chanulee/audiostream-esp32/hardware/lovelace-as-008/REVIEW_NETLIST.md

# 넷리스트 독립 검토 (1단계) — 2026-10-16, AS-003 rev A에서 수행, AS-004·AS-005·AS-006 rev A에 해당, AS-007은 J2 배정만 다름(REVIEW.md 2번), AS-008은 U6 ITIMER에 미실장 C26 랜드(ITIMER 넷)만 더함

DRC·ERC·parity·Gerber netcheck는 모두 `plan_pcb.py`를 정답으로 삼습니다. 그래서 넷리스트 자체가 틀리면 전부 0으로 통과합니다. 이 검토는 **데이터시트만 보고 핀별 기대값을 먼저 적은 뒤** 넷리스트와 비교했습니다. 기대값 표는 [`pinout_check.py`](pinout_check.py)에 있고, `make_board.sh`가 배치 검사 직후 실행합니다. 하나라도 다르면 빌드가 멈춥니다.

## 0. 현재 주문 파일 (AS-008 rev A)

아래 해시는 2026-10-20 현재 파일에서 계산했습니다. 앞의 AS-003 독립 검토와 아래의 과거 기록은 설계 근거이며, 주문 파일 지정은 이 절을 따릅니다.

| 파일 | SHA-256 |
|---|---|
| [`lovelace-as-008-revA-release.zip`](lovelace-as-008-revA-release.zip) | `01da18469ebcb7702c129164d3dc142bf781da75446652fb82398336b2845529` |
| [`bom.csv`](bom.csv) | `63efb1a932b8444062064e5163f01547d461f085fff92a41f919e3ea00788fb6` |
| [`cpl.csv`](cpl.csv) | `d836b545e0dbe416fe5d3f2d6747f33e5226ebdd0a2a1dfac366df7fc4c0a239` |

주문에는 이 폴더의 세 파일을 함께 사용합니다. ZIP 안의 BOM·CPL도 외부 파일과 같아야 합니다. 보드를 바꾸거나 파일을 재생성하면 다시 검증하고 해시를 갱신하세요. 주문 화면에서 확인할 항목은 [BRINGUP.md 1절](BRINGUP.md)에 있습니다.

사용자가 전달한 재검토 결과(2026-10-20): DRC·미연결·parity·ERC 0건, 핀 142/142·패드 55/55·디커플링 19/19, Gerber 쇼트·단선·구리 없는 패드 0건, ZIP 17개 파일 및 실장 부품 53개 일치. 아래의 138/138 등은 2026-10-16 검토 당시 수치입니다. 실물 및 JLC 최종 배치 화면 검증은 남아 있습니다.

## 1. 핀 대조 결과: 138 / 138 일치

| 부품 | 근거 | 확인한 것 | 결과 |
|---|---|---|---|
| U1 ESP32-WROVER-E | Espressif 데이터시트 표 3·그림 5 | 39개 핀 번호와 이름, 사용하는 12개 핀의 넷 | 일치 |
| U1 스트래핑 | 같은 문서 표 4 (Boot Configurations) | IO2·IO12(MTDI)·IO15(MTDO)·IO5는 연결 없음 → 내부 풀 기본값(다운로드 가능, 3.3V 플래시). IO0은 10k 풀업 + 버튼 | 문제 없음 |
| U1 EN | 같은 문서 9절 (RC 지연 10kΩ / 1µF 권장) | R5 10k + C1 1µF | 일치 |
| U2 PCM5102A | SLAS859C Pin Functions, 표 12 | 20핀 전부. DEMP·FLT·FMT·SCK = GND(디엠퍼시스 끔, 일반 필터, I2S, BCK에서 PLL). LDOO 0.1µF(표 12), 470Ω/2.2nF 출력 RC | 일치 |
| U2 클럭 | SLAS859C (16비트에서 BCK 32/48/64fS 허용) | 펌웨어는 16비트 Philips 스테레오 = 32fS, BCK 21 / WS 18 / DO 19 / MUTE 22 / LED 23 / 버튼 0 | 일치 |
| U3 TPS62162 | SLVSAM2E Pin Functions | 8핀 + EP. FB → AGND(고정 전압판 권장), PG 연결 없음. 2.2µH + 22µF는 표 2의 표준 조합 | 일치 |
| U4 TPS7A2033 DBV | TPS7A20 Pin Functions (SOT-23 열) | 1 IN, 2 GND, 3 EN(IN에 묶음), 4 NC, 5 OUT. 출력 용량 약 30µF(허용 1–200µF) | 일치 |
| U6 TPS259470A | SLVSFC9C 표 5-1 | 10핀. AUXOFF·FLT 개방 허용(오픈 드레인), ITIMER 개방 = 가장 빠른 응답 | 일치 |
| U6 계산 | 같은 문서 7.3.5, 전기 특성 | OVLO 1.2×(1+383/100) = 5.80V, UVLO 1.2×(1+255/100) = 4.26V, ILIM = 3334/5.1k = 0.65A(데이터시트 ±15% → 0.56–0.75A), A = 자동 재시도(110ms) | 일치 |
| U5 USBLC6-2SC6 | ST 핀 배치(1/6 I/O1, 3/4 I/O2, 2 GND, 5 VBUS) | D+ 1·6, D− 3·4, VBUS = +5V | 일치 |
| U7 CH340N | WCH 핀 배치, JLC 심볼 | 1 UD+, 2 UD−, 5 VCC + 8 V3 = 3.3V, 6 TXD → ESP32 RXD0, 7 RXD ← ESP32 TXD0(교차 맞음) | 일치 |
| J1 HRO TYPE-C-31-M-12 | JLC 심볼 | D+ A6/B6, D− A7/B7, CC1/CC2에 각각 5.1k, SBU 연결 없음 | 일치 |
| D5·D4·C25 극성(JLC 번호 기준) | JLC 심볼 + 부품 데이터 | D5 K = +5V_DAC, D4 K = GND, C25 + = +5V_DAC | JLC 번호 기준 일치. D4 제조사 번호와의 차이는 [REVIEW.md 11번](REVIEW.md) 확인 필요 |
| BOM 실제 부품 | JLC 부품 API의 LCSC 번호별 설명 | 33개 LCSC 번호가 의도한 값·정격·패키지와 일치(예: R14 0.1% 박막, C25 T520B227M006ATE025) | 일치 |

**검사기 자체 확인:** `design.json` 복사본에서 CH340N TXD/RXD를 바꾸고 PCM5102A FMT를 3.3V로 바꿨더니, 세 곳 모두 MISMATCH로 잡고 종료 코드 1을 냈습니다.

## 2. 핀은 맞지만 확인이 필요한 것

1. **[Minor, 실측 확인 — R15 5.1k 유지, 절차는 [BRINGUP.md](BRINGUP.md) 7절] eFuse 전류 제한 여유는 약 40%입니다.** ESP32-WROVER-E 데이터시트 표 16에서 모듈 피크는 350mA입니다(802.11b 1Mbps, 19.5dBm, 송신 100% 듀티). 버크 효율을 85%로 잡으면 4.75V 입력에서 0.29A이고, DAC LDO 31mA와 CH340N·LED를 더하면 약 0.33A입니다. ILIM 최소값 0.56A보다 0.23A 낮습니다. 시뮬레이션(4절)에서는 3.3V 쪽 피크가 0.6A(5V 입력)·0.5A(4.4V 입력)까지 버텼습니다. 데이터시트 피크의 1.4–1.6배입니다. 처음 적은 0.45A는 데이터시트의 "외부 전원은 0.5A 이상 공급" 권장값을 부하로 잘못 쓴 계산이었습니다. 그 값은 공급 능력 기준이고 실제 부하가 아닙니다. Bluetooth와 Wi-Fi는 시분할이라 전류가 더해지지 않습니다. TPS259470A는 한계를 넘으면 끊지 않고 전류를 제한합니다. 그래도 버크는 입력이 약 3.5V 이상이면 3.3V를 유지하므로, 문제는 ESP32 리셋 외에 DAC 전원·출력 잡음으로도 나타날 수 있습니다. 첫 보드에서는 웹 UI의 리셋 원인과 업타임으로 이를 확인합니다. 리셋이 생기면 R15를 4.3k로 바꿉니다(0.78A, 0.66–0.89A). 다만 Rd만 있는 USB-C 기본 전원 상한(500/900mA)에 가까워집니다.
2. **[Minor] 인덕터 포화 전류 2.1A < TPS62162 전류 제한 최대 2.45A.** Murata DFE201612P-2R2M 표의 최대값은 인덕턴스 30% 감소 기준 2.1A(typ 2.3A), 온도 상승 40°C 기준 1.5A(typ 1.8A)입니다(이전 판은 둘을 뒤바꿔 적었습니다). 정상 부하(피크 약 0.6A)에서는 문제가 없습니다. 3.3V 쇼트나 과부하 때만 인덕터가 포화합니다.
3. **[Minor] 상태 LED가 어두울 수 있습니다.** `plan_pcb.py` 주석은 Vf를 약 2.9V로 적었지만, JLC 데이터의 KT-0603G는 5mA에서 Vf 3.1V(에메랄드 그린)입니다. 3.3V와 220Ω이면 약 1–2mA라 어둡게 켜집니다. 밝기가 중요하면 R18을 100Ω으로 바꿉니다.
4. **[Minor] C25 감액.** 6.3V 폴리머 탄탈은 10% 감액 기준으로 5.67V까지 권장됩니다. 평소 4.7V에서는 문제없고, 입력이 OVLO 한계 6.0V일 때만 약 5.7V가 됩니다.

## 3. 아직 독립 출처가 하나뿐인 것

- CH340N, USBLC6, HRO USB-C는 JLC 심볼과 알고 있는 핀 배치로만 대조했습니다. 제조사 PDF 원문(WCH CH340DS1, ST USBLC6-2, HRO 도면) 대조가 남았습니다. ST 다운로드는 이번에 실패했습니다.
- PJ-320D의 Tip/Ring은 REVIEW.md 2번 그대로입니다(Shou Han 도면에 핀 기능 표기 없음). 첫 보드에서 좌/우 테스트 음원으로 확인합니다.

## 4. 전원 경로 시뮬레이션 (ngspice, 2026-10-20 보강)

[`sim/power_path.py`](sim/power_path.py)는 USB/케이블 → eFuse → 버크/ESP32 및 D5/C25/LDO/DAC를 모델링합니다. 최신 결과는 [`reports/sim.json`](reports/sim.json), 검사 범위와 보드 검증 결과는 [VALIDATION_RESULTS.md](VALIDATION_RESULTS.md)에 있습니다.

- 기동 3조건과 0.37A 펄스 부하 6조건은 기존 기준(3V3 3.2V 이상, 전류 제한 조건)을 유지해 통과했습니다. 0.5–0.9A의 과부하 탐색 30조건은 `STRESS_ONLY`로 분리하며 전부 정상 동작했다는 뜻이 아닙니다.
- 홀드업은 입력 5.0/4.4V × ESP 80/250mA × C25 220/176µF × DAC 31/45mA = 16조건입니다. 4.4V 입력은 저전압 스트레스이고, 실제 기동 가능 여부에는 UVLO 오차도 영향을 줍니다.
- DAC 세 전원이 공통이므로 DVDD/CPVDD 권장 하한 **3.1V**를 기준으로 측정합니다. clock-stop 기준은 **3ms**, XSMT 경로는 별도로 **150/fs + 0.2ms**입니다. XSMT 파형은 모델에 없어서 `UNVERIFIED`로 남깁니다. 과거 clock-loss에 3.6ms 공식을 적용한 설명은 이 절로 대체합니다.

| 입력 / ESP 부하 | C25 / DAC 부하 | 클럭 정지 가정 후 3.1V까지 | clock-stop 판정 |
|---|---|---:|---|
| 5.0V / 80mA | 220µF / 31mA | 11.029ms | PASS |
| 5.0V / 80mA | 176µF / 45mA | 5.765ms | PASS |
| 4.4V / 80mA | 220µF / 31mA | 6.731ms | PASS |
| 4.4V / 80mA | 176µF / 45mA | 3.441ms | PASS |
| 4.4V / 250mA | 176µF / 45mA | 3.569ms | PASS |

최소 결과는 3ms 기준 대비 **0.441ms** 여유입니다. ESP32 2.43V 도달 시 I2S가 멈춘다는 가정, 이상적인 버크, LDO 고정 20mV 강하, 저항성 DAC 부하는 유지했습니다. 45mA는 25°C 데이터시트 조건이며 모든 온도의 최대값을 보장하지 않습니다. 실제 전류·클럭 정지·mute·팝·스위칭 과도응답은 미검증입니다.

**다시 돌리기:** `python3 sim/power_path.py`(PATH에 ngspice 필요). 기준 미달은 exit 1, 해석 미완료/timeout/측정 누락/수렴 오류는 `UNVERIFIED`와 exit 2입니다. 마지막 해석 시각과 모든 필수 측정값의 유한성까지 확인합니다. `make_board.sh`도 release 생성 전에 이 검사를 실행합니다. 회귀 테스트는 저장소 루트에서 `python3 -m unittest discover -s tests -p test_hardware_validation.py -v`로 실행합니다.

## 다음 단계

2단계(물리 대응): 각 MPN 도면으로 랜드 패턴과 1번 핀 표시를 확인하고, 커넥터 방향, 케이스 간섭, 3D 모델을 봅니다.
