chanulee/audiostream-esp32/hardware/lovelace-as-008/REVIEW.md

# AS-003 rev A 검토 — 2026-10-15 (AS-004, AS-005, AS-006, AS-007, AS-008에도 해당)

(AS-002 rev C를 검토하며 찾은 문제를 고쳐 AS-003으로 올렸습니다. 이전 판은 [archive/04](../archive/04-lovelace-as-002-revC/README.md). AS-004는 넷리스트·배치가 AS-003과 같아 아래 내용이 그대로 적용됩니다. 배선 변경은 [REVIEW_LAYOUT.md](REVIEW_LAYOUT.md)에 있습니다.)

범위: 넷리스트, 배치, 배선, 제작 파일, JLC 조립 데이터, 펌웨어 핀 대응, 제조사 데이터시트 대조. 도구는 다음과 같습니다.
- pcb-layout-skill(`placement_check`, `audit_release`, `gerber_check`)
- KiCad 10 DRC/ERC/parity, `audit_pcb.py`, `jlc_check.py`
- KiCadRoutingTools v0.23.0, FreeRouting 2.5.0(비교용)

데이터시트: TI PCM5102A(SLAS859C), TPS62162(SLVSAM2E), TPS25947(SLVSFC9C), TPS7A20(SBVS338), Espressif ESP32-WROVER-E v2.4, Shou Han·HRO PJ-320D 도면, JLC/EasyEDA 부품 데이터(BOM 전 부품).

**실물 측정은 없습니다.** 첫 보드 절차는 [BRINGUP.md](BRINGUP.md)에 있습니다.

## 발견 사항 (심각도 순)

1. **[Critical, 수정함] CPL 회전이 JLC 기준과 달랐음.** KiCad와 JLC(EasyEDA)는 같은 패키지의 0° 방향이 다릅니다. KiCad 회전을 CPL에 그대로 쓰면 U2(PCM5102A) 180→90, U4(LDO) 0→180, U5(USBLC6) 0→270, U7(CH340N) 0→270, C25(탄탈) 90→270이 됩니다. 즉 IC 4개가 돌아가고 탄탈 극성이 뒤집힌 채 실장됩니다. 수정: `jlc_check.py`가 JLC 풋프린트를 받아 핀 번호 기준으로 우리 패드에 맞추고, 그 회전과 원점으로 `cpl.csv`를 씁니다. 53개 부품 모두 일치하며 IC 오차는 0.05mm 이하입니다. 남은 확인: JLC 주문 화면의 배치 미리보기(BRINGUP.md 표). 신뢰도: 높음.
2. **[Major, 수정함] AUX 잭 Tip/Ring 배정 오류.** KiCad 풋프린트의 패드 이름(T/R1/R2/S)이 실제 접점과 맞지 않았습니다. HRO 도면과 접점 깊이로 보면 뒤쪽 단독 패드가 Tip입니다. 수정 전에는 Tip이 접지되고 R이 슬리브와 쇼트됐습니다. `audit_pcb.py`가 개구부에서의 거리 순서로 검사합니다. 남은 확인: 첫 보드에서 좌/우 테스트 음원. 신뢰도: 중간(Shou Han 도면에 핀 기능 표기 없음).
   **[Major, AS-007에서 다시 수정] 위 배정도 틀렸습니다.** 단자 위치를 접점 위치로 본 가정이 틀렸습니다. LCSC 엔지니어 회신(2026-10-16)은 A = Tip, D = Ring 1, C = Ring 2, B = Sleeve이고, 도면 회로도(OA–OD)의 순서와도 같습니다. AS-006까지는 D가 GND, B가 LINE_R이어서 오른쪽 채널이 나오지 않았을 것입니다(LINE_R이 상대 기기 접지로 들어가고 플러그의 Ring은 접지됨, 470Ω R12가 전류를 제한해 손상은 없음). AS-007은 D = LINE_R, B·C = GND이고, `pinout_check.py`에 J2 항목을 추가했습니다. 신뢰도: 높음(제조사 측 회신 + 도면 회로도). 남은 확인: 실물 잭 연속성 또는 첫 보드 좌/우 음원.
3. **[Major, 수정함] 팝 잡음.** XSMT가 +3V3_D에 묶여 있어 부팅·리셋·샘플레이트 변경·전원 차단 때 팝을 막을 수단이 없었습니다. 수정 내용은 다음과 같습니다.
   - XSMT를 GPIO22 + 10k 풀다운(기본 뮤트)으로 바꿨습니다. 펌웨어는 I2S가 20ms 돈 뒤 해제하고, 클럭 변경·flush·재시작 전에 다시 뮤트합니다.
   - DAC 전원(AVDD·CPVDD·DVDD)을 모두 LDO(+3V3_A)로 옮겼습니다. LDO 입력은 쇼트키 D5와 220µF C25로 홀드업합니다. USB를 뽑으면 ESP32가 먼저 꺼져 클럭이 멈추고, DAC는 계산상 9.6ms(4.4V 입력에서 5.3ms) 동안 전원을 유지해 3.6ms짜리 클럭 정지 소프트 뮤트를 마칩니다.
   - 부수 효과로 LDO 입력이 OVLO 상한(6.0V)에서도 5.7V가 돼 TPS7A20 권장 최대(6.0V) 아래로 내려갔습니다.

   남은 확인: BRINGUP.md 6절의 네 가지 상황을 앰프로 들어 보거나 오실로스코프로 확인. 신뢰도: 중간(데이터시트 동작 + 계산, 실측 없음).
4. **[Major] 풋프린트 세부 차이(JLC 대조).** 중심과 대칭은 맞고 패드 길이만 다른 부품들입니다. U1 0.25, U7 0.21, D2/D3/D5 0.12–0.16, C25 0.26, L1 0.28, J2 0.44mm입니다.
   - J2: Shou Han 도면(단독 패드 1.1mm)은 KiCad와 같고 JLC 풋프린트(1.4mm)가 다릅니다. AS-006부터 축에서 패드까지 거리도 도면(3.85mm)을 따르고 JLC는 3.5mm라 차이가 0.40mm입니다. CPL은 위치 결정 핀 기준이라 이 차이가 배치에 영향을 주지 않습니다.
   - L1: KiCad DFE201610P 랜드와 JLC 일반 0806 랜드가 다릅니다. 2026-10-16 독립 재검수에서 실제 랜드(패드 0.55 × 1.60mm, 간격 0.90mm)가 Murata 권장 패턴과 같음을 확인했습니다.

   신뢰도: 중간.
5. **[Major] OVLO 허용 범위.** R13 1%(C163468, Yageo; EasyEDA 데이터가 없는 C5126206에서 교체), R14 0.1%입니다. 정적 최악조건 OVLO 창은 5.63–6.00V(공칭 5.80V), UVLO 켜짐은 4.13–4.39V, 전류 제한은 R15 5.1k(Basic으로 교체)에서 0.56–0.75A입니다. 돌입전류는 +5V 쪽 10mA 미만, C25 충전은 0.38V/ms × 220µF = 84mA 이하입니다. 수정: 5.0/5.5/5.9/6.0V 입력에서 차단 여부와 기동 파형을 실측. 신뢰도: 높음(계산).
6. **[Major] RF와 Wi-Fi/BT 공존 미측정.** 안테나 돌출(Espressif 배치 1안), 모듈 아래·안테나 띠의 via/배선 금지는 유지됩니다. H1은 안테나 끝에서 약 11mm라 나일론 나사를 권장합니다. 수정: 케이스 장착 상태에서 RSSI, A2DP 끊김, AirPlay 언더런 측정.
7. **[Minor] 윗면 GND 붓기 분할.** F.Cu GND가 큰 조각 두 개(568·196mm²)와 작은 조각들로 나뉩니다. 각 조각은 via로 L2 GND 평면에 붙어 있고, 기준면은 L2입니다. FreeRouting 배선은 한 덩어리(846mm²)였습니다.
8. **[Minor] 자동 다운로드 모드 없음.** 버튼(IO0)을 누른 채 USB를 꽂아야 합니다. 바닥 EN 패드를 GND에 대면 리셋됩니다.
9. **[Minor, AS-006에서 해결] 3D 모델 없음.** HRO TYPE-C-31-M-12, PJ-320D, WROVER-E의 STEP 모델이 KiCad 기본 라이브러리에 없었습니다. AS-006부터 LCSC/EasyEDA STEP(C165948, C431535, C2973667)을 `lib/3d/`에 두고 연결했습니다. J2 모델은 바닥면 렌더에서 위치 결정 핀 2개가 NPTH 홀 중심에 오도록 놓았습니다(CPL과 같은 기준). J1은 처음 넣은 보정값(y +0.471, z −0.85)이 틀려 셸 앞면이 1.5mm 안쪽, 0.85mm 아래에 있었습니다. 다른 장비에서 찾은 보정값(y −1.05, z 0, e3a4185)으로 고쳤고, AS-007에서 셸 앞면이 풋프린트 외형선(41.05mm)과 0.05mm 안에서 맞고 다리 4개가 슬롯 안에 있는 것을 확인했습니다. PCB의 J1 패드·슬롯은 바뀌지 않았습니다(모델 문제). WROVER-E 모델은 EasyEDA의 WROVER-IE 모델이라 IPEX 커넥터가 함께 그려지며, 외형 치수는 같습니다.

10. **[Minor, LCSC 회신으로 확인] C25 전압 감액.** T520B227M006ATE025(6.3V 폴리머, 105°C 정격). LCSC가 2026-10-19에 KEMET 공식 기준을 확인해 줬습니다. 10V 이하 부품은 85°C까지 정격의 90%(5.67V)가 권장 상시 동작 전압입니다. 함께 받은 KEMET 부품 사양서(2018-09-12 생성)에는 감액 항목이 없습니다. C25에는 입력에서 D5 강하(약 0.25V)를 뺀 전압이 걸립니다.
   - USB 규격 범위(최대 5.5V)에서는 약 5.25V(83%)로 권장값 안입니다.
   - 규격 밖 전원으로 입력이 5.92–6.0V일 때(OVLO가 끊기 직전)만 최대 약 5.75V가 걸려 권장값을 0.08V 넘습니다. 정격 6.3V와 서지 전압보다는 낮습니다. LCSC는 이 조건의 수명 여유를 설계자가 판단하라고 답했습니다.
   - 판단: 고치지 않습니다. 정상 USB 전원에서는 생기지 않는 조건입니다. 다음 판에서 바꿀 일이 생기면 10V급 220µF(같은 크기에 있으면)나 OVLO 하향(R13)을 함께 검토합니다. 신뢰도: 높음(제조사 기준 + 계산, 실측 없음).

11. **[Minor] D4 LED 극성 표기 확인 필요.** KENTO KT-0603G 사양서(2018-12-06, A.0) 2절 도면은 ① 쪽에 +(애노드), ② 쪽 모서리에 초록 표시(캐소드)를 그립니다. JLC/EasyEDA 풋프린트는 1번 패드를 K(캐소드)로 둡니다. 번호 체계가 서로 반대일 뿐 JLC 실장 방향은 맞을 가능성이 높지만, 사양서만으로는 단정할 수 없어 LCSC에 확인을 요청합니다. VF는 5mA에서 2.6–3.1V라 3.3V와 R18 220Ω으로는 약 1–3mA가 흐르고, 밝기는 낮지만 표시용으로는 충분합니다. 틀리면 LED만 켜지지 않습니다.

## 이번에 확인한 것

| 항목 | 방법 | 결과 |
|---|---|---|
| DRC 위반이 릴리스를 막는지 | 트랙 하나를 0.3mm 옮긴 보드로 실행 | 종료 코드 5, 릴리스 단계 도달 안 함. ERC는 같은 옵션을 쓰고 이번 작업 중 실제 ERC 위반(+5V_DAC 구동원 없음)에서 멈추는 것을 확인 |
| ignore된 DRC 규칙 | 모두 error로 바꿔 실행 | 가장자리 실크 정리와 U1 방열 via뿐. 패드 형상 비교를 감사에 추가(54/54) |
| IC 핀 표 | 데이터시트 + JLC 심볼 | U1–U7 핀 이름·번호 일치 |
| 랜드 패턴 | Espressif, TI 도면, JLC 풋프린트 | WROVER-E·TPS25947 일치, 나머지는 위 4번 |
| CPL 회전·원점 | JLC 풋프린트를 핀 번호로 맞춤 | 53/53, 회전 5개 수정 |
| 재고·부품 종류 | JLC 부품 API | 전 부품 재고 100개 이상, Extended 19종 |
| 라우터 비교 | 같은 배치·입력, 넷 종류별 렌더와 지표 | KiCadRoutingTools 채택(README 표) |
| 재현성 | `make_board.sh` 2회 실행 | 구리 항목 동일 |
| 펌웨어 | `pio run -e lovelace-as-003`, 호스트 테스트 | 빌드 성공(sdkconfig 차이는 MUTE_GPIO 한 줄), 호스트 테스트 통과 |

하지 않은 것: TPS62162 PSpice/TINA 과도응답 시뮬레이션(실제 PCB 기생 성분을 반영하지 못해 첫 보드 실측으로 대신), 실물 측정 전부.

## 검사 결과

| 검사 | 결과 |
|---|---|
| `placement_check.py` | ERROR 0, WARN 0, 점유율 75% |
| KiCad DRC / parity / ERC | 0 / 0 / 0 (위반 시 `make_board.sh` 중단) |
| 디커플링 패드 거리 | 19 / 19 |
| 라이브러리 패드 / JLC 데이터 / AUX 접점 순서 | 54/54, 53/53, LINE_R·GND·GND·LINE_L (AS-007) |
| `audit_release.py` | 0 오류, 0 경고 (BOM / CPL 포함) |
| `gerber_check.py netcheck` | shorts 0, opens 0 |
| 바닥 테스트 패드 | 11 / 12 (XSMT는 R10 패드 사용) |

## 전원 경로

| 경로 | 전류 | 계산 요구 | 실제 |
|---|---:|---|---|
| VBUS → eFuse → +5V | 0.75A (ILIM 최대) | 1oz 외층 0.211mm(+10°C) | 0.3mm 이상(일부 0.4mm) |
| +5V → D5 → +5V_DAC → LDO | 31mA | | 0.3mm |
| 버크 SW | 1A 피크 | | 0.6mm, 패드 진입 0.25mm |
| +3V3_D | ≈0.5A | | L3 평면 + 부품별 via |
| +3V3_A (DAC 전체) | 31mA | LDO Tj 여유 큼 | 0.3mm |
