chanulee/audiostream-esp32/hardware/lovelace-as-007/REVIEW_LAYOUT.md

# 배선·펌웨어 검토 — 2026-10-16 (AS-003 rev A 검토, 수정 결과는 AS-004 rev A)

AS-003 rev A 보드 파일(`lovelace-as-003.kicad_pcb`, [archive/05](../archive/05-lovelace-as-003-revA/README.md))을 KiCad Python으로 직접 읽어 수치로 검사했습니다. 대상은 배선, via, 평면, 패드, 부품 외곽입니다. 펌웨어는 소스와 `sdkconfig.lovelace-as-003`(지금은 `lovelace-as-004` 환경)을 읽었습니다. 1번 수정은 배선만 바꿨으므로 보드 번호를 AS-004로 올렸습니다. 넷리스트 검토는 [REVIEW_NETLIST.md](REVIEW_NETLIST.md)에 있습니다. 실물 측정은 없습니다.

## 발견 사항

### 주문 전에 고칠 것

1. **[Major, 수정함] 상단 SMD 패드 안에 via가 4개 있었습니다.** 모두 KiCadRoutingTools가 만든 것입니다. 메우지 않은 via가 마스크 개구부 안에 있으면 tenting이 적용되지 않습니다. 그래서 리플로 때 땜납이 구멍으로 빠져 접합이 약해지거나, 0402가 한쪽만 붙어 서는 툼스톤이 생길 수 있습니다. KiCad DRC는 같은 넷의 via와 패드를 검사하지 않아 통과했습니다.

   | 위치 | 패드 | via | 접합이 실패하면 |
   |---|---|---|---|
   | R17 패드 1 (POWER_EN) | 0402, 0.64 × 0.54mm | Ø0.54 / 드릴 0.29, 패드를 거의 덮음 | UVLO 분압이 사라져 EN이 VBUS 전압을 그대로 받음. UVLO 기능 없음 |
   | R10 패드 2 (XSMT) | 0402, 0.54 × 0.64mm | Ø0.6 / 0.3, 패드보다 큼 | XSMT 풀다운이 없어짐. 부팅 중 뮤트가 보장되지 않아 전원 투입 팝 가능 |
   | U4 1번 핀 (+5V_DAC, LDO 입력) | SOT-23-5, 1.32 × 0.6mm | Ø0.6 / 0.3, 패드 중앙 | LDO 입력 접합 불량 → DAC 전원 없음 → 소리 없음 |
   | U1 34번 핀 (UART_RX) | 모듈 패드 1.5 × 0.9mm | Ø0.6 / 0.3, 패드 가장자리 | 모듈 납땜 불량 → 플래시·로그 불가(바닥 RX 패드로 우회 가능) |

   via 구리는 패드와 붙어 있으므로 전기 연결 자체는 유지됩니다. 문제는 부품 납땜입니다. **수정 내용:**
   - **검사:** `audit_pcb.py`에 상단 SMD 패드에 닿는 via 검사를 넣었습니다. 패드 가장자리에 걸친 via까지 잡도록 하자 6개가 더 나왔습니다(U6.1·U6.2, C10.1, C8.1, R13.2, U7.6). 이 검사는 실패하면 빌드를 멈춥니다.
   - **라우터:** via를 놓는 전원·신호 단계에 `--same-net-pad-clearance 0.1`을 줬습니다.
   - **OVLO·ILIM:** U6 가운데 핀인 이 두 넷은 라우터가 길을 못 찾아 `build_pcb.py`에서 손으로 그렸습니다. OVLO via는 패드에서 0.1mm 이상 떨어뜨렸고, ILIM은 이전과 같은 F.Cu 경로입니다.
   - **테스트 패드 via:** `finish_pcb.py`가 바닥 테스트 패드용 via를 상단 패드에서 띄우도록 했습니다(U7.6이 여기서 나왔음).
   - **오디오 배선 잠금:** 전원 단계가 막히면 DAC_L/R을 뜯어 B.Cu로 옮기는 일이 생겨서, 오디오 단계 직후 오디오 배선을 잠갔습니다.

   결과는 DRC 0, 미연결 0, 패드에 닿는 via 0개입니다. 오디오 넷은 F.Cu 전용이고 길이도 이전과 같습니다(DAC_L 15.0, DAC_R 17.2, LINE_L 14.7, LINE_R 24.3mm). 바닥 테스트 패드의 via는 조립하지 않는 면이라 검사에서 뺐습니다.

2. **[Major, 주문 설정] 보드 밖으로 나가는 부품 때문에 JLC 조립 레일 방향이 정해집니다.** 위쪽으로는 U1 모듈 안테나가 6.2mm, 아래쪽으로는 J2가 2.5mm, J1이 0.5mm 나갑니다. 조립 라인 레일(공정 가장자리)은 왼쪽·오른쪽에만 붙일 수 있습니다. 주문할 때 레일 위치를 지정하거나 JLC 엔지니어 확인을 요청해야 합니다. 위아래에 레일을 붙이면 부품과 겹칩니다. BRINGUP.md 1절에 추가했습니다.

### 첫 보드에서 확인할 것

3. **[Medium] USB 케이블 GND를 통한 잡음.** Wi-Fi 송신 펄스(약 0.3A)가 USB 케이블의 GND 저항(약 0.1Ω)을 지나면 보드 GND가 수십 mV 흔들립니다. 접지된 앰프와 PC USB를 동시에 쓰면 이 전압이 라인 출력에 "지직" 소리로 섞일 수 있습니다. USB 전원 오디오 기기에서 흔한 증상입니다. 절연형 휴대폰 충전기에서는 루프가 생기지 않습니다. BRINGUP.md 5절에 비교 항목을 추가했습니다. 문제가 되면 충전기 사용을 권장하거나 그라운드 루프 아이솔레이터로 대응합니다. 다음 rev에서 바꿀 회로는 아닙니다.

### 다음 rev에서 개선할 것

4. **[Minor] 버크 입력 루프.** C4(입력 10µF)가 U3 VIN·PGND 핀에서 약 3mm 떨어져 있고, 루프는 약 3 × 2mm입니다. 동작에는 문제가 없지만 2.25MHz 스위칭 잡음 방사를 줄이려면 C4를 U3 1·2번 핀 바로 옆에 붙입니다.
5. **[Minor, 펌웨어] 버튼을 누른 채 소프트웨어 리셋.** OTA·설정 저장 뒤 재시작하는 순간 버튼이 눌려 있으면 GPIO0 스트랩 때문에 다운로드 모드로 들어갑니다. USB를 다시 꽂으면 복구됩니다. 사용 설명에 적으면 충분합니다.

## 확인해서 문제없던 것

| 항목 | 방법 | 결과 |
|---|---|---|
| 기준 평면 | F.Cu 배선은 L2 GND, B.Cu 배선은 L3 +3V3_D 채움 위에 있는지 0.1mm 간격으로 샘플링 | I2S, DAC_L/R, LINE_L/R, USB D+ 아래 끊김 0. 공백은 via 자체의 안티패드와 보드 가장자리뿐. L2·L3 각각 한 덩어리, 구멍 0 |
| 잡음 결합 | 민감 넷 16개와 잡음 넷 12개 사이 같은 층 최소 간격 | 가장 가까운 곳은 eFuse dVdt–SW 0.23mm. dVdt에 10nF가 있어 결합 수 µV. OVLO·EN·XSMT·LINE은 SW·I2S에서 0.37mm 이상, SW와는 1mm 이상 |
| 안테나 | Espressif 랜드 패턴(안테나 영역 6.22mm) 대 모듈 위치 | 모듈 위끝이 보드 밖 6.22mm. 안테나 영역 전체가 보드 밖 |
| I2S 길이 | 배선 길이 | BCLK 3.2, DATA 3.3, LRCLK 4.2mm, via 없음 |
| USB | 길이, via | D+ 18.3mm(F.Cu만), D− 15.0mm(via 4개). Full Speed(12Mbps)에서 문제없음 |
| 전원 폭 | 넷별 최소 폭 | VBUS 0.3–0.4mm, +5V 0.25–0.3mm, SW 0.6mm(패드 진입 0.25), via Ø0.6/0.3 |
| GND 귀환 | 디커플링·IC GND 패드에서 가장 가까운 GND via | 0.75–1.25mm(대부분), U3 PGND 2.25mm(C4 GND와 직결), J1 GND 2.2–4.2mm |
| 마스크 다리 | 다른 넷 패드 사이 간격(마스크 확장 0) | U3·U6·J1 0.2mm, U2 0.25mm. JLC 최소 0.1mm 이상 |
| 노출 패드 페이스트 | 페이스트 층 | U1 0.9mm 창 9개 + 열 via 4개, U3 창 2개 + 열 via 2개 |
| 패드 연결 | 존 설정 | GND 붓기 열 릴리프(간격 0.25, 스포크 0.3mm). 0402 양쪽 열 균형 유지. 고립 조각 제거 |
| 펌웨어 I2S 클럭 | `audio_output.c` + PCM5102A 표 11 | 16비트 Philips, BCK 32fS = 1.4112MHz(44.1kHz)·1.536MHz(48kHz). PLL 표에 있는 값, SCK 미사용 |
| 펌웨어 뮤트 | `board.c`, `audio_output.c` | 부팅: GPIO22 리셋 상태는 입력이고 10k 풀다운으로 뮤트. `iot_board_init`가 출력 low로 설정하고, I2S 시작 20ms 뒤 해제. 클럭 변경·flush 전 뮤트 후 5ms 대기, `esp_restart` 전 종료 핸들러. 패닉 리셋 때는 핀이 입력으로 돌아가 풀다운으로 뮤트 |
| 펌웨어 핀 | sdkconfig | BCK 21, WS 18, DO 19, MUTE 22(low = 뮤트), LED 23(high = 켜짐), 버튼 0(내부 풀업 + 외부 10k) |
| 플래시·PSRAM | sdkconfig, `partitions.csv`, 빌드 | 8MB QIO 80MHz, PSRAM Quad 80MHz, OTA 슬롯 3MB 두 개, 현재 펌웨어 2.3MB(77%) |
| 브라운아웃 | sdkconfig | 감지기 켜짐(레벨 0, 약 2.43V). 리셋 원인을 웹 UI에 표시 |

## 다음 단계

1번은 수정했습니다. 다음은 2단계(물리 대응: 랜드 패턴 원문 대조, 커넥터 방향, 케이스 간섭)로 넘어갑니다.
