chanulee/audiostream-esp32/hardware/lovelace-as-007/rendering/svg_viewer.html

# PCB → SVG / Interactive 3D

__BOARD_NAME__ · STEP 모델 __MODEL_COUNT__개 · 실제 3D에서 벡터로

LOCAL · OFFLINE

## 01 / ASSEMBLY — 정면 부품 배치도

도면 면

__TOP_SVG____BOTTOM_SVG__

도면 SVG 다운로드

## 02 / RENDER ENGINE — 실시간 3D 3D 크게 보기

드래그 회전 · 휠 확대 · 방향키 회전 · 더블클릭 초기화

방위각 °고도 °입체위앞아래화면 맞춤

카메라 렌즈 50 mm표면

예시 1 · X-ray예시 2 · 제품 렌더

조명·재질 설정

PCB 색 거칠기 금속 반사 조명 방향 조명 높이 조명 세기 환경 반사 노출 X-ray 면 농도 그림자그림자 부드러움 재질 위 모서리

렌즈는 36×24 mm 센서 기준입니다. 재질·조명은 PNG, SVG는 선택한 카메라의 벡터 선화로 출력됩니다.

이 각도로 정밀 SVG 만들기PNG 만들기3D 모델 로딩 중…

실시간 화면은 STEP 메시와 PCB의 뒷면 실크를 표시합니다. SVG는 선택한 각도로 STEP 원본의 숨은선을 정밀 제거하고, 보이는 뒷면에 실크를 투영합니다. 확대 배율은 미리보기에만 적용됩니다.

뒷면 실크는 PCB의 도형·KiCad 벡터 글꼴로 표시합니다. U6는 STEP 모델이 없어 정면도에만 표시됩니다. 구리 배선과 앞면 실크는 입체도에서 생략됩니다.

## 정밀 SVG

결과 다운로드편집 계속
