chanulee/audiostream-esp32/hardware/lovelace-as-008/renders/latest/index.html

# LOVELACE / AS-008 rev A

버전 기록

## pcba-iso.png



pcba-iso.png (previous)



pcba-iso.png (now)

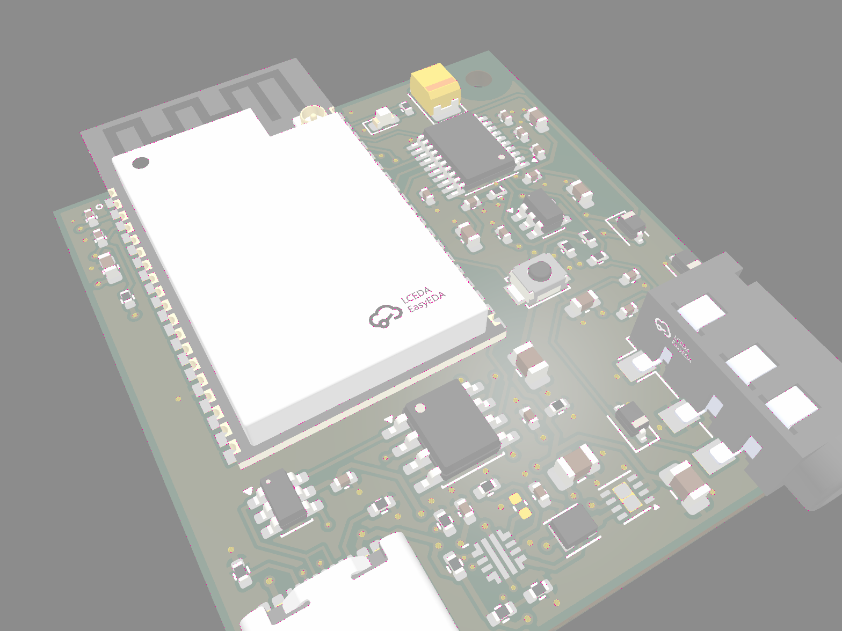
[picture p5: hardware/lovelace-as-008/renders/latest/diff-pcba-iso.png]


changed pixels in magenta

## pcba-top.png

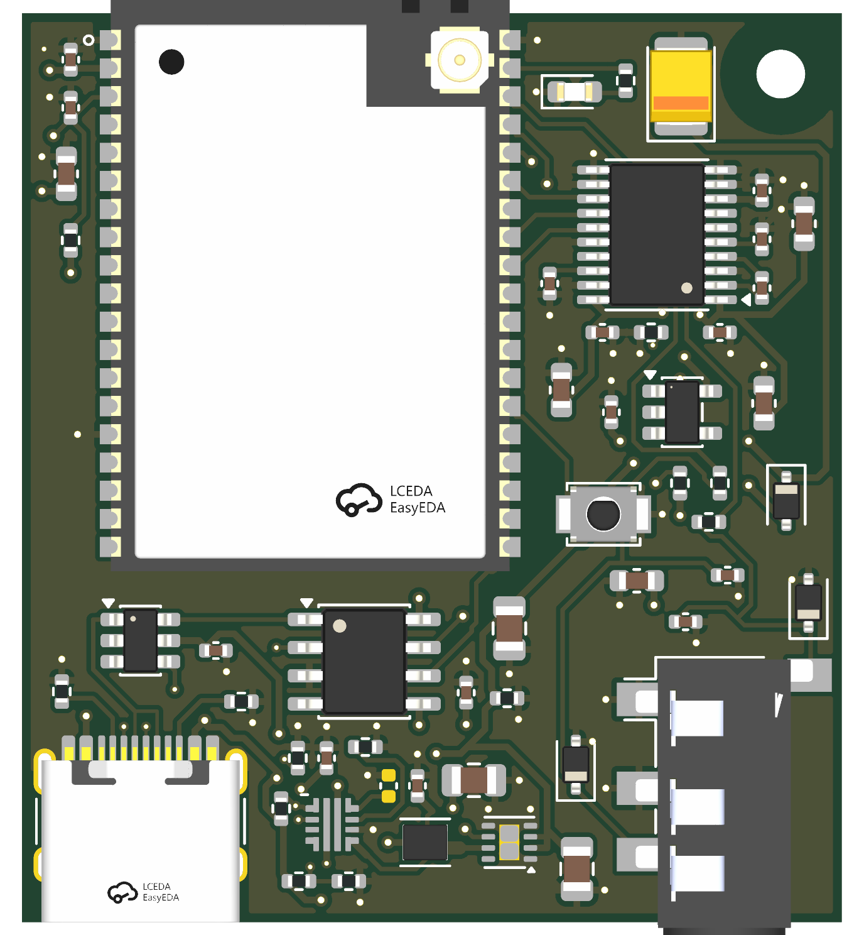
[picture p6: hardware/lovelace-as-008/renders/latest/pcba-top.png]


pcba-top.png (previous)



pcba-top.png (now)

## pcba-bottom.png

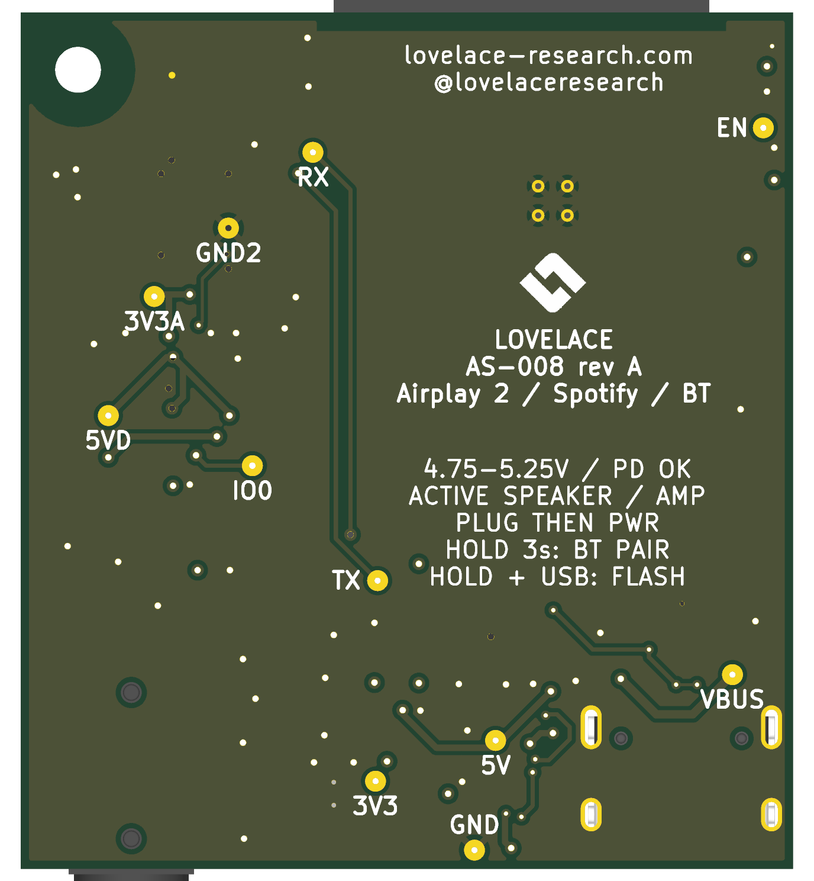
[picture p7: hardware/lovelace-as-008/renders/latest/pcba-bottom.png]


pcba-bottom.png (previous)



pcba-bottom.png (now)

## bare-top.png

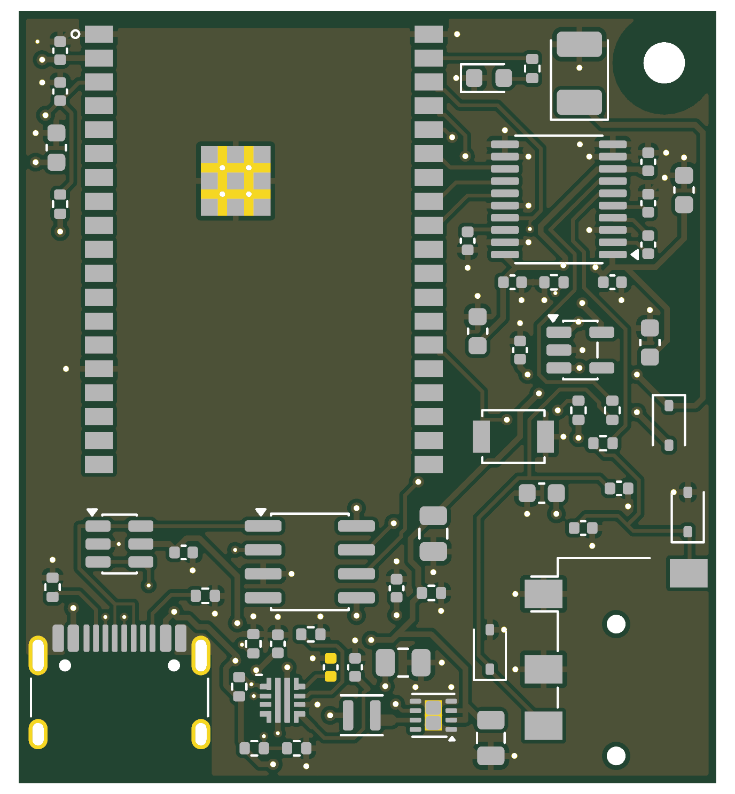
[picture p8: hardware/lovelace-as-008/renders/latest/bare-top.png]


bare-top.png (previous)



bare-top.png (now)

## bare-bottom.png

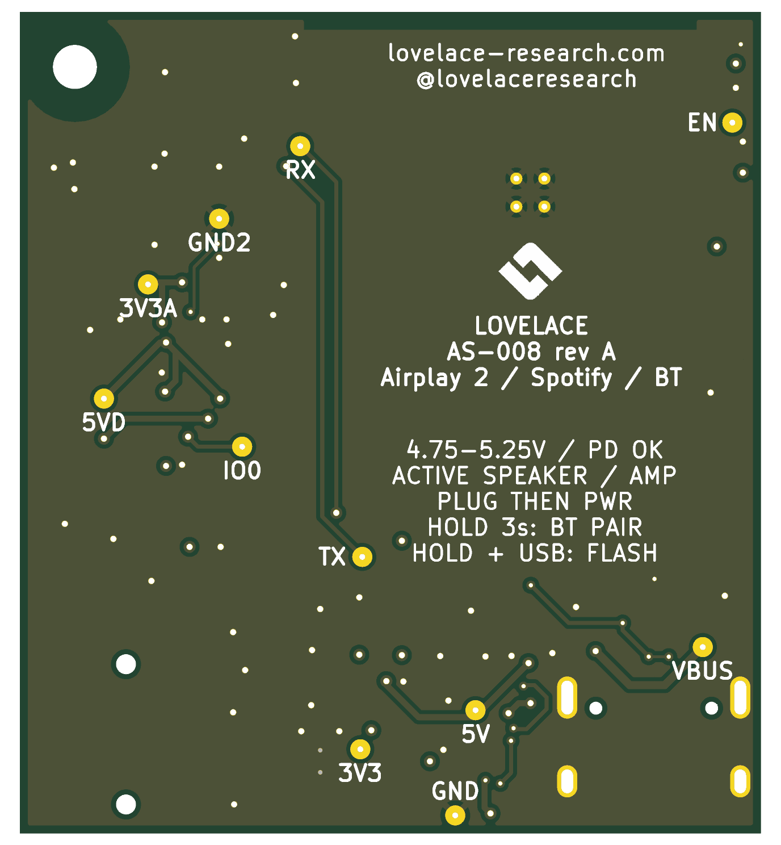
[picture p9: hardware/lovelace-as-008/renders/latest/bare-bottom.png]


bare-bottom.png (previous)



bare-bottom.png (now)

## assembly-top.png



assembly-top.png (previous)

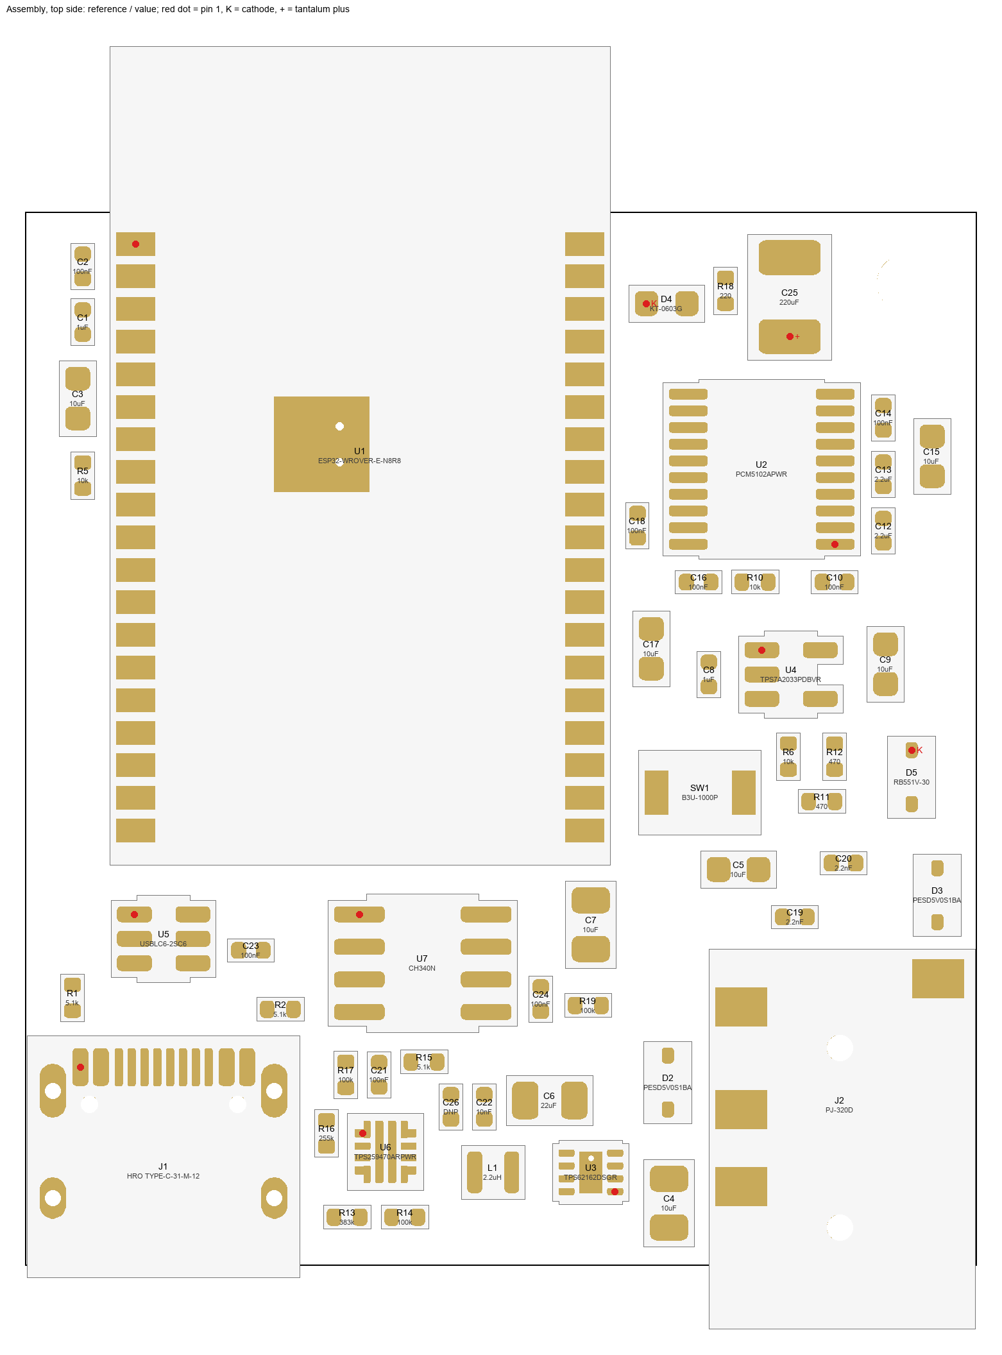
[picture p10: hardware/lovelace-as-008/renders/latest/assembly-top.png]


assembly-top.png (now)

## routing.png

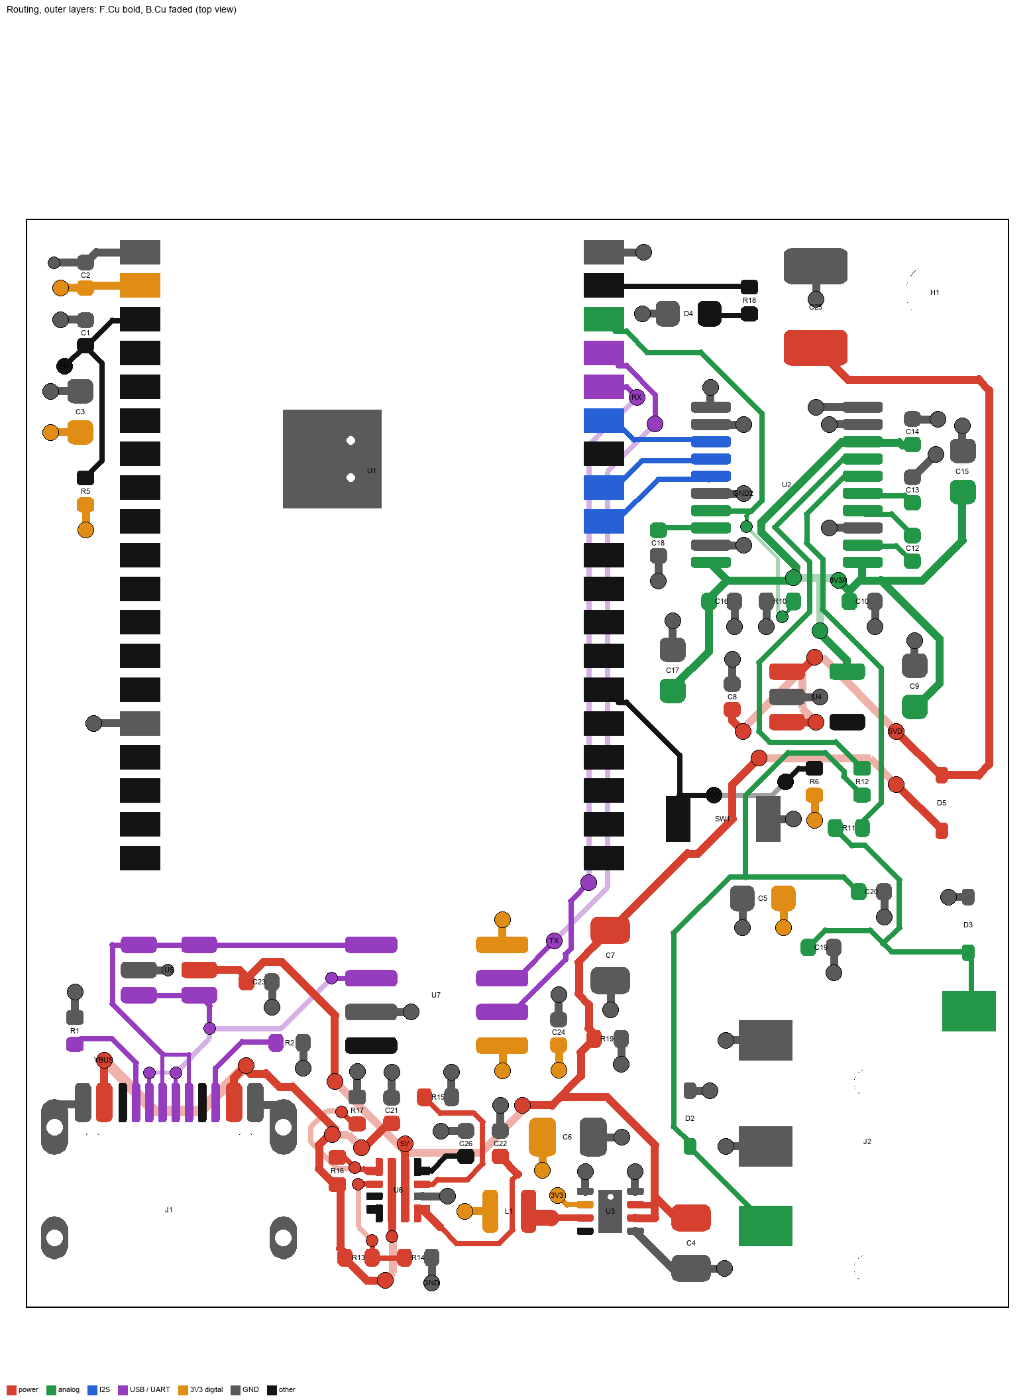
[picture p11: hardware/lovelace-as-008/renders/latest/routing.png]


routing.png (previous)



routing.png (now)

## layer-F_Cu.png



layer-F_Cu.png (previous)

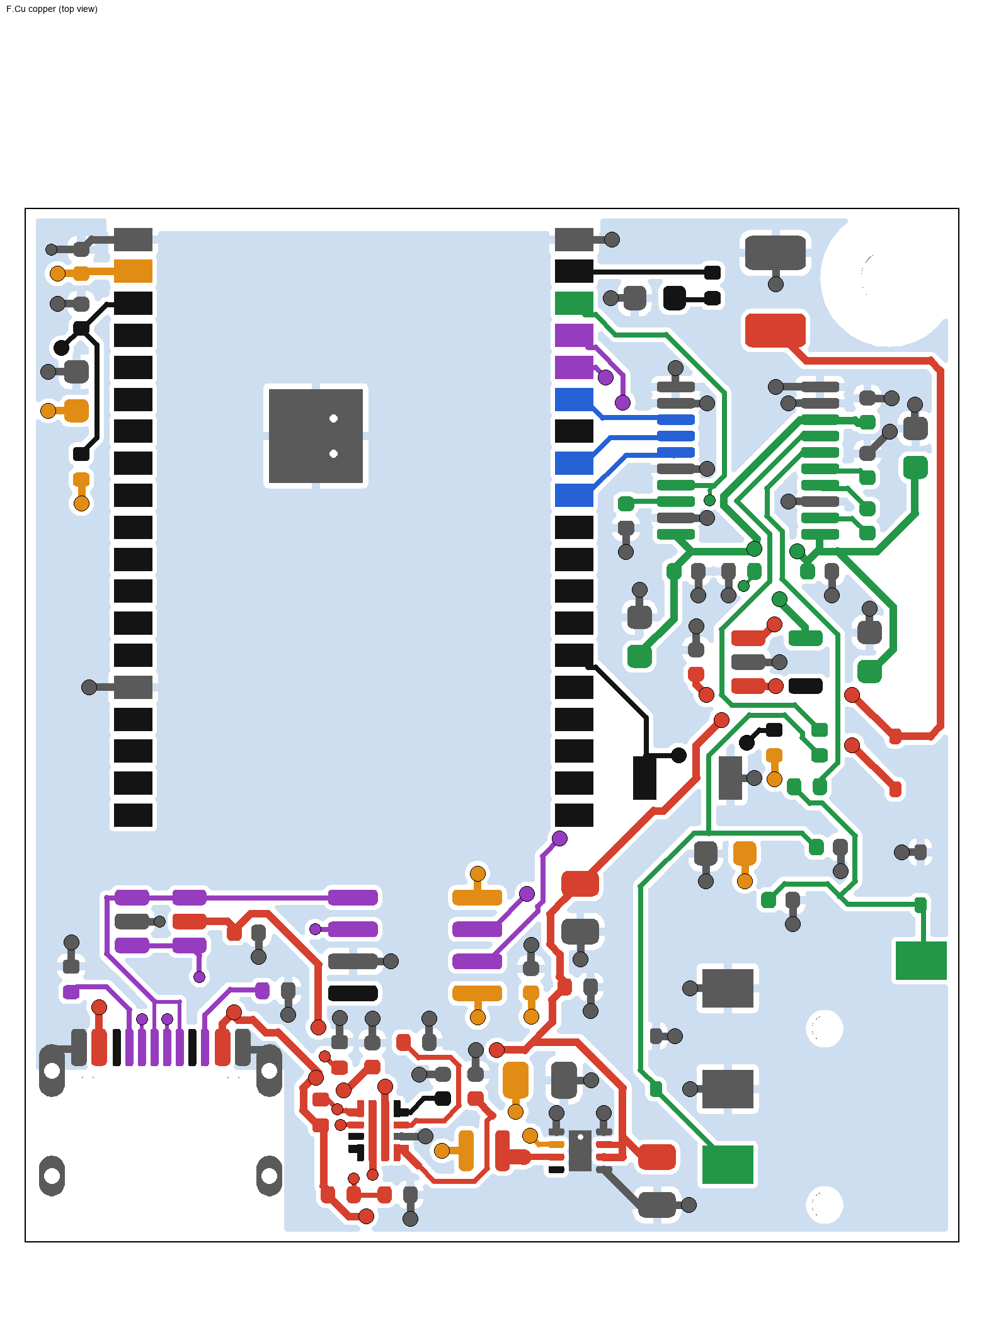
[picture p12: hardware/lovelace-as-008/renders/latest/layer-F_Cu.png]


layer-F_Cu.png (now)

## layer-In1_Cu.png

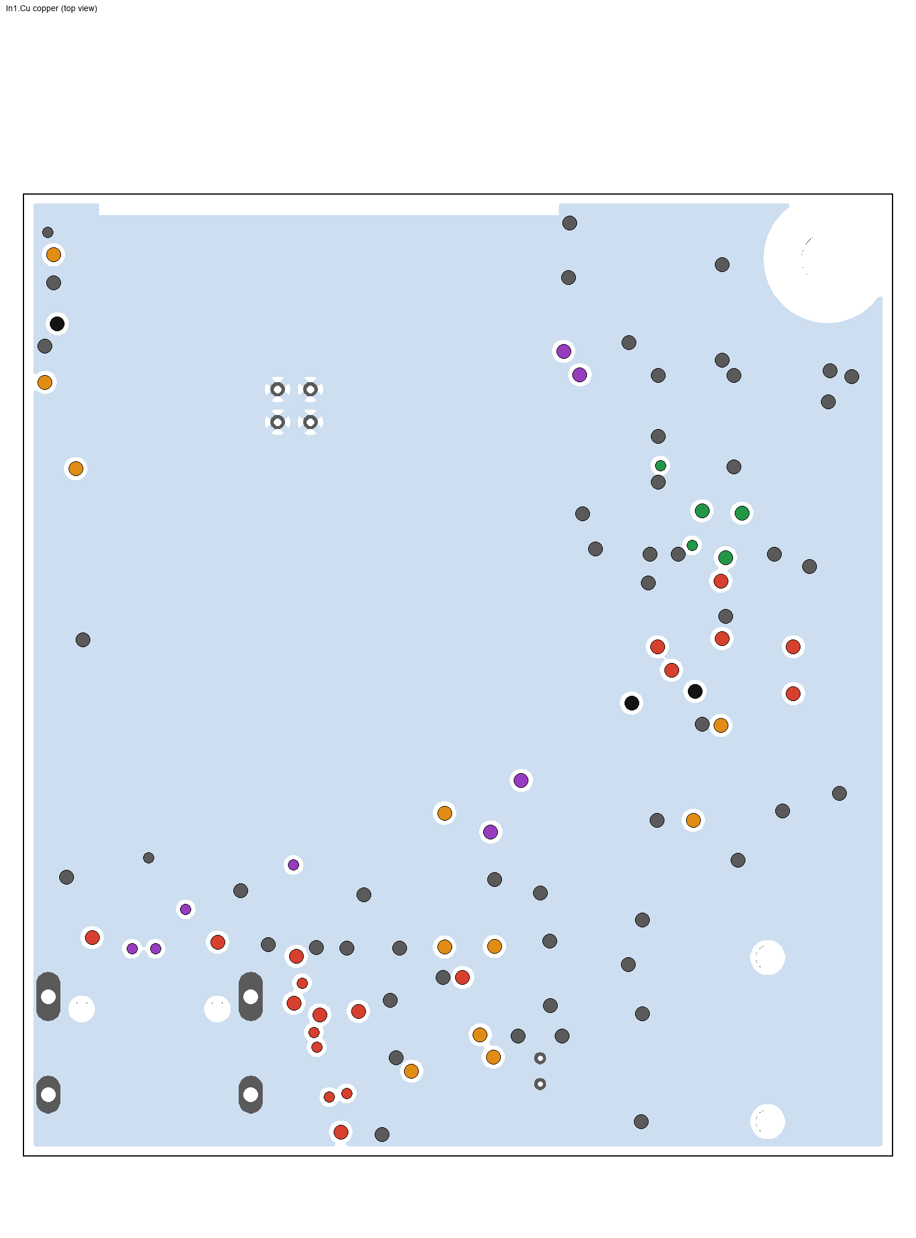
[picture p13: hardware/lovelace-as-008/renders/latest/layer-In1_Cu.png]


layer-In1_Cu.png (previous)



layer-In1_Cu.png (now)

## layer-In2_Cu.png

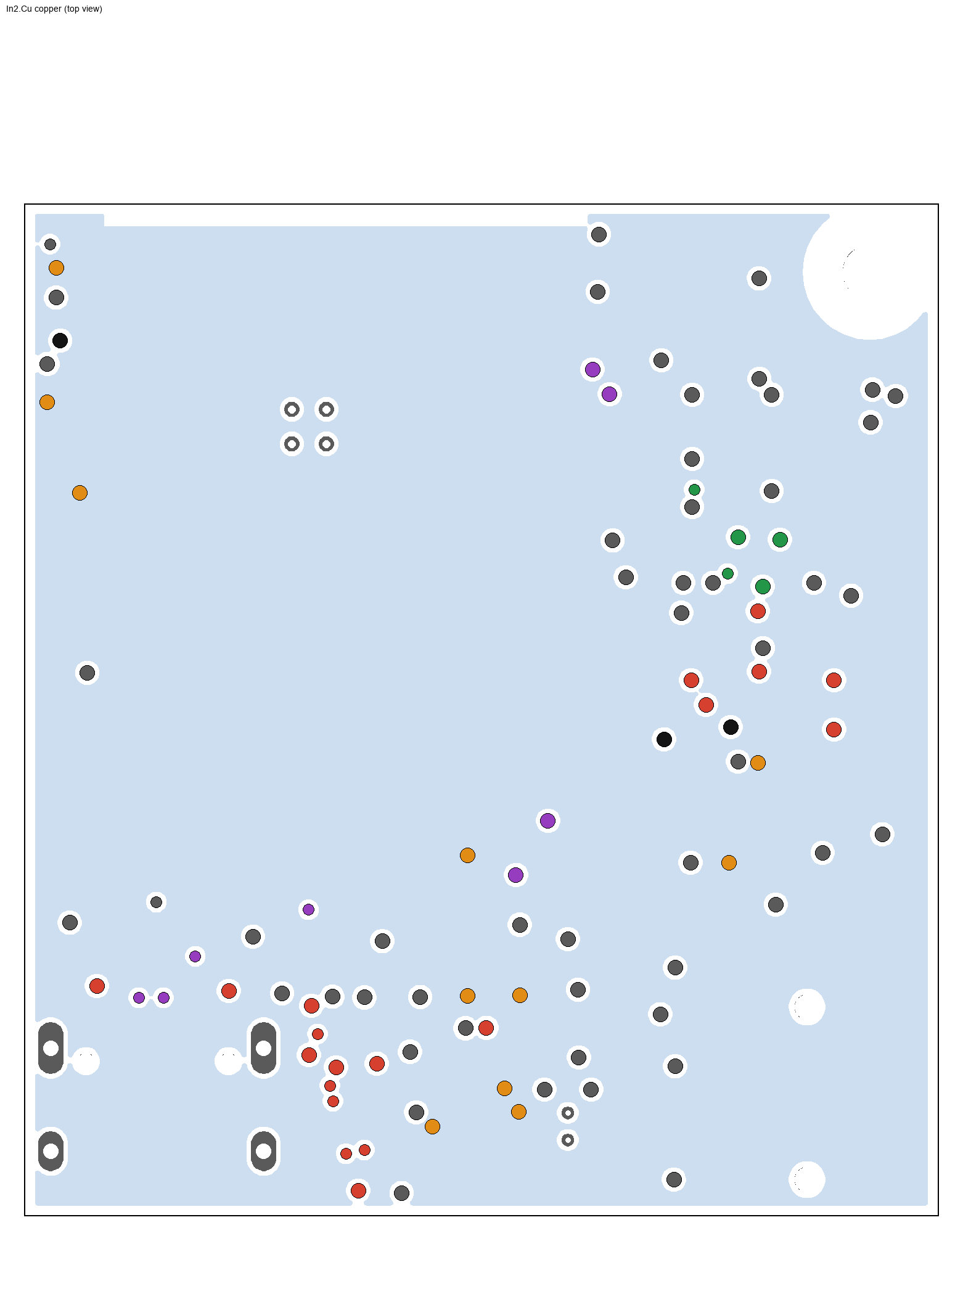
[picture p14: hardware/lovelace-as-008/renders/latest/layer-In2_Cu.png]


layer-In2_Cu.png (previous)



layer-In2_Cu.png (now)

## layer-B_Cu.png

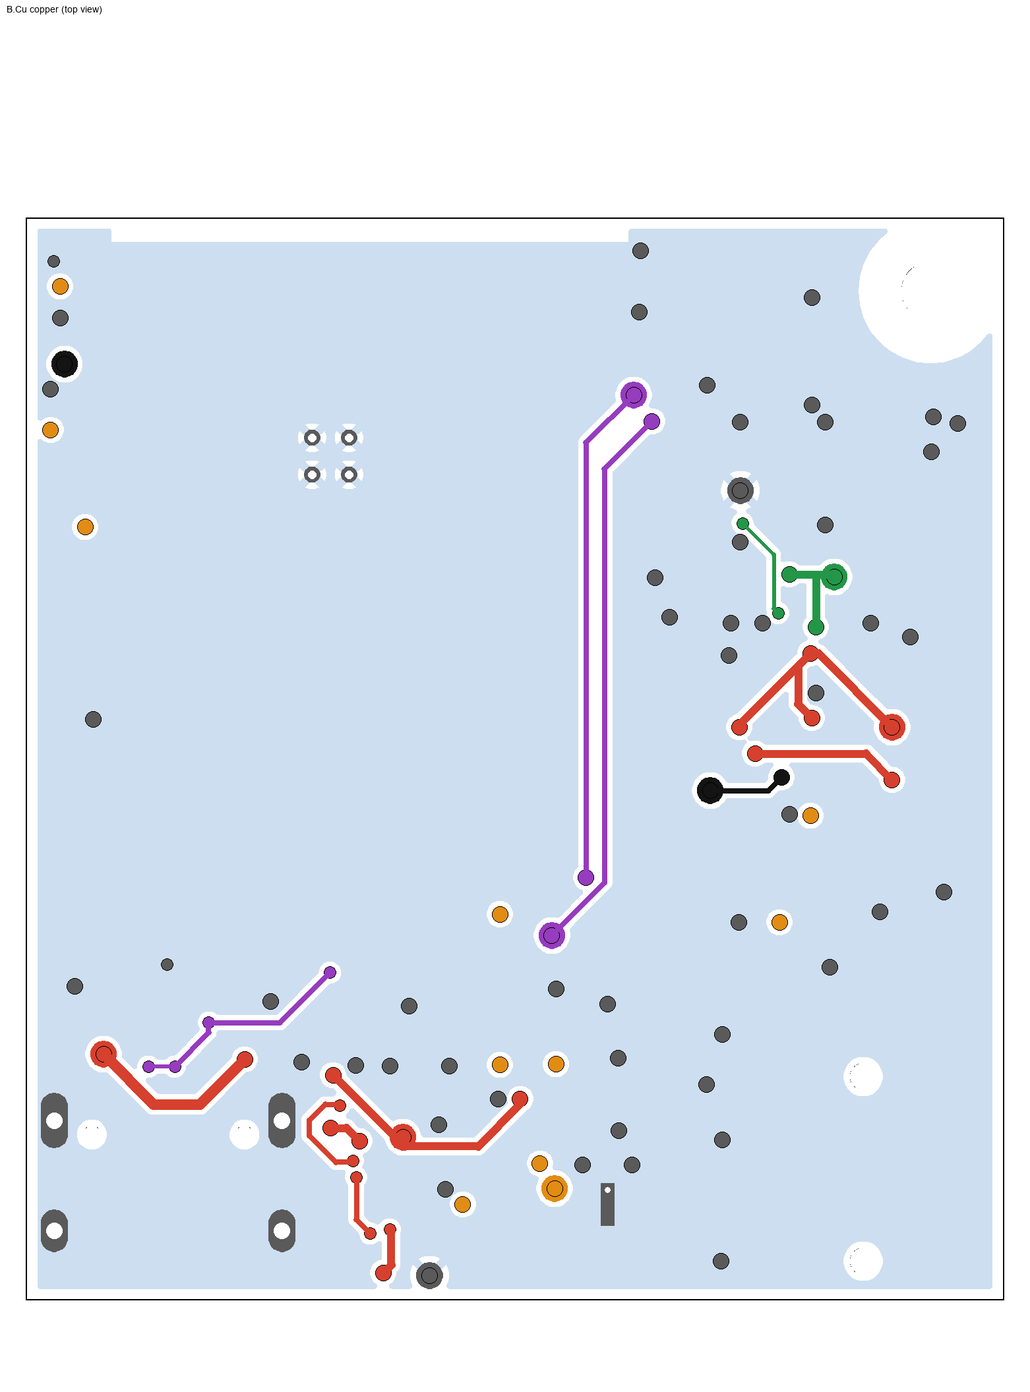
[picture p15: hardware/lovelace-as-008/renders/latest/layer-B_Cu.png]


layer-B_Cu.png (previous)



layer-B_Cu.png (now)

## 버전 기록

버전 | 날짜 | 상태 | 요약 | 파일
AudioStream S3 rev A ESP32-S3-WROOM-1 N16R8 + PCM5102A, 80 × 60 mm, 4층 | 2026-10-14 | 보관 · 주문 안 함 | 첫 일체형 설계. Wi-Fi AirPlay / Spotify만(S3라 Bluetooth Classic 없음). 배선·DRC 완료, 실물 미검증. | README.md · schematic.pdf · audiostream-s3-rev-a-prototype.zip
LOVELACE AS-001 ESP32-S3-WROOM-1 N16R8 + PCM5102A, 55 × 55 mm, 4층 | 2026-10-14 | 보관 · 주문 안 함 | LOVELACE 이름으로 축소(면적 −37%), eFuse 전원 보호, 전원 스위치, LED. S3라 Bluetooth 없음 → WROVER로 전환. | README.md · REVIEW.md · schematic.pdf · lovelace-as-001-prototype.zip
LOVELACE AS-002 rev B ESP32-WROVER-E N8R8 + PCM5102A, 35 × 50 mm, 4층 | 2026-10-14 | 보관 · 원본 없음 | WROVER로 바꿔 Bluetooth A2DP 추가. 고정 홀 2개, BOOT + RESET + 전원 스위치, THT AUX 잭. 같은 폴더에서 rev C로 덮어써서 구리층 이미지만 남음. | README.md
LOVELACE AS-002 rev C ESP32-WROVER-E N8R8 + PCM5102A, 37 × 41 mm, 4층 | 2026-10-15 | 보관 · 주문 안 함 | 면적 −13%, 스위치·RESET 삭제(꽂으면 켜짐), SMD AUX 잭, FreeRouting 배선. AUX 잭 Tip/Ring 배정 오류, XSMT 고정, CPL 회전 미보정 → AS-003에서 수정. | README.md · lovelace-as-002.kicad_pcb
LOVELACE AS-003 rev A ESP32-WROVER-E N8R8 + PCM5102A, 37 × 41 mm, 4층 | 2026-10-15 | 보관 · 주문 안 함 | AUX 잭 배정 수정, XSMT를 GPIO22로(기본 뮤트) + DAC 전원 홀드업(언플러그 팝), JLC 기준 CPL, KiCadRoutingTools 3단계 배선, M2 고정 홀, 바닥 테스트 패드. 검토에서 상단 SMD 패드에 닿는 via 10개를 찾아 AS-004에서 배선만 고침(넷리스트 동일). | README.md · REVIEW.md · REVIEW_NETLIST.md · REVIEW_LAYOUT.md · BRINGUP.md · lovelace-as-003.kicad_pcb · lovelace-as-003-revA-release.zip
LOVELACE AS-004 rev A ESP32-WROVER-E N8R8 + PCM5102A, 37 × 41 mm, 4층 | 2026-10-16 | 보관 · 주문 안 함 | AS-003과 넷리스트·배치 동일. 상단 SMD 패드에 닿는 via 0(라우터 패드 간격, OVLO·ILIM 손 배선, 오디오 배선 잠금), 데이터시트 핀 대조·전원 경로 시뮬레이션·배선 검토 추가. 독립 재검수에서 AUX 잭(J2) 랜드가 Shou Han PJ-320D 도면과 달라 AS-005에서 랜드만 고침. | README.md · REVIEW.md · REVIEW_NETLIST.md · REVIEW_LAYOUT.md · REVIEW_INDEPENDENT_2026-10-16.md · BRINGUP.md · lovelace-as-004.kicad_pcb · lovelace-as-004-revA-release.zip
LOVELACE AS-005 rev A ESP32-WROVER-E N8R8 + PCM5102A, 37 × 41 mm, 4층 | 2026-10-16 | 보관 · 주문 안 함 | AS-004와 넷리스트·배치·배선 동일. AUX 잭(J2) 랜드를 Shou Han PJ-320D 도면대로: 위치 결정 NPTH Ø1.5 → Ø1.0mm, 패드 폭 1.2 → 1.5mm(LOVELACE 라이브러리 풋프린트). 축에서 패드까지 거리는 KiCad 그대로(2.0–4.5mm)여서 도면(3.05–4.65mm, 몸체 바깥)과 달라 AS-006에서 고침. | README.md · REVIEW.md · REVIEW_NETLIST.md · REVIEW_LAYOUT.md · BRINGUP.md · lovelace-as-005.kicad_pcb · lovelace-as-005-revA-release.zip
LOVELACE AS-006 rev A ESP32-WROVER-E N8R8 + PCM5102A, 37 × 41 mm, 4층 | 2026-10-16 | 보관 · 주문 안 함 | AS-005와 넷리스트 동일. AUX 잭(J2) 패드를 Shou Han 도면 위치로: 잭 축에서 3.85mm(도면 랜드 3.05–4.65mm를 양 끝 0.2mm씩 늘린 2.85–4.85mm), J2를 0.3mm 왼쪽으로 옮겨 다시 배선, J2 CPL은 위치 결정 핀 기준. LCSC 회신으로 J2 단자 배정이 틀린 것(D·B의 R/GND가 바뀜)이 확인돼 AS-007에서 고침. | README.md · REVIEW.md · REVIEW_NETLIST.md · REVIEW_LAYOUT.md · BRINGUP.md · lovelace-as-006.kicad_pcb · lovelace-as-006-revA-release.zip
LOVELACE AS-007 rev A ESP32-WROVER-E N8R8 + PCM5102A, 37 × 41 mm, 4층 | 2026-10-16 | 보관 · 주문 안 함 | AS-006과 J2 랜드·부품 위치 동일, AUX 잭 단자 배정만 LCSC 엔지니어 회신대로: A = Tip(LINE_L), D = Ring 1(LINE_R), B·C = GND. ESD 다이오드 D2를 새 LINE_R 패드 옆으로 옮기고 다시 배선. kicad-happy 검토에서 USB D− via 4개가 JLC 다층 최소 지름(0.45mm) 아래(0.4mm)였고, eFuse ITIMER에 나중에 커패시터를 달 자리가 없어 AS-008에서 고침. | README.md · REVIEW.md · REVIEW_NETLIST.md · REVIEW_LAYOUT.md · REVIEW_KICAD_HAPPY.md · BRINGUP.md · lovelace-as-007.kicad_pcb · lovelace-as-007-revA-release.zip
LOVELACE AS-008 rev A ESP32-WROVER-E N8R8 + PCM5102A, 37 × 41 mm, 4층 | 2026-10-19 | 현재 · 주문 전 | AS-007과 회로·BOM 동일. USB D− via 4개를 0.4/0.2 → 0.45/0.2mm(JLC 다층 표준 최소), eFuse ITIMER(U6 10번)에 미실장 0402 랜드 C26 추가(Wi-Fi 피크가 전류 제한에 걸리면 1–10nF를 달아 짧은 피크를 통과시킴). C26 자리를 내려고 R16을 U6 EN/UVLO 쪽으로 옮김. | README.md · REVIEW.md · REVIEW_NETLIST.md · REVIEW_LAYOUT.md · REVIEW_KICAD_HAPPY.md · BRINGUP.md · lovelace-as-008-revA-release.zip

### LOVELACE AS-008 rev A — ESP32-WROVER-E N8R8 + PCM5102A, 37 × 41 mm, 4층



pcba-iso.png



pcba-top.png



routing.png



assembly-top.png

### LOVELACE AS-007 rev A — ESP32-WROVER-E N8R8 + PCM5102A, 37 × 41 mm, 4층

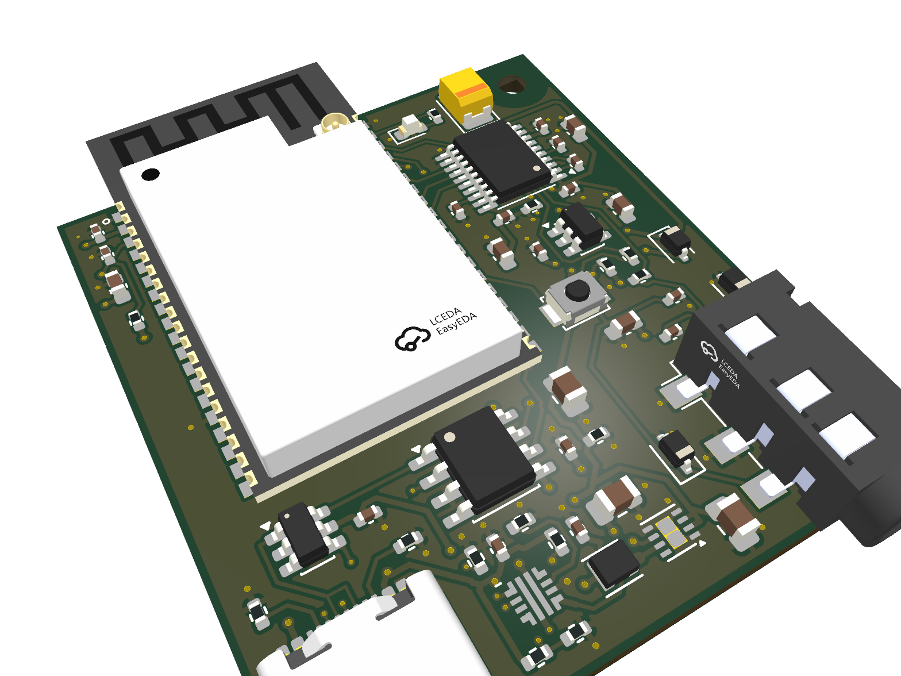
[picture p16: hardware/archive/09-lovelace-as-007-revA/renders/pcba-iso.png]


pcba-iso.png

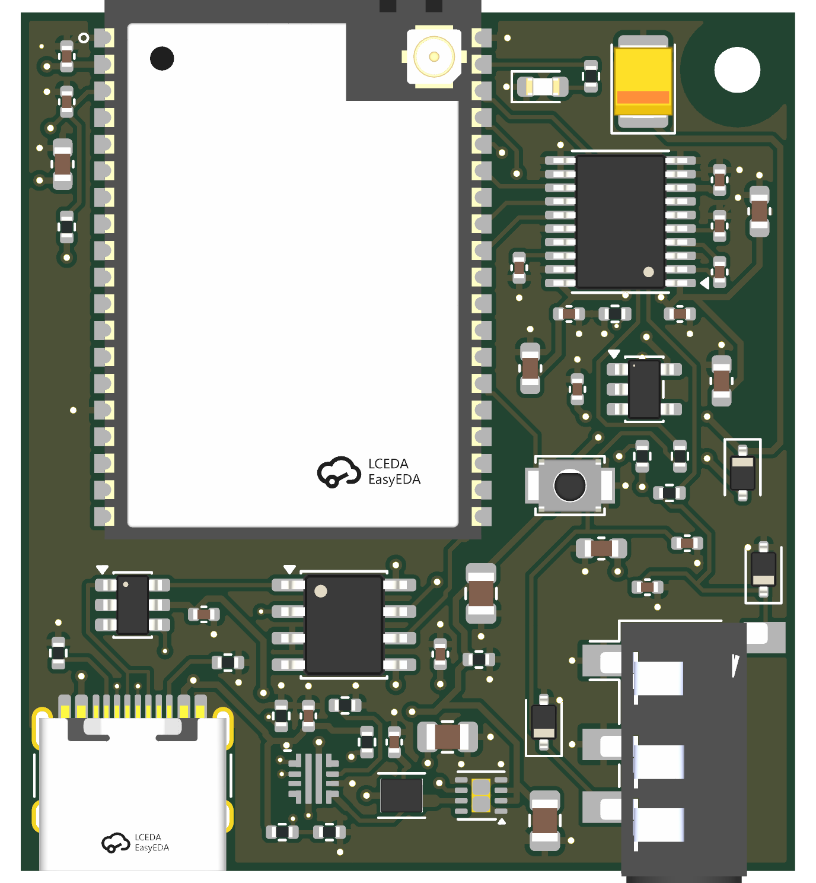
[picture p17: hardware/archive/09-lovelace-as-007-revA/renders/pcba-top.png]


pcba-top.png

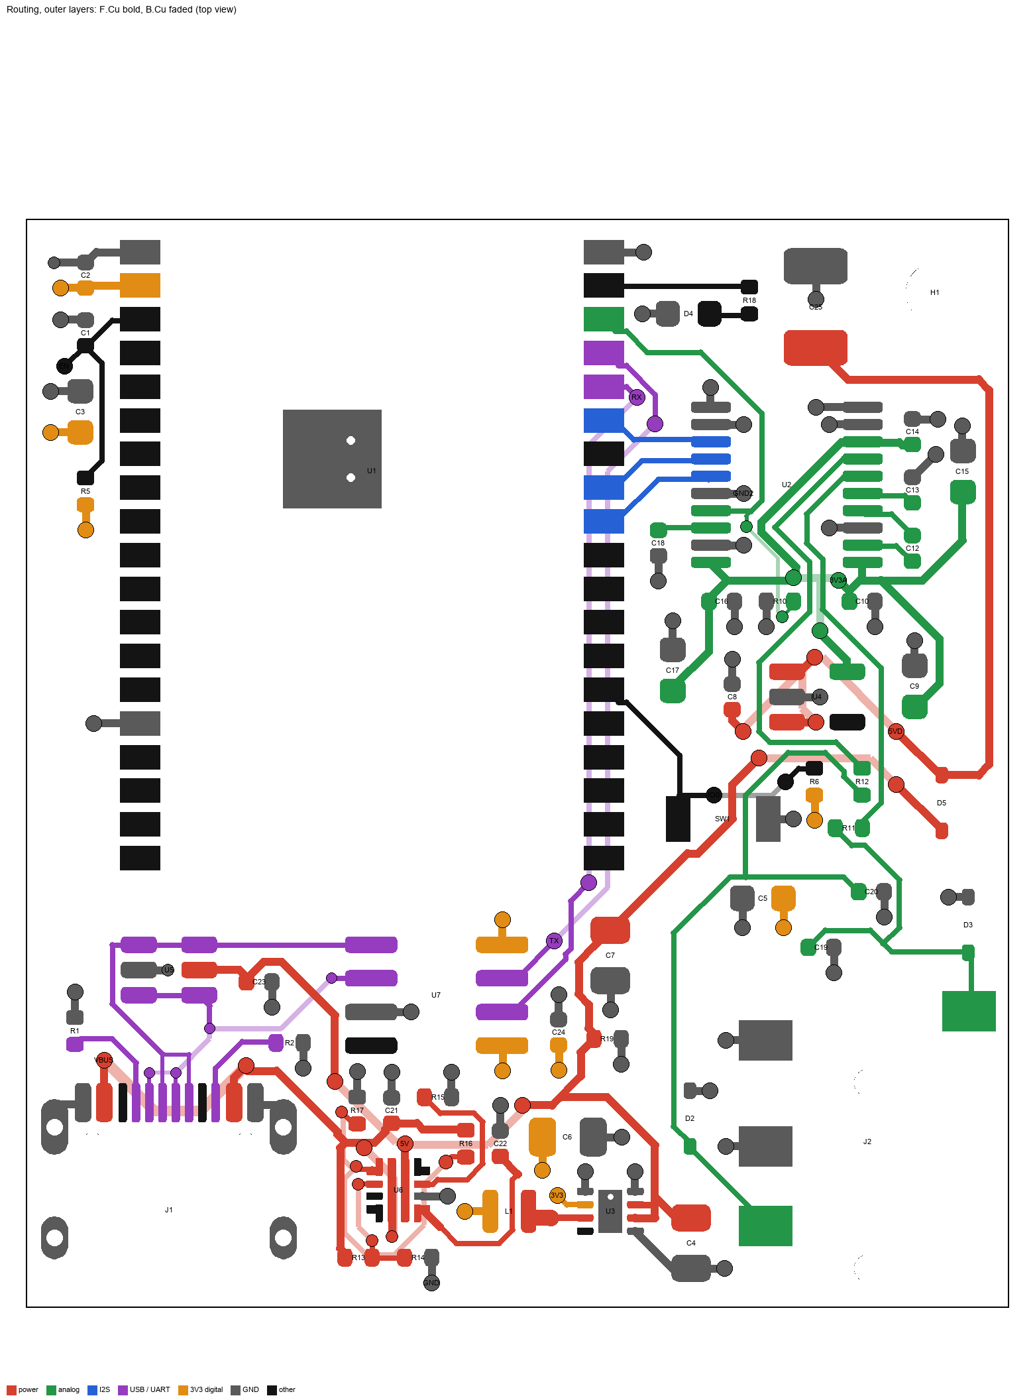
[picture p18: hardware/archive/09-lovelace-as-007-revA/renders/routing.png]


routing.png

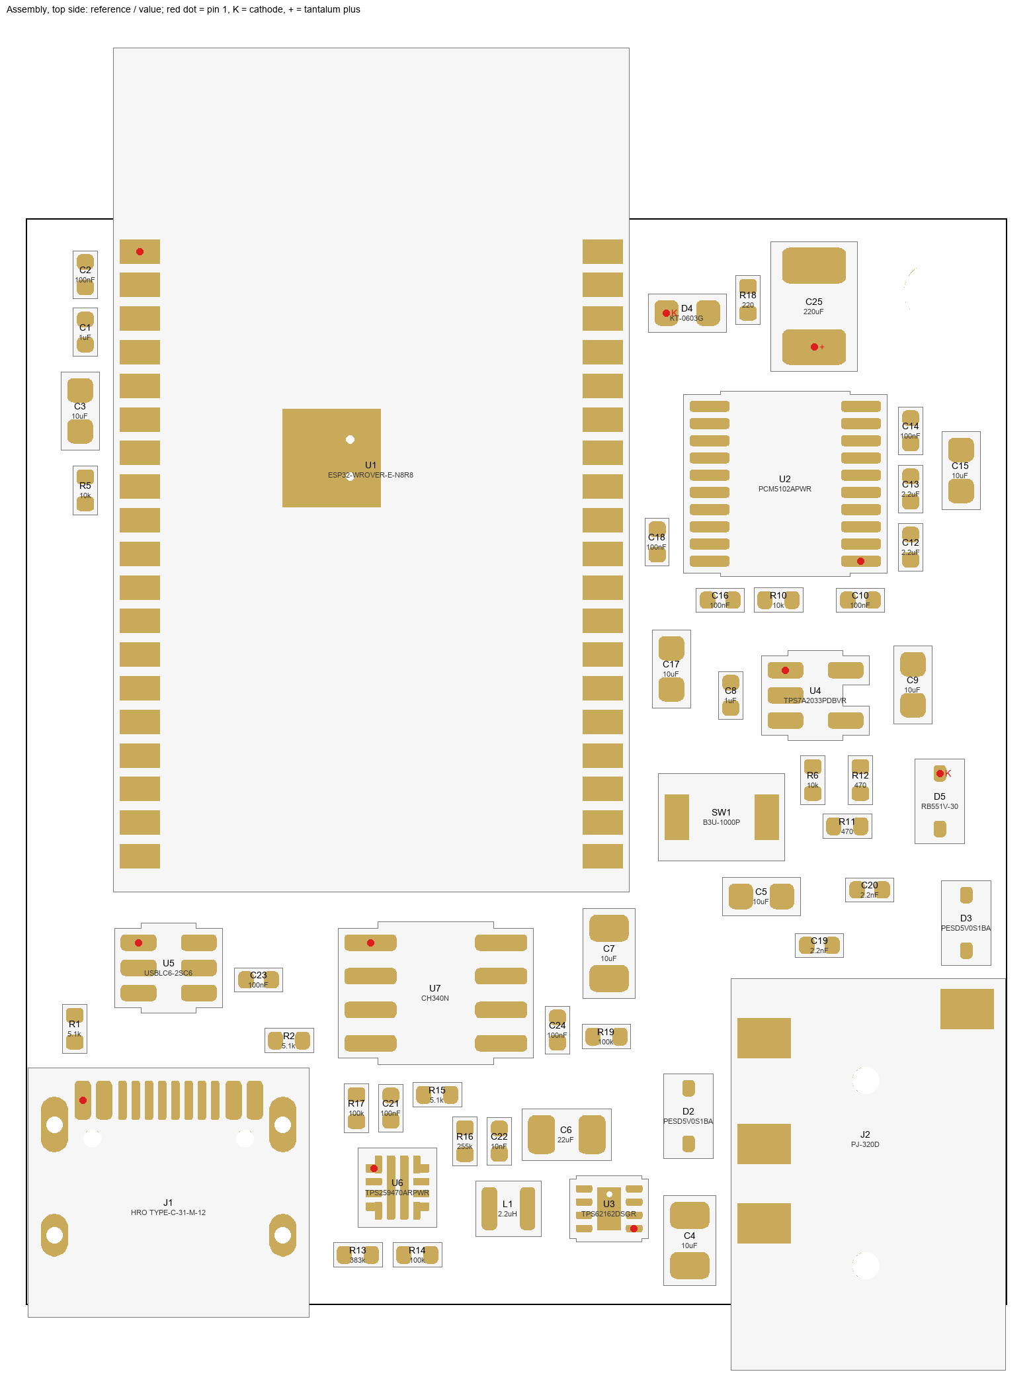
[picture p19: hardware/archive/09-lovelace-as-007-revA/renders/assembly-top.png]


assembly-top.png

### LOVELACE AS-006 rev A — ESP32-WROVER-E N8R8 + PCM5102A, 37 × 41 mm, 4층

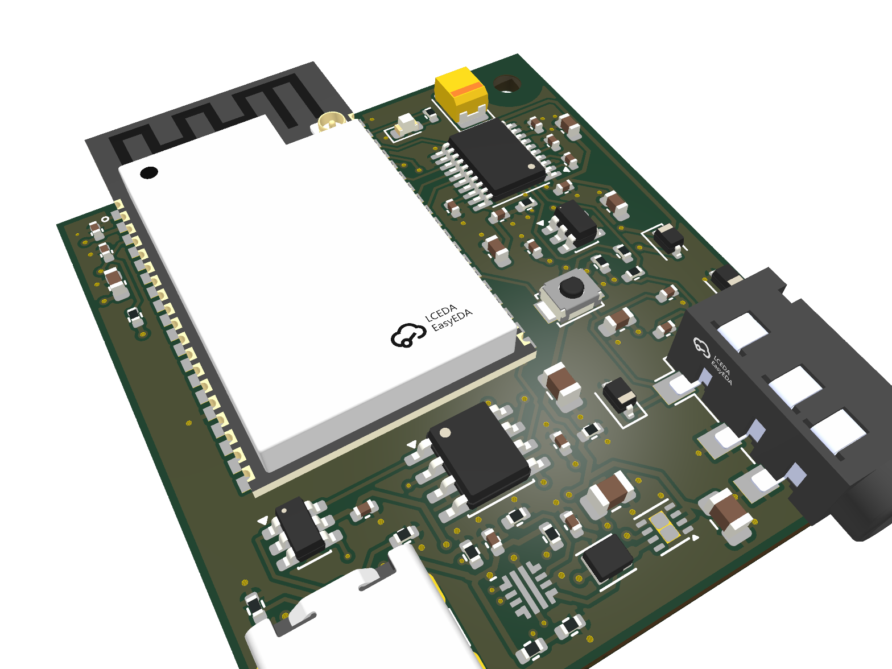
[picture p20: hardware/archive/08-lovelace-as-006-revA/renders/pcba-iso.png]


pcba-iso.png



pcba-top.png

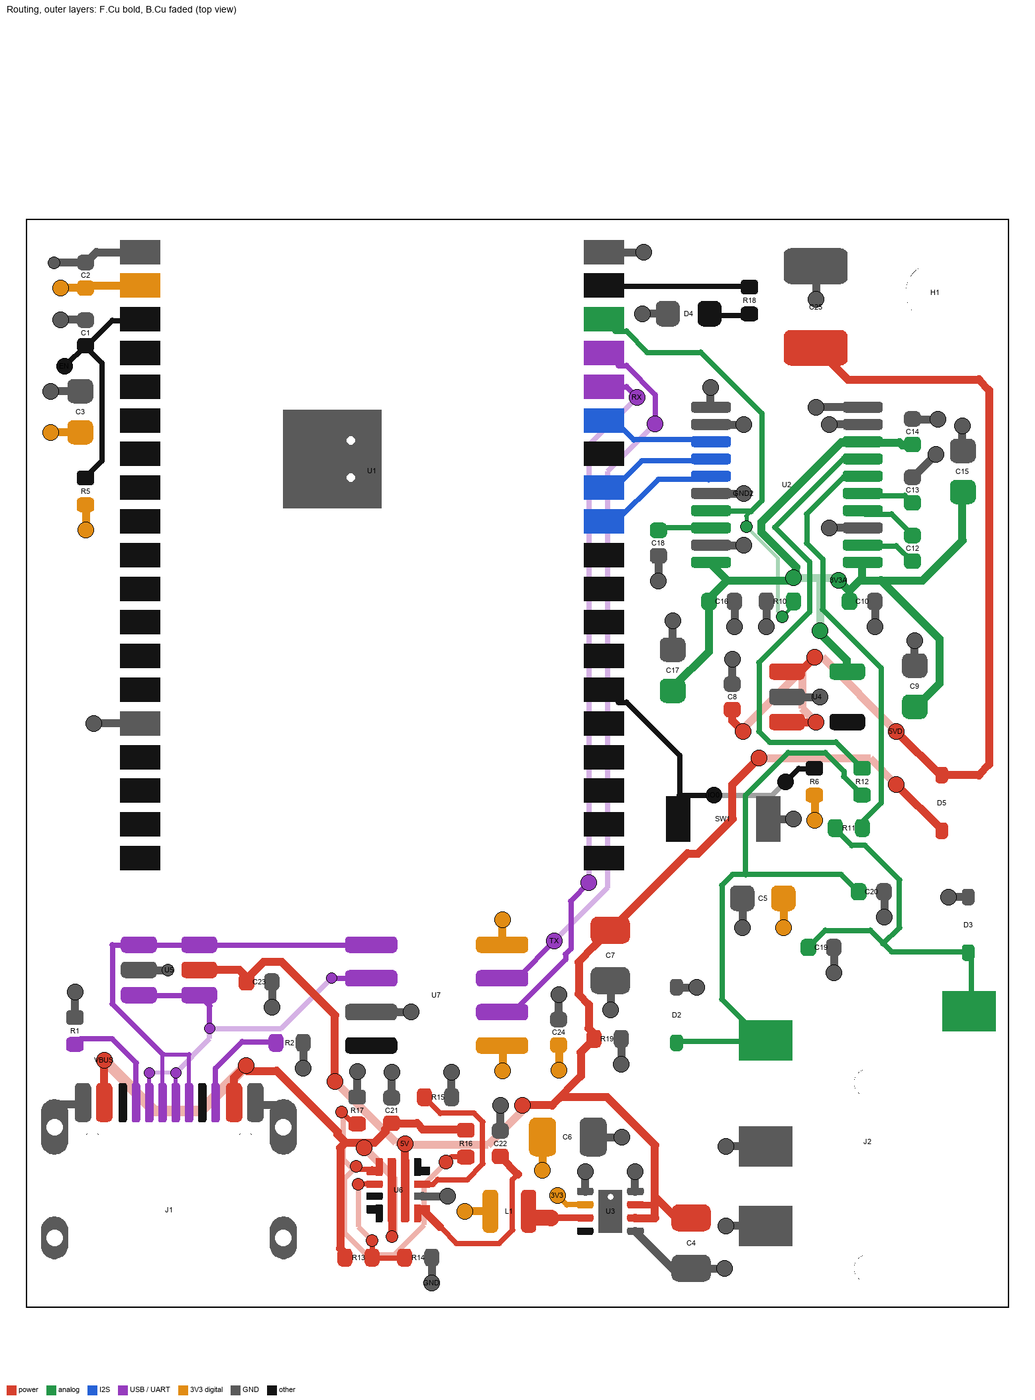
[picture p21: hardware/archive/08-lovelace-as-006-revA/renders/routing.png]


routing.png



assembly-top.png

### LOVELACE AS-005 rev A — ESP32-WROVER-E N8R8 + PCM5102A, 37 × 41 mm, 4층

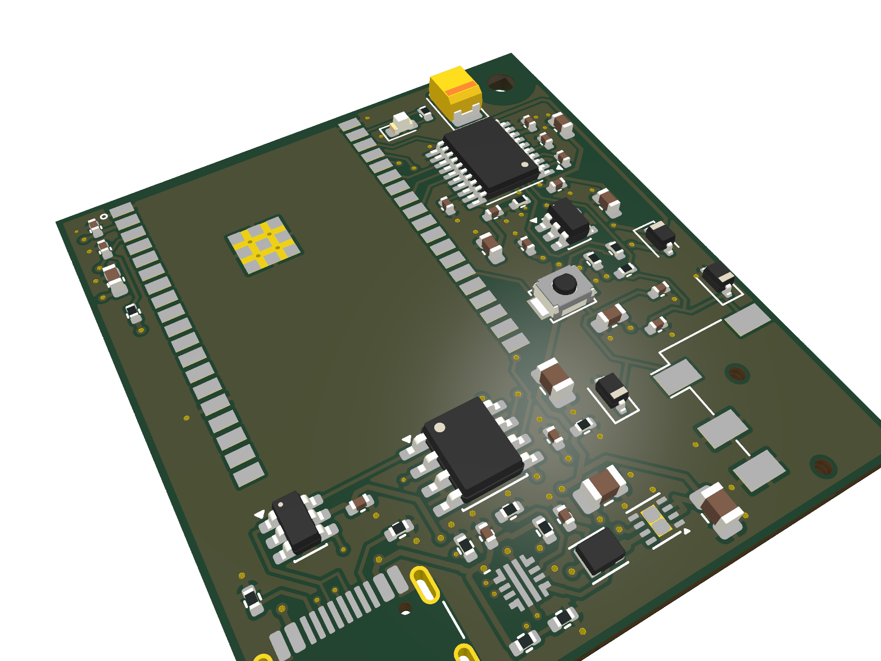
[picture p22: hardware/archive/07-lovelace-as-005-revA/renders/pcba-iso.png]


pcba-iso.png

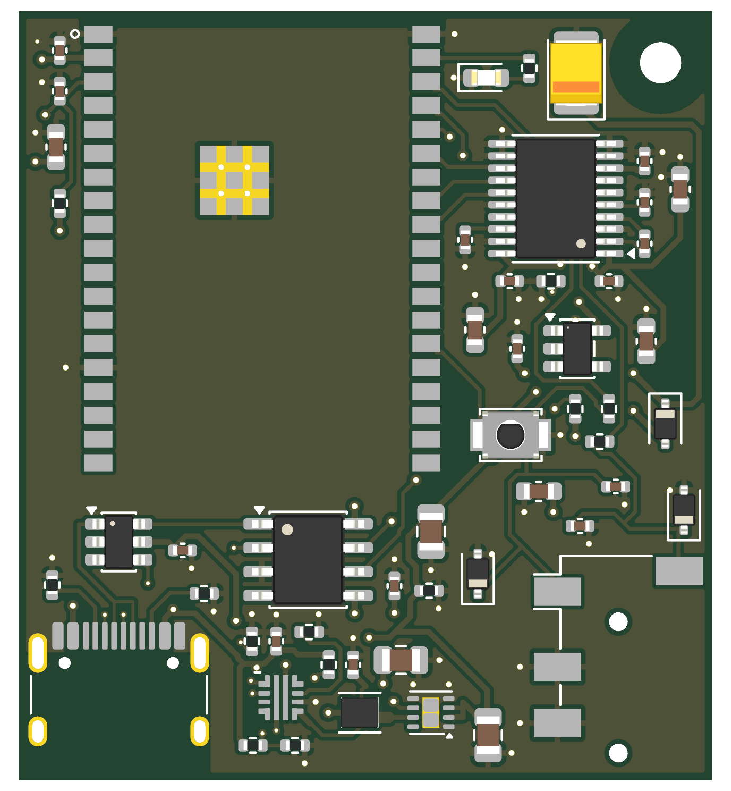
[picture p23: hardware/archive/07-lovelace-as-005-revA/renders/pcba-top.png]


pcba-top.png



routing.png

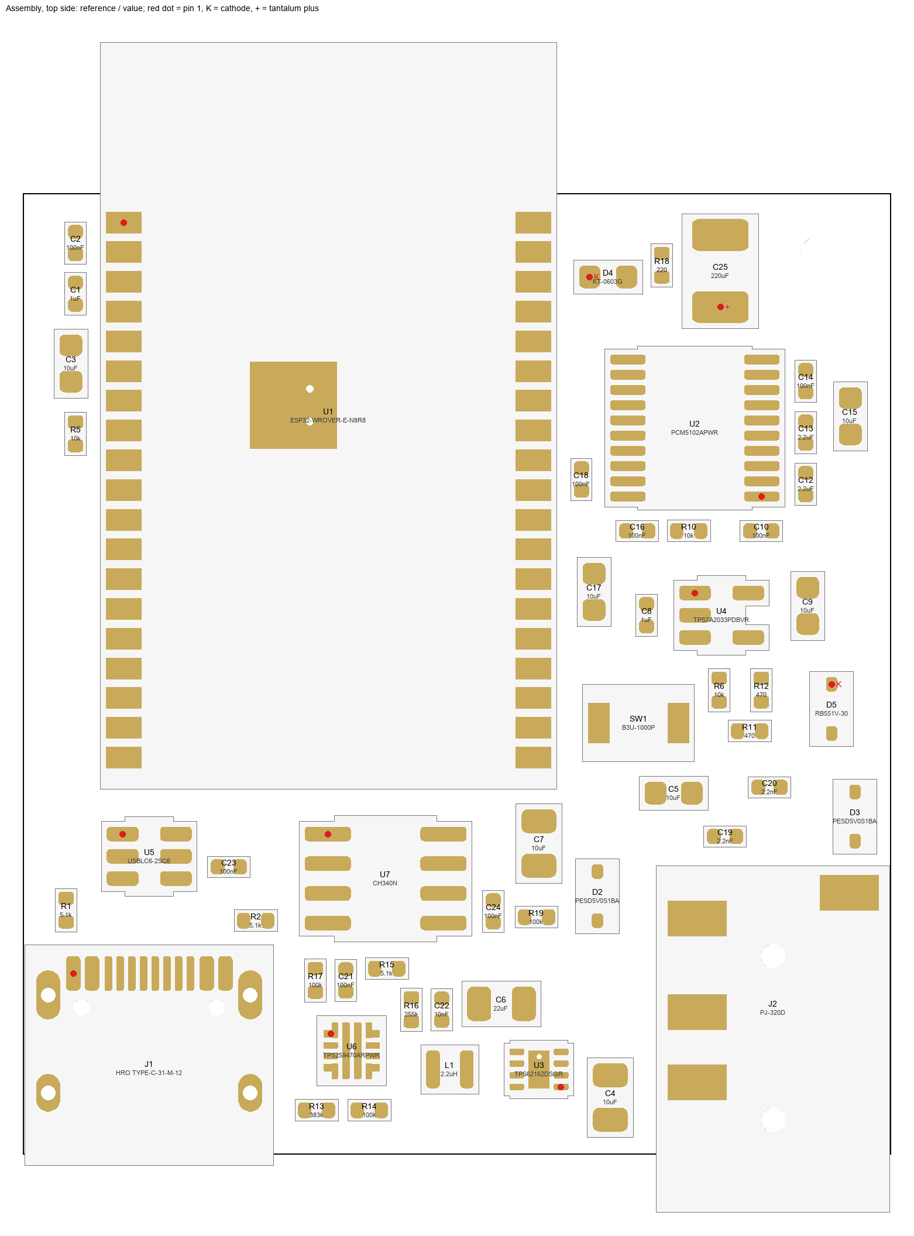
[picture p24: hardware/archive/07-lovelace-as-005-revA/renders/assembly-top.png]


assembly-top.png

### LOVELACE AS-004 rev A — ESP32-WROVER-E N8R8 + PCM5102A, 37 × 41 mm, 4층



pcba-iso.png

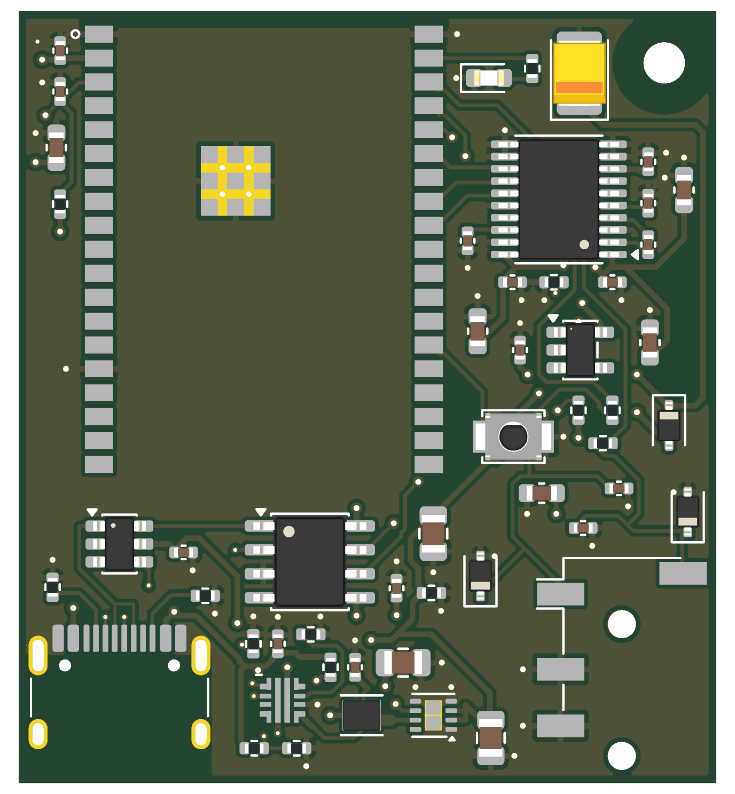
[picture p25: hardware/archive/06-lovelace-as-004-revA/renders/pcba-top.png]


pcba-top.png

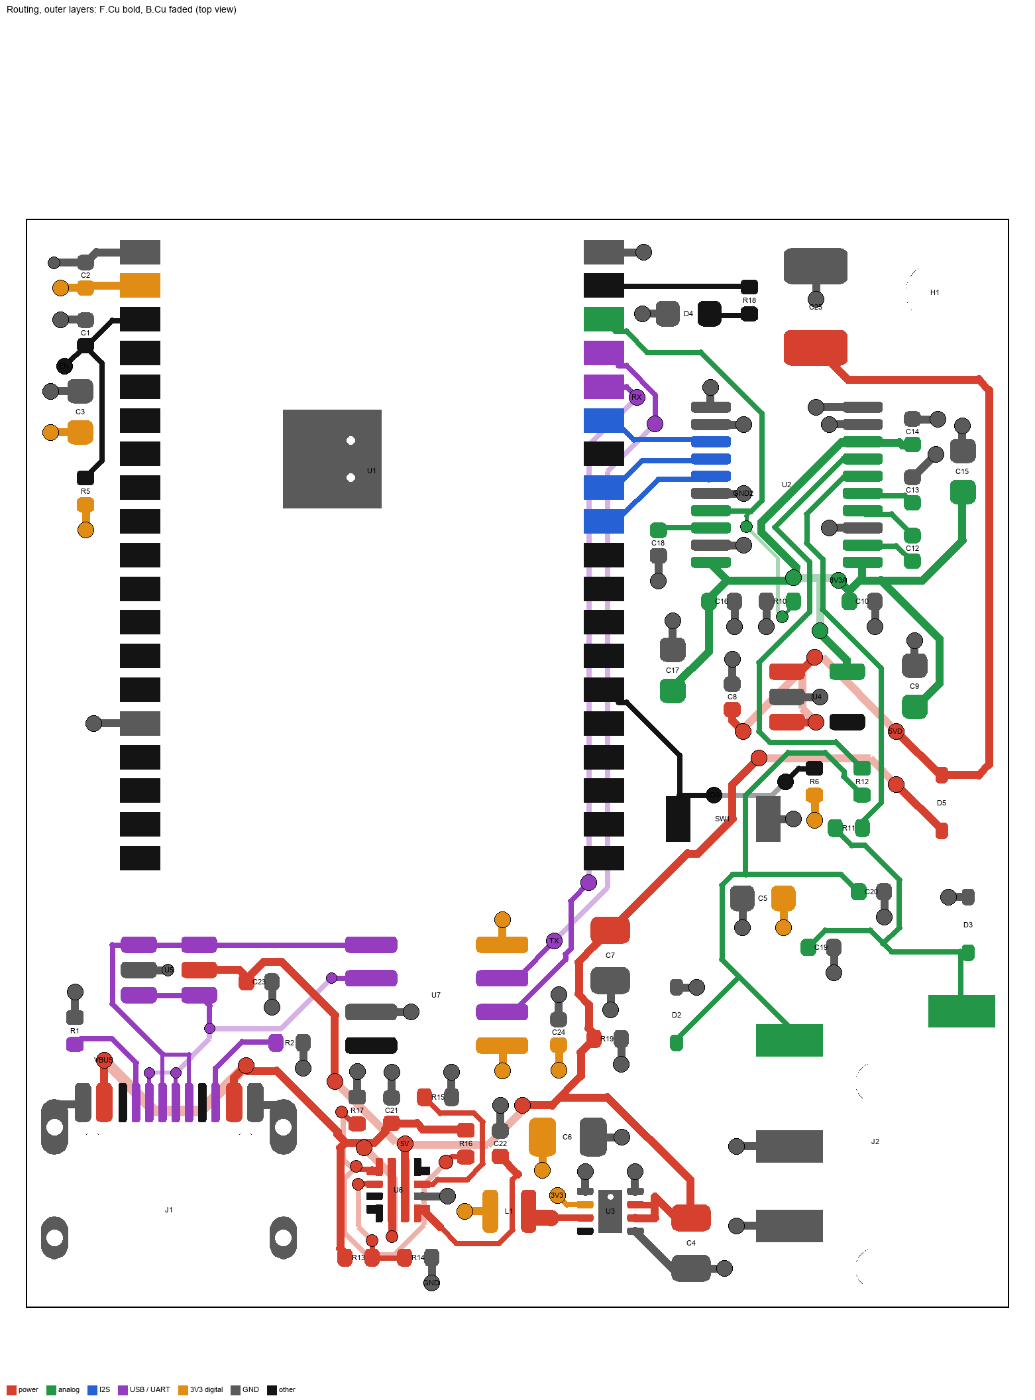
[picture p26: hardware/archive/06-lovelace-as-004-revA/renders/routing.png]


routing.png



assembly-top.png

### LOVELACE AS-003 rev A — ESP32-WROVER-E N8R8 + PCM5102A, 37 × 41 mm, 4층



pcba-iso.png



pcba-top.png



routing.png



assembly-top.png

### LOVELACE AS-002 rev C — ESP32-WROVER-E N8R8 + PCM5102A, 37 × 41 mm, 4층

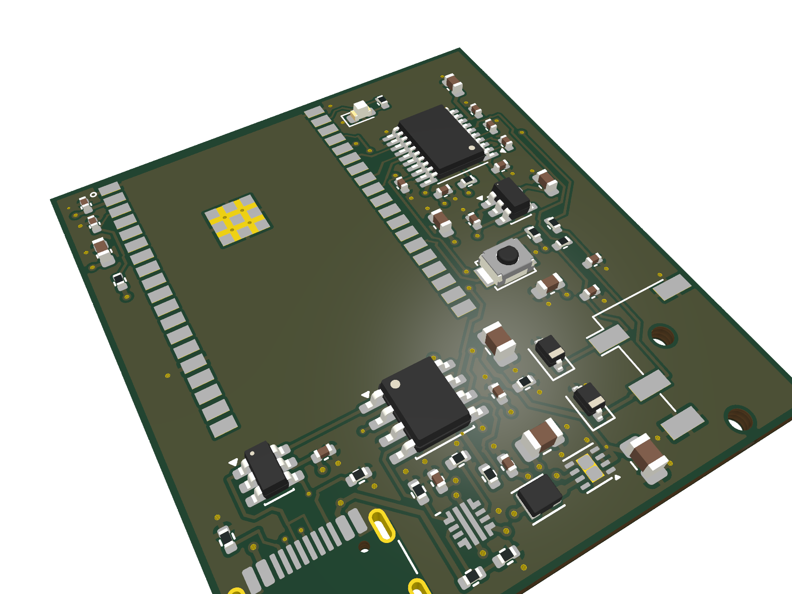
[picture p27: hardware/archive/04-lovelace-as-002-revC/renders/pcba-iso.png]


pcba-iso.png

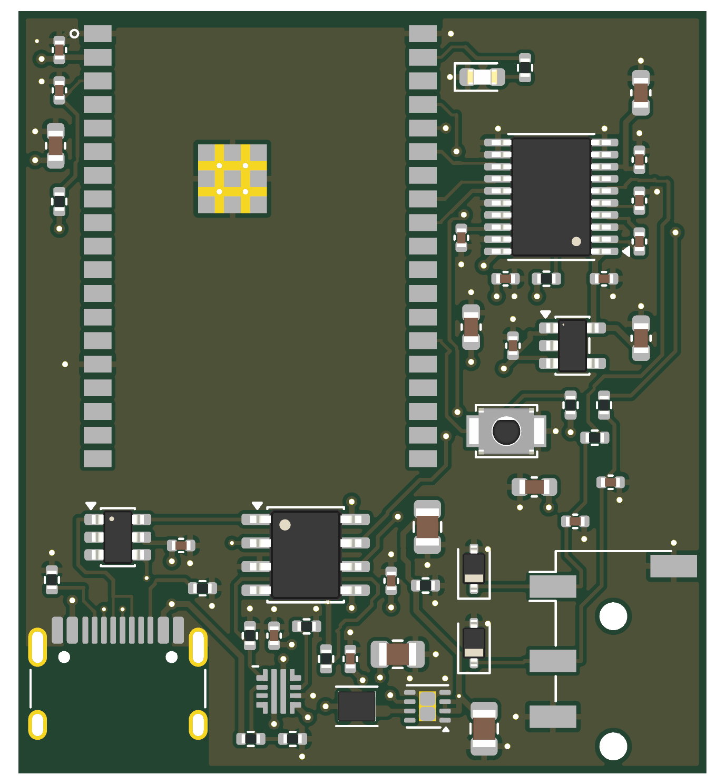
[picture p28: hardware/archive/04-lovelace-as-002-revC/renders/pcba-top.png]


pcba-top.png

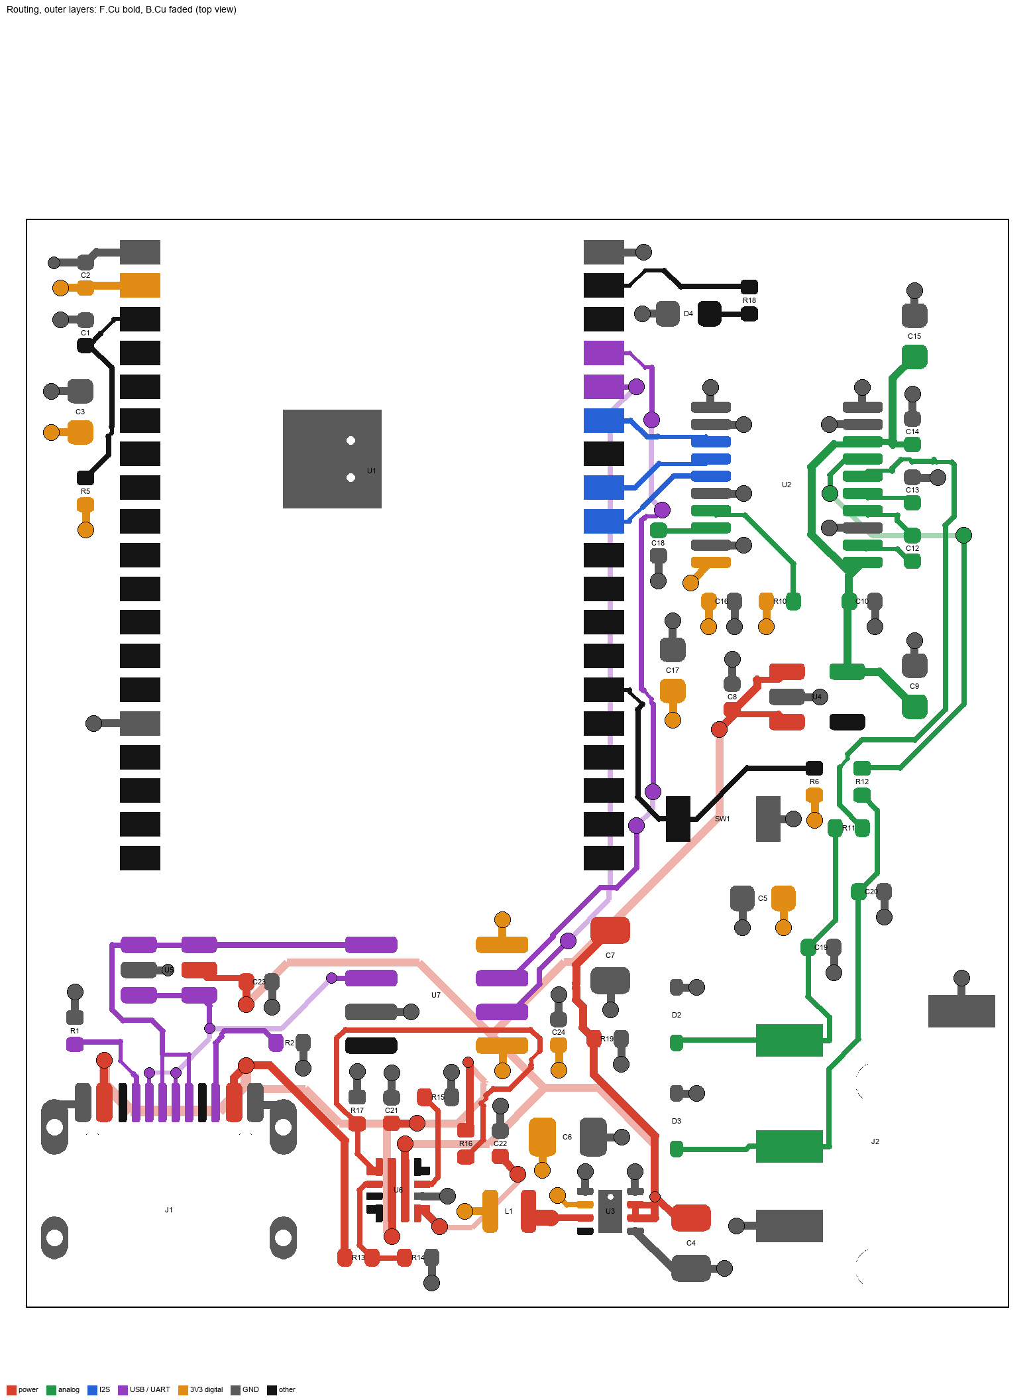
[picture p29: hardware/archive/04-lovelace-as-002-revC/renders/routing.png]


routing.png



assembly-top.png

### LOVELACE AS-002 rev B — ESP32-WROVER-E N8R8 + PCM5102A, 35 × 50 mm, 4층

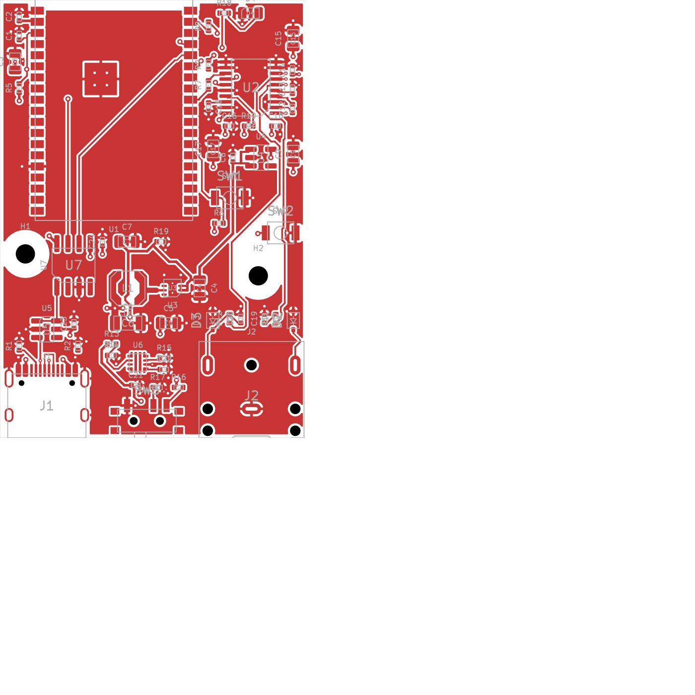
[picture p30: hardware/archive/03-lovelace-as-002-revB/copper-F_Cu.png]


copper-F_Cu.png



copper-B_Cu.png

### LOVELACE AS-001 — ESP32-S3-WROOM-1 N16R8 + PCM5102A, 55 × 55 mm, 4층



pcba-iso.png

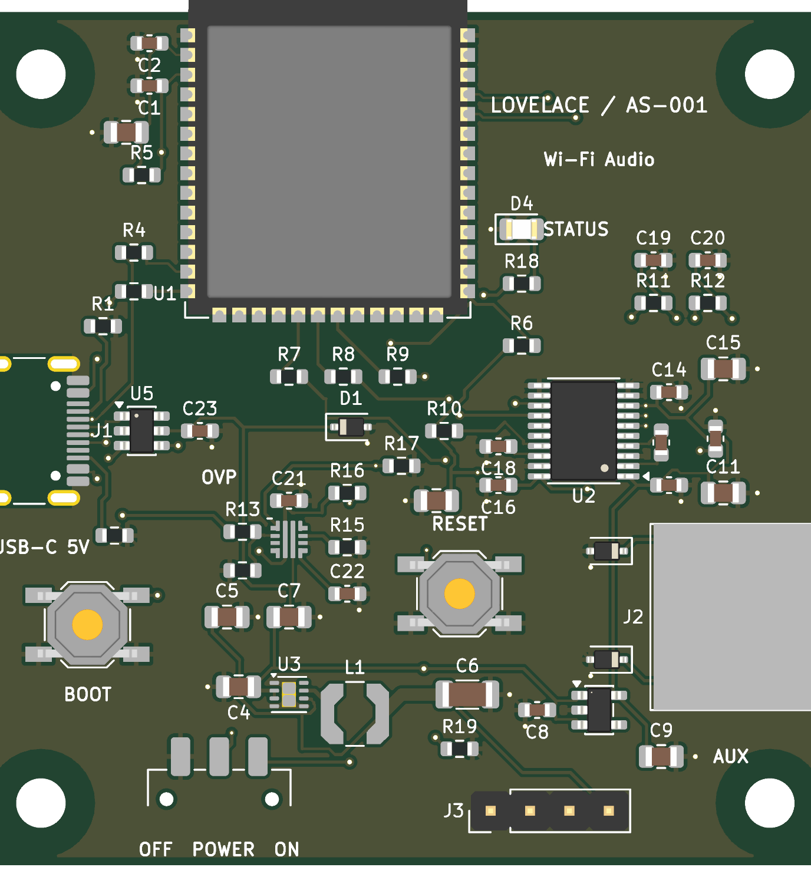
[picture p31: hardware/archive/02-lovelace-as-001/renders/pcba-top.png]


pcba-top.png



routing.png



assembly-top.png

### AudioStream S3 rev A — ESP32-S3-WROOM-1 N16R8 + PCM5102A, 80 × 60 mm, 4층



pcba-iso.png

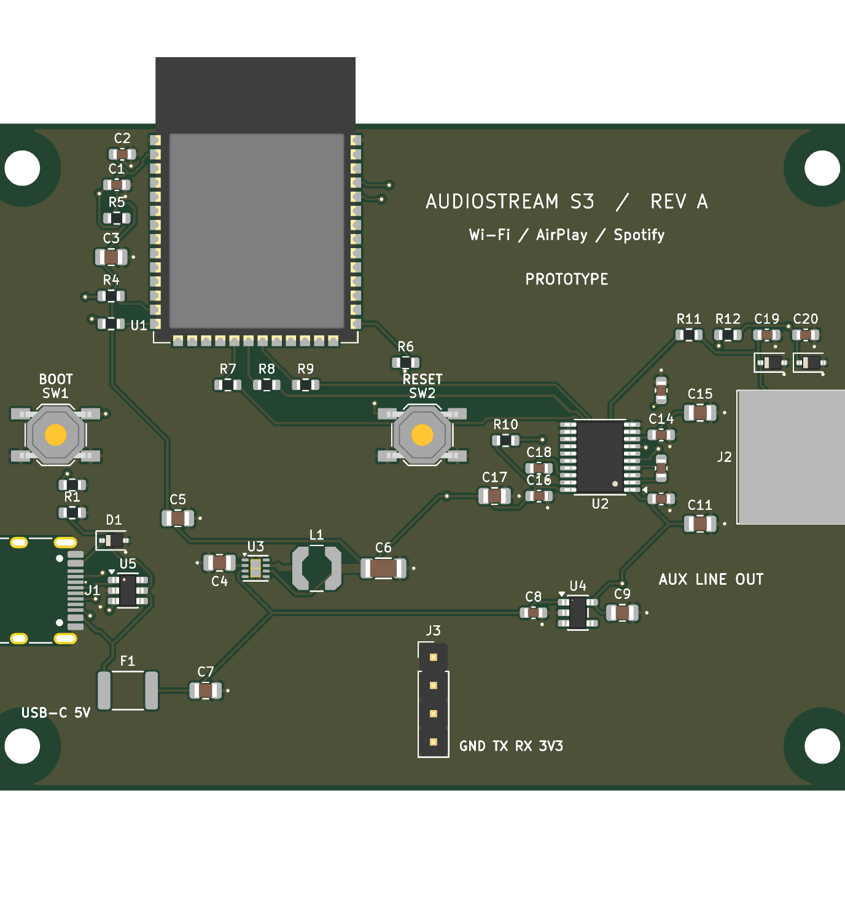
[picture p32: hardware/archive/01-audiostream-s3-revA/renders/pcba-top.png]


pcba-top.png



routing.png



assembly-top.png
