chanulee/audiostream-esp32/hardware/lovelace-as-003/renders/latest/index.html

# LOVELACE / AS-003 rev A

버전 기록

## pcba-iso.png



pcba-iso.png (previous)



pcba-iso.png (now)

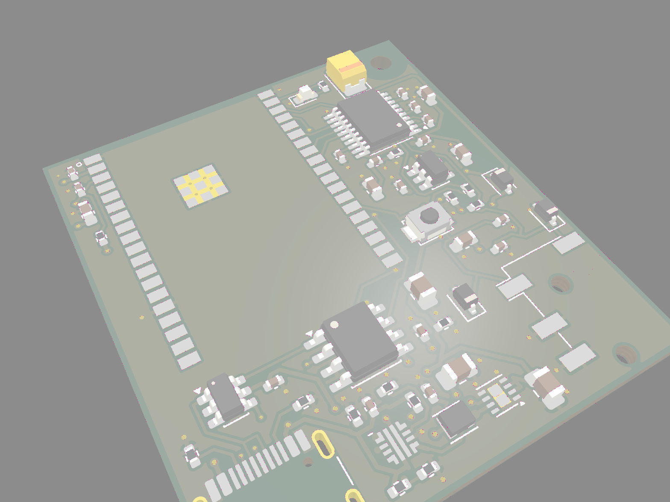
[picture p37: hardware/lovelace-as-003/renders/latest/diff-pcba-iso.png]


changed pixels in magenta

## pcba-top.png



pcba-top.png (previous)



pcba-top.png (now)

## pcba-bottom.png



pcba-bottom.png (previous)

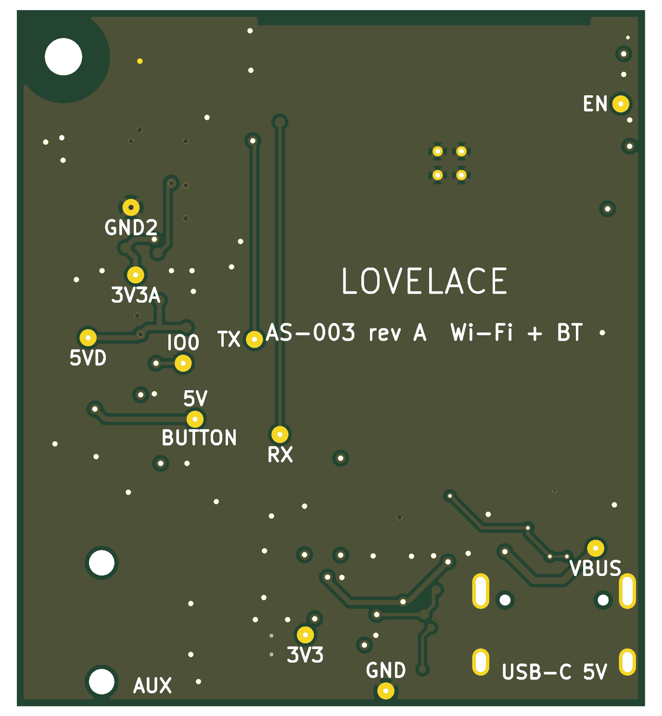
[picture p38: hardware/lovelace-as-003/renders/latest/pcba-bottom.png]


pcba-bottom.png (now)



changed pixels in magenta

## bare-top.png



bare-top.png (previous)

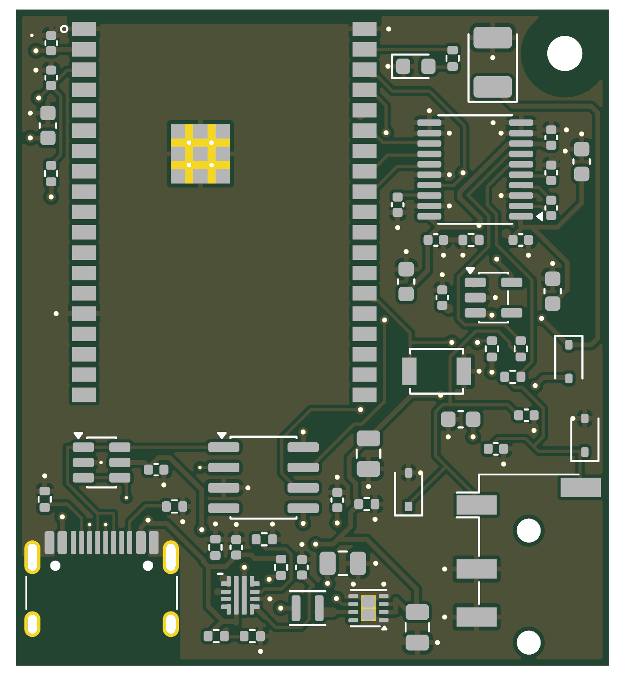
[picture p39: hardware/lovelace-as-003/renders/latest/bare-top.png]


bare-top.png (now)

## bare-bottom.png



bare-bottom.png (previous)

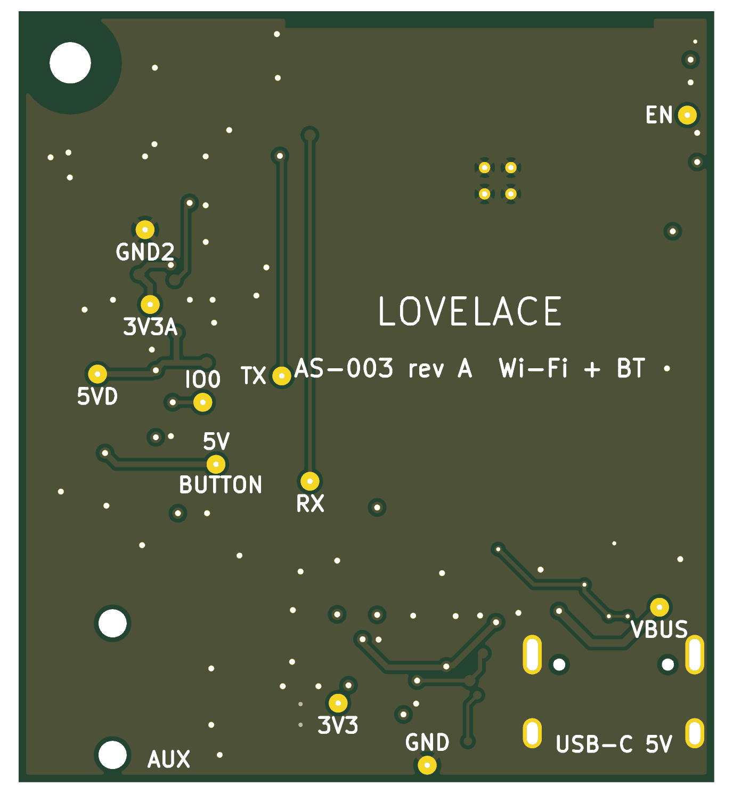
[picture p40: hardware/lovelace-as-003/renders/latest/bare-bottom.png]


bare-bottom.png (now)

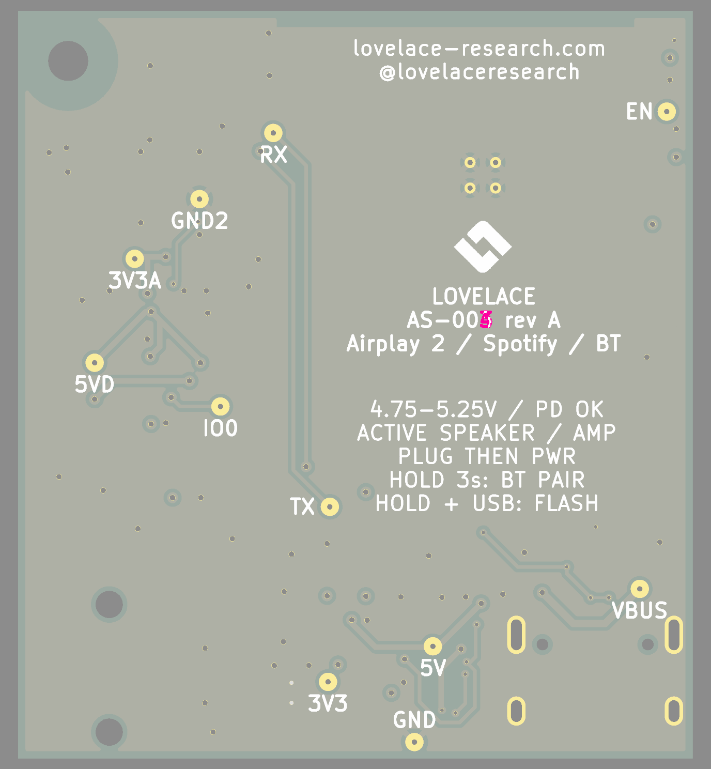
[picture p41: hardware/lovelace-as-004/renders/latest/diff-bare-bottom.png]


changed pixels in magenta

## assembly-top.png



assembly-top.png (previous)



assembly-top.png (now)



changed pixels in magenta

## routing.png



routing.png (previous)



routing.png (now)

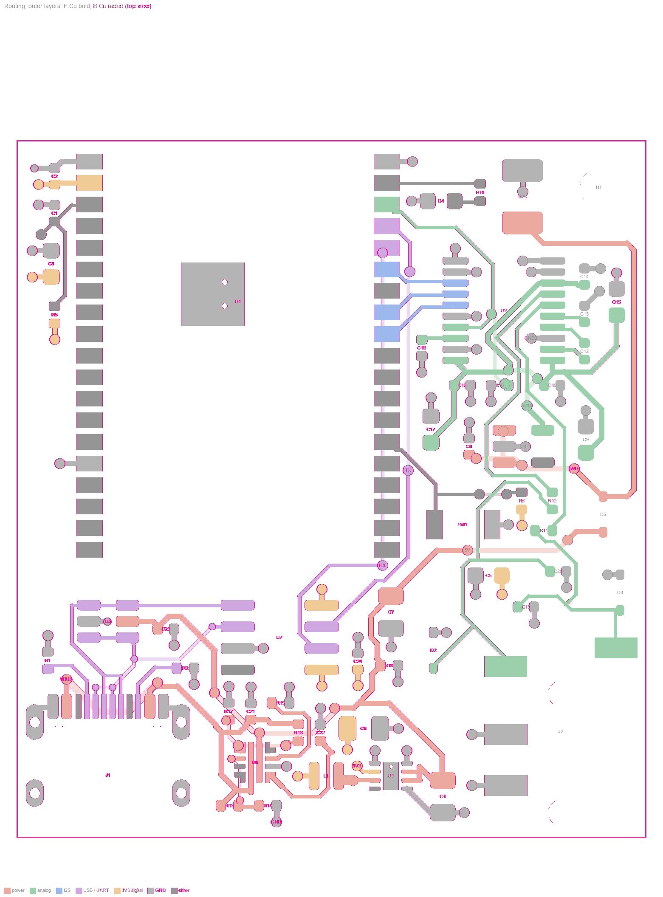
[picture p42: hardware/lovelace-as-003/renders/latest/diff-routing.png]


changed pixels in magenta

## layer-F_Cu.png



layer-F_Cu.png (previous)



layer-F_Cu.png (now)



changed pixels in magenta

## layer-In1_Cu.png



layer-In1_Cu.png (previous)



layer-In1_Cu.png (now)

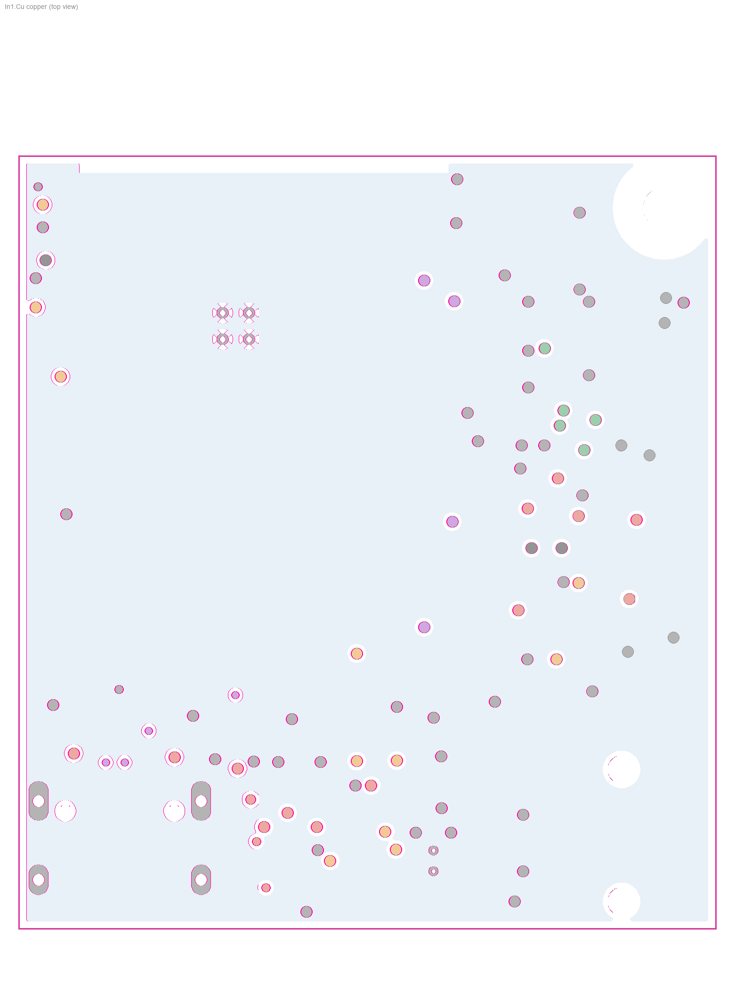
[picture p43: hardware/lovelace-as-003/renders/latest/diff-layer-In1_Cu.png]


changed pixels in magenta

## layer-In2_Cu.png



layer-In2_Cu.png (previous)



layer-In2_Cu.png (now)



changed pixels in magenta

## layer-B_Cu.png



layer-B_Cu.png (previous)



layer-B_Cu.png (now)

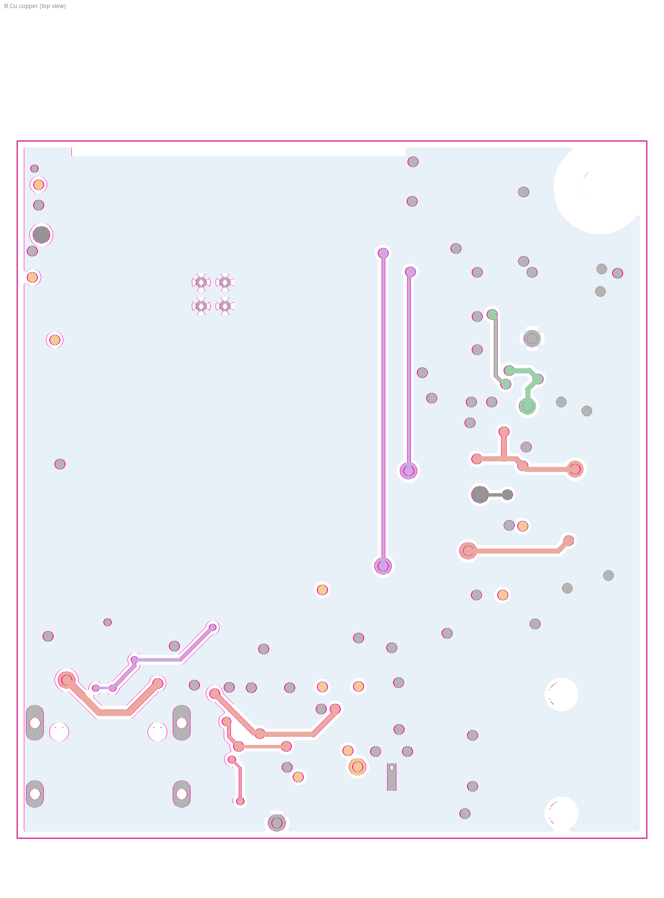
[picture p44: hardware/lovelace-as-003/renders/latest/diff-layer-B_Cu.png]


changed pixels in magenta

## 버전 기록

버전 | 날짜 | 상태 | 요약 | 파일
AudioStream S3 rev A ESP32-S3-WROOM-1 N16R8 + PCM5102A, 80 × 60 mm, 4층 | 2026-10-14 | 보관 · 주문 안 함 | 첫 일체형 설계. Wi-Fi AirPlay / Spotify만(S3라 Bluetooth Classic 없음). 배선·DRC 완료, 실물 미검증. | README.md · schematic.pdf · audiostream-s3-rev-a-prototype.zip
LOVELACE AS-001 ESP32-S3-WROOM-1 N16R8 + PCM5102A, 55 × 55 mm, 4층 | 2026-10-14 | 보관 · 주문 안 함 | LOVELACE 이름으로 축소(면적 −37%), eFuse 전원 보호, 전원 스위치, LED. S3라 Bluetooth 없음 → WROVER로 전환. | README.md · REVIEW.md · schematic.pdf · lovelace-as-001-prototype.zip
LOVELACE AS-002 rev B ESP32-WROVER-E N8R8 + PCM5102A, 35 × 50 mm, 4층 | 2026-10-14 | 보관 · 원본 없음 | WROVER로 바꿔 Bluetooth A2DP 추가. 고정 홀 2개, BOOT + RESET + 전원 스위치, THT AUX 잭. 같은 폴더에서 rev C로 덮어써서 구리층 이미지만 남음. | README.md
LOVELACE AS-002 rev C ESP32-WROVER-E N8R8 + PCM5102A, 37 × 41 mm, 4층 | 2026-10-15 | 보관 · 주문 안 함 | 면적 −13%, 스위치·RESET 삭제(꽂으면 켜짐), SMD AUX 잭, FreeRouting 배선. AUX 잭 Tip/Ring 배정 오류, XSMT 고정, CPL 회전 미보정 → AS-003에서 수정. | README.md · lovelace-as-002.kicad_pcb
LOVELACE AS-003 rev A ESP32-WROVER-E N8R8 + PCM5102A, 37 × 41 mm, 4층 | 2026-10-15 | 현재 · 주문 전 | AUX 잭 배정 수정, XSMT를 GPIO22로(기본 뮤트) + DAC 전원 홀드업(언플러그 팝), JLC 기준 CPL, KiCadRoutingTools 3단계 배선, M2 고정 홀, 바닥 테스트 패드. | README.md · REVIEW.md · BRINGUP.md · lovelace-as-003-revA-release.zip

### LOVELACE AS-003 rev A — ESP32-WROVER-E N8R8 + PCM5102A, 37 × 41 mm, 4층



pcba-iso.png



pcba-top.png



routing.png



assembly-top.png

### LOVELACE AS-002 rev C — ESP32-WROVER-E N8R8 + PCM5102A, 37 × 41 mm, 4층



pcba-iso.png



pcba-top.png



routing.png



assembly-top.png

### LOVELACE AS-002 rev B — ESP32-WROVER-E N8R8 + PCM5102A, 35 × 50 mm, 4층



copper-F_Cu.png



copper-B_Cu.png

### LOVELACE AS-001 — ESP32-S3-WROOM-1 N16R8 + PCM5102A, 55 × 55 mm, 4층



pcba-iso.png



pcba-top.png



routing.png



assembly-top.png

### AudioStream S3 rev A — ESP32-S3-WROOM-1 N16R8 + PCM5102A, 80 × 60 mm, 4층



pcba-iso.png



pcba-top.png



routing.png



assembly-top.png
