chanulee/audiostream-esp32/hardware/archive/README.md

# 하드웨어 버전 기록

| # | 버전 | 크기 | 날짜 | 상태 | 폴더 |
|---|---|---|---|---|---|
| 01 | AudioStream S3 rev A (ESP32-S3) | 80 × 60 mm | 2026-10-14 | 보관 | [01-audiostream-s3-revA](01-audiostream-s3-revA/README.md) |
| 02 | LOVELACE AS-001 (ESP32-S3) | 55 × 55 mm | 2026-10-14 | 보관 | [02-lovelace-as-001](02-lovelace-as-001/README.md) |
| 03 | LOVELACE AS-002 rev B (WROVER) | 35 × 50 mm | 2026-10-14 | 보관, 이미지만 | [03-lovelace-as-002-revB](03-lovelace-as-002-revB/README.md) |
| 04 | LOVELACE AS-002 rev C (WROVER) | 37 × 41 mm | 2026-10-15 | 보관 | [04-lovelace-as-002-revC](04-lovelace-as-002-revC/README.md) |
| 05 | LOVELACE AS-003 rev A (WROVER) | 37 × 41 mm | 2026-10-15 | 보관 | [05-lovelace-as-003-revA](05-lovelace-as-003-revA/README.md) |
| 06 | LOVELACE AS-004 rev A (WROVER) | 37 × 41 mm | 2026-10-16 | 보관 | [06-lovelace-as-004-revA](06-lovelace-as-004-revA/README.md) |
| 07 | LOVELACE AS-005 rev A (WROVER) | 37 × 41 mm | 2026-10-16 | 보관 | [07-lovelace-as-005-revA](07-lovelace-as-005-revA/README.md) |
| 08 | LOVELACE AS-006 rev A (WROVER) | 37 × 41 mm | 2026-10-16 | 보관 | [08-lovelace-as-006-revA](08-lovelace-as-006-revA/README.md) |
| 09 | LOVELACE AS-007 rev A (WROVER) | 37 × 41 mm | 2026-10-16 | 보관 | [09-lovelace-as-007-revA](09-lovelace-as-007-revA/README.md) |
| — | **LOVELACE AS-008 rev A** (WROVER) | 37 × 41 mm | 2026-10-19 | **현재**, 주문 전 | [../lovelace-as-008](../lovelace-as-008/README.md) |

렌더를 나란히 보려면 [index.html](index.html)을 엽니다(현재 보드의 `renders/latest/index.html` 아래쪽에도 같은 기록이 있습니다). 둘 다 `hardware/versions.json`에서 만들어집니다.

## 버전 규칙

- **AS-<n>**: 새 설계입니다. 주문 전에 구리(넷리스트, 외곽, 배선)가 바뀌면 번호를 올립니다. 같은 이름의 Gerber가 두 가지로 존재하지 않게 하기 위해서입니다.
- **rev A, B, …**: 주문한 뒤에 같은 설계를 고친 판입니다. 실크에 `AS-004 rev A`처럼 찍히고, KiCad title block, 릴리스 zip 이름(`lovelace-as-004-revA-release.zip`)에도 같은 값이 들어갑니다. 실크 문구는 편집기의 `silkscreen.json`에 있으므로 번호를 올릴 때 함께 고칩니다. 빠뜨리면 `audit_pcb.py`가 빌드를 멈춥니다.
- 값은 `plan_pcb.py`의 `BOARD_ID`, `BOARD_REV` 한 곳에서만 정합니다.
- 새 버전을 시작할 때는 현재 폴더를 `archive/NN-<이름>/`으로 복사해 보관합니다. 그다음 현재 폴더 이름과 `BOARD_ID`를 올리고, `versions.json`에 항목을 추가합니다.
- 주문한 판은 git 태그 `hw/<board>-rev<X>`(예: `hw/as-004-revA`)로 표시합니다.
- 펌웨어 버전(`firmware/version.txt`)은 하드웨어와 따로 올립니다. 호환 범위는 루트 README에 적습니다.
