chanulee/audiostream-esp32/hardware/archive/07-lovelace-as-005-revA/README.md

# LOVELACE / AS-005 rev A (보관, 버전 기록 07)

ESP32-WROVER-E-N8R8 + PCM5102A, **37 × 41 mm, 4층**, KiCadRoutingTools 배선. AS-004와 넷리스트·배치·배선이 같고, AUX 잭(J2)의 위치 결정 홀(Ø1.0mm)과 패드 폭(1.5mm)만 Shou Han 도면에 맞춘 판입니다. 주문하지 않았습니다.

이 폴더의 파일은 2026-10-16 커밋 `5b278f9` 시점 그대로입니다.

| 파일 | 내용 |
|---|---|
| `lovelace-as-005.kicad_pcb`, `.kicad_sch` | 보드와 회로도. 풋프린트는 파일 안에 들어 있어 KiCad로 바로 열립니다 |
| `lovelace-as-005-revA-release.zip` | Gerber, drill, IPC-D-356, JLC BOM / CPL. SHA-256 `91feea1f5eaa452aa4bb60d9b892aff450491d3348f273179294c2f3cc0437d5` |
| `REVIEW.md`, `REVIEW_NETLIST.md`, `REVIEW_LAYOUT.md`, `BRINGUP.md` | 당시 검토 문서와 첫 보드 절차. 링크와 경로는 당시 폴더(`hardware/lovelace-as-005/`) 기준입니다 |
| `renders/` | `render_board.py` 출력(PCBA, 맨 기판, 배치도, 층별 구리, 배선도). `renders/extra/`는 3D 뷰, 회로도·층 PDF |

생성 스크립트는 같은 폴더에서 AS-006으로 이어져 따로 보관하지 않았습니다. 커밋 `5b278f9`에서 `hardware/lovelace-as-005/`를 꺼내면 그대로 다시 만들 수 있습니다.

## AS-006으로 올린 이유

AS-005는 KiCad 기본 풋프린트의 패드 위치와 길이를 그대로 썼습니다. Shou Han PJ-320D 도면의 "P.C.B LAYOUT"과 다시 대조해 보니, 플러그 축 방향 위치(패드 간격 3.0 / 4.0 / 1.1mm)는 0.1mm 이내로 맞았습니다. 하지만 축에서 패드까지의 거리가 달랐습니다.

| | 도면 | AS-005 | AS-006 |
|---|---|---|---|
| 축에서 패드가 덮는 범위 | 3.05–4.65mm (몸체 폭 6.1mm 바깥) | 2.0–4.5mm | 2.85–4.85mm |
| 패드 중심 / 길이 | 3.85 / 1.6mm | 3.25 / 2.5mm | 3.85 / 2.0mm |

AS-005 패드는 1mm가 몸체 아래로 들어가고, 바깥 끝은 도면보다 0.15mm 짧았습니다. 단자 끝을 덮지 못하면 필렛이 생기지 않습니다. 플러그를 꽂고 뺄 때 받는 힘이 이 접합부에 걸리므로 패드를 옮겼습니다.

옮긴 김에 같은 대조에서 찾은 CPL 문제도 고쳤습니다. `jlc_check.py`는 J2의 CPL 좌표를 패드 평균으로 맞추고 있었습니다. JLC 풋프린트와 패드 위치가 달라서, AS-005에서는 JLC 위치 결정 핀이 우리 홀에서 0.125mm 어긋나 있었습니다. 핀 Ø0.75mm가 홀 Ø1.0mm에 들어가므로 여유는 0.125mm뿐입니다. AS-006부터는 J2를 핀 기준으로 놓고 어긋남(0.000mm)을 검사합니다.
