chanulee/audiostream-esp32/hardware/archive/01-audiostream-s3-revA/renders/index.html

# audiostream-s3

버전 기록

## pcba-iso.png



pcba-iso.png (now)

## pcba-top.png



pcba-top.png (now)

## pcba-bottom.png

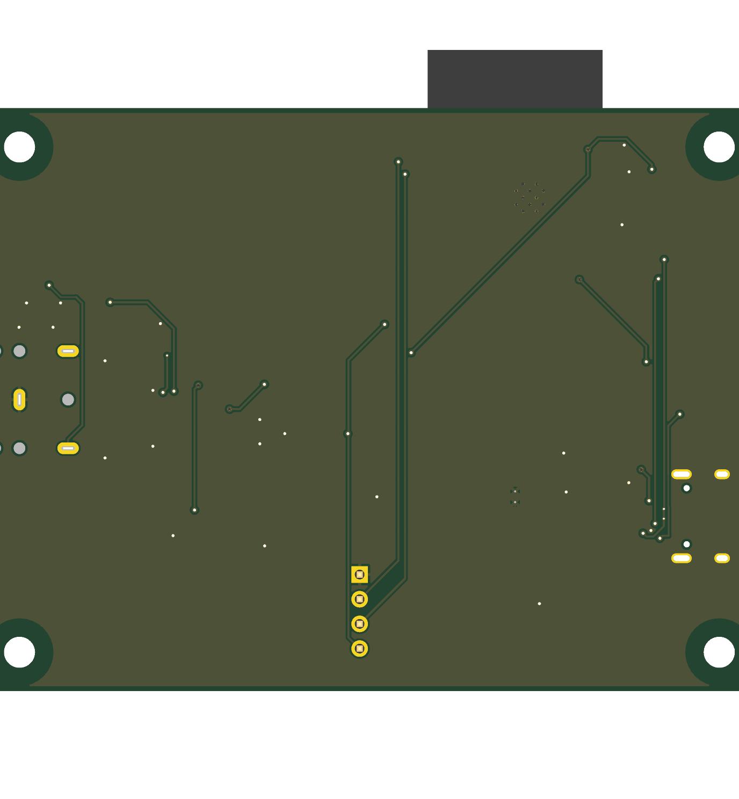
[picture p45: hardware/archive/01-audiostream-s3-revA/renders/pcba-bottom.png]


pcba-bottom.png (now)

## bare-top.png



bare-top.png (now)

## bare-bottom.png

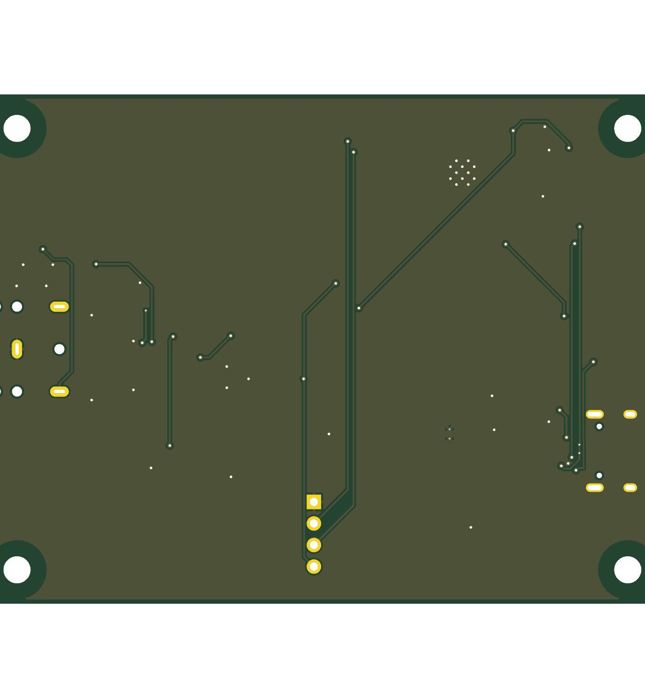
[picture p46: hardware/archive/01-audiostream-s3-revA/renders/bare-bottom.png]


bare-bottom.png (now)

## assembly-top.png



assembly-top.png (now)

## routing.png



routing.png (now)

## layer-F_Cu.png

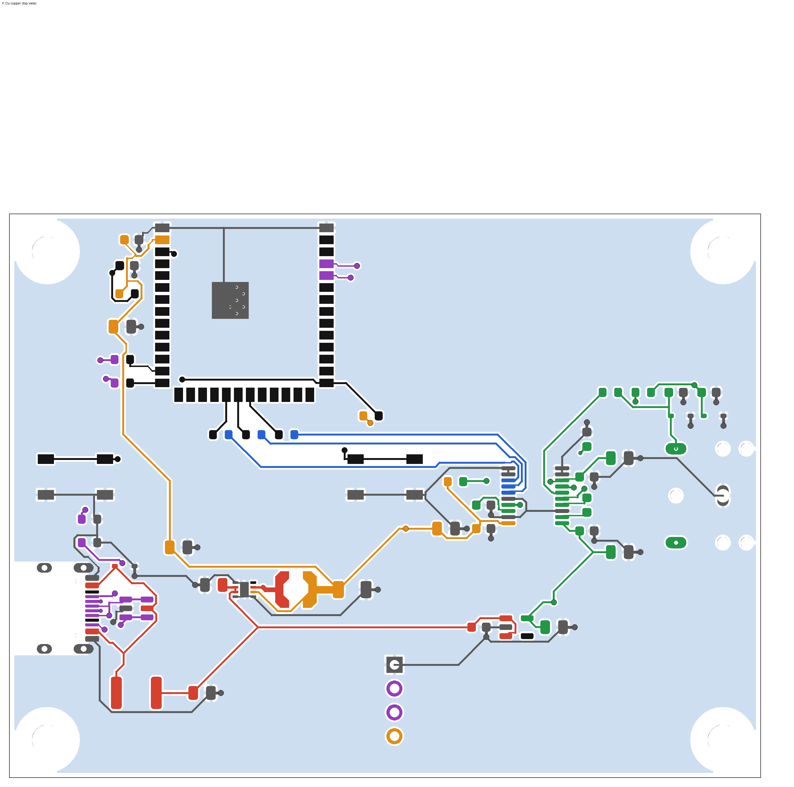
[picture p47: hardware/archive/01-audiostream-s3-revA/renders/layer-F_Cu.png]


layer-F_Cu.png (now)

## layer-In1_Cu.png



layer-In1_Cu.png (now)

## layer-In2_Cu.png



layer-In2_Cu.png (now)

## layer-B_Cu.png



layer-B_Cu.png (now)
