chanulee/audiostream-esp32/hardware/lovelace-as-008/renders/extra/3d-angle-6.png

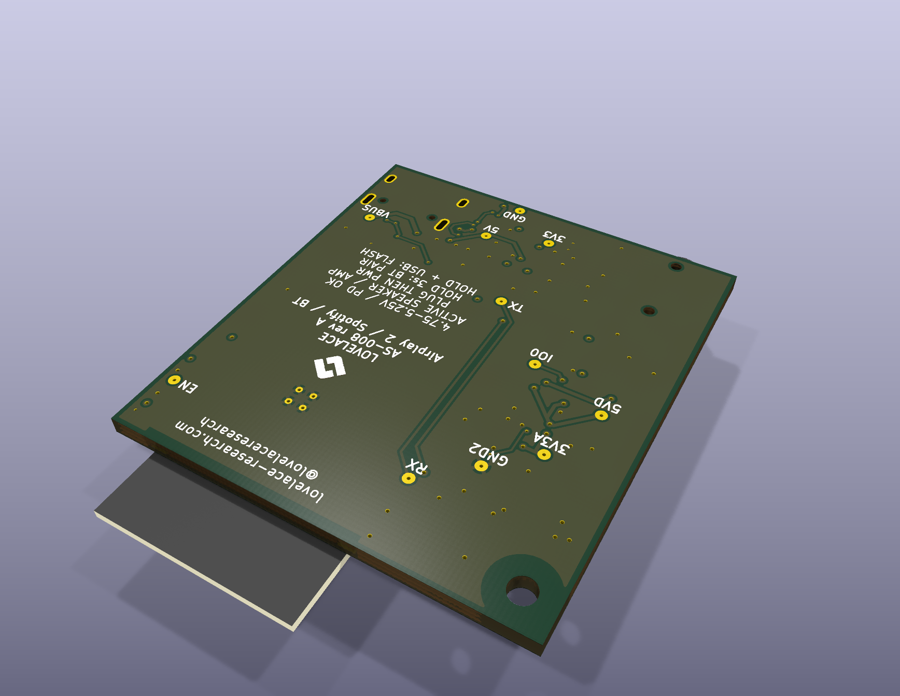
hardware/lovelace-as-008/renders/extra/3d-angle-6.png
