chanulee/audiostream-esp32/hardware/lovelace-as-008/renders/extra/3d-back.png

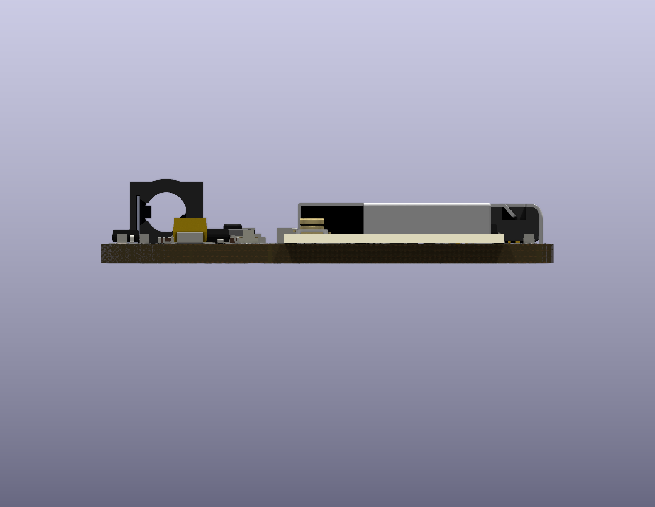
hardware/lovelace-as-008/renders/extra/3d-back.png
