chanulee/audiostream-esp32/hardware/lovelace-as-008/renders/extra/3d-bottom.png

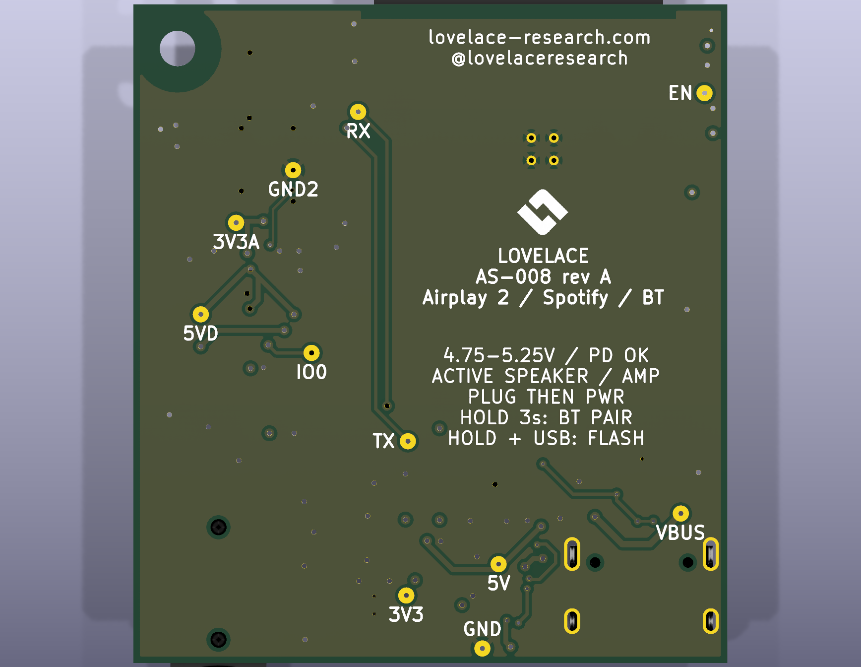
hardware/lovelace-as-008/renders/extra/3d-bottom.png
