chanulee/audiostream-esp32/hardware/lovelace-as-008/renders/extra/3d-front.png

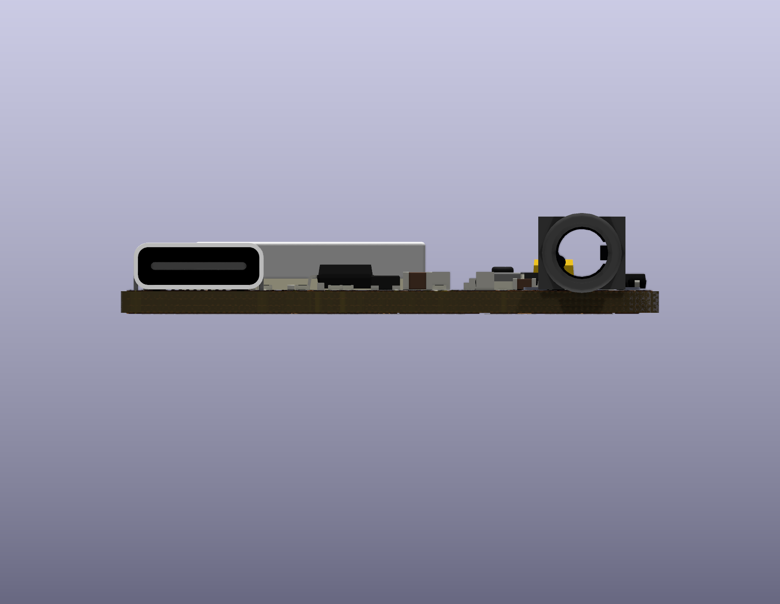
hardware/lovelace-as-008/renders/extra/3d-front.png
