chanulee/audiostream-esp32/hardware/lovelace-as-008/renders/extra/3d-top.png

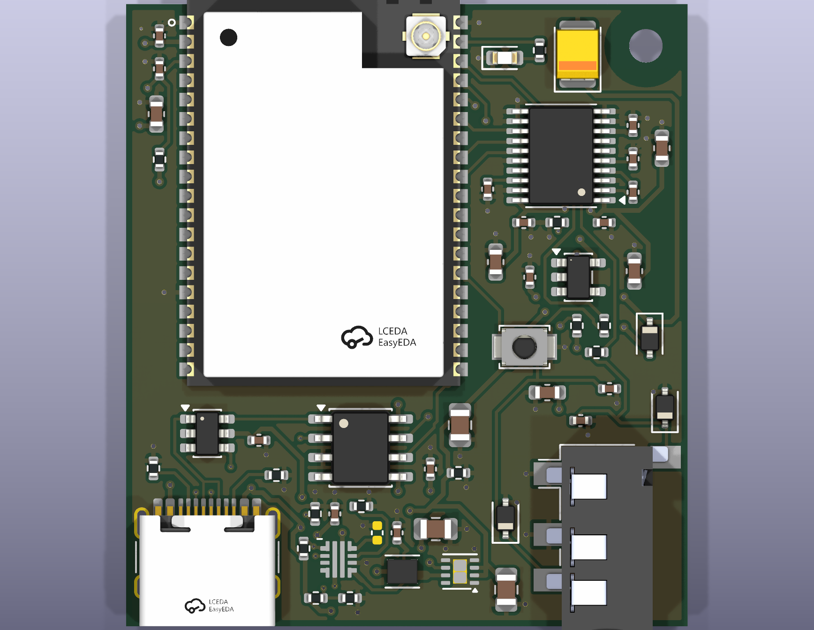
hardware/lovelace-as-008/renders/extra/3d-top.png
