chanulee/audiostream-esp32/hardware/lovelace-as-008/reports/preview_bottom.png

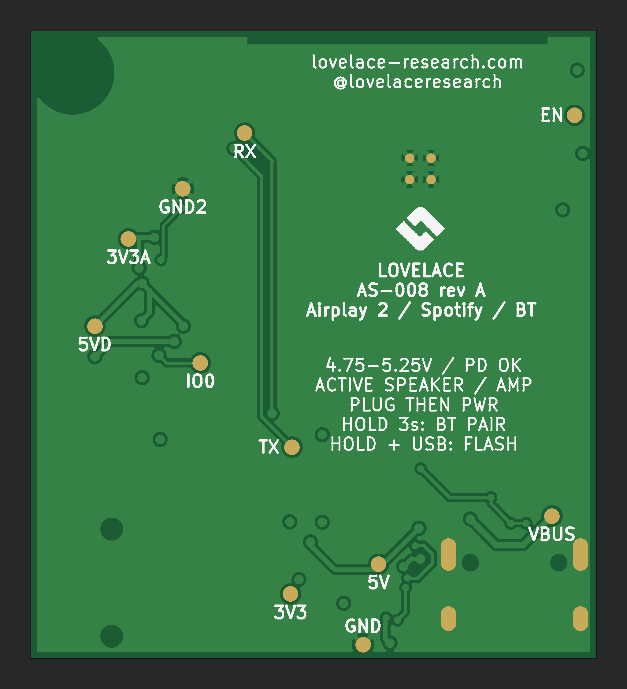
hardware/lovelace-as-008/reports/preview_bottom.png
