chanulee/audiostream-esp32/hardware/lovelace-as-008/reports/preview_top.png

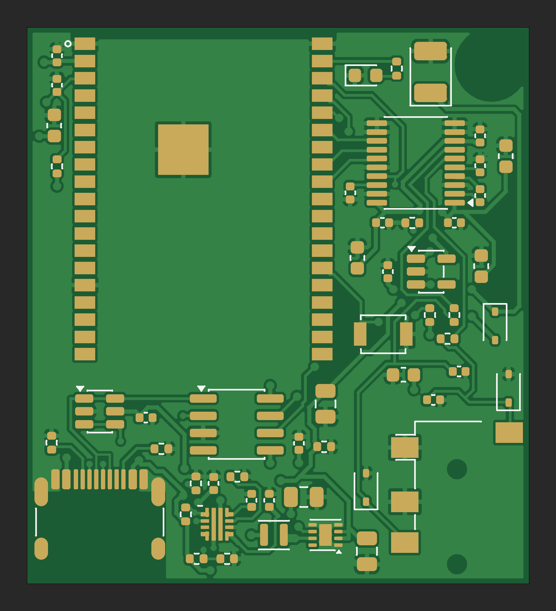
hardware/lovelace-as-008/reports/preview_top.png
