chanulee/audiostream-esp32/hardware/lovelace-as-005/bom.csv

Comment | Designator | Footprint | LCSC Part # | Quantity
1uF | C1,C8 | C_0402_1005Metric | C52923 | 2
2.2uF | C13,C12 | C_0402_1005Metric | C12530 | 2
2.2nF | C19,C20 | C_0402_1005Metric | C106861 | 2
100nF | C2,C18,C14,C10,C16,C23,C24 | C_0402_1005Metric | C1525 | 7
100nF | C21 | C_0402_1005Metric | C307331 | 1
10nF | C22 | C_0402_1005Metric | C15195 | 1
220uF | C25 | CP_EIA-3528-21_Kemet-B | C212684 | 1
10uF | C3,C15,C17,C9,C5 | C_0603_1608Metric | C19702 | 5
22uF | C6 | C_0805_2012Metric | C45783 | 1
10uF | C7,C4 | C_0805_2012Metric | C15850 | 2
PESD5V0S1BA | D2,D3 | D_SOD-323 | C19224 | 2
KT-0603G | D4 | LED_0603_1608Metric | C12624 | 1
RB551V-30 | D5 | D_SOD-323 | C8529 | 1
HRO TYPE-C-31-M-12 | J1 | USB_C_Receptacle_HRO_TYPE-C-31-M-12 | C165948 | 1
PJ-320D | J2 | Jack_3.5mm_PJ320D_Horizontal_ShouHan | C431535 | 1
2.2uH | L1 | L_Murata_DFE201610P | C79317 | 1
5.1k | R1,R2,R15 | R_0402_1005Metric | C25905 | 3
470 | R11,R12 | R_0402_1005Metric | C25117 | 2
383k | R13 | R_0402_1005Metric | C163468 | 1
100k | R14 | R_0402_1005Metric | C852472 | 1
255k | R16 | R_0402_1005Metric | C270623 | 1
220 | R18 | R_0402_1005Metric | C25091 | 1
100k | R19,R17 | R_0402_1005Metric | C25741 | 2
10k | R5,R10,R6 | R_0402_1005Metric | C25744 | 3
B3U-1000P | SW1 | SW_SPST_B3U-1000P | C231329 | 1
ESP32-WROVER-E-N8R8 | U1 | ESP32-WROVER-E | C2973667 | 1
PCM5102APWR | U2 | TSSOP-20_4.4x6.5mm_P0.65mm | C107671 | 1
TPS62162DSGR | U3 | Texas_DSG0008A_WSON-8-1EP_2x2mm_P0.5mm_EP0.9x1.6mm_ThermalVias | C40256 | 1
TPS7A2033PDBVR | U4 | SOT-23-5 | C2862740 | 1
USBLC6-2SC6 | U5 | SOT-23-6 | C7519 | 1
TPS259470ARPWR | U6 | TPS25947_RPW0010A | C3662799 | 1
CH340N | U7 | SOIC-8_3.9x4.9mm_P1.27mm | C2977777 | 1
