chanulee/audiostream-esp32/hardware/lovelace-as-008/renders/extra/layers.pdf

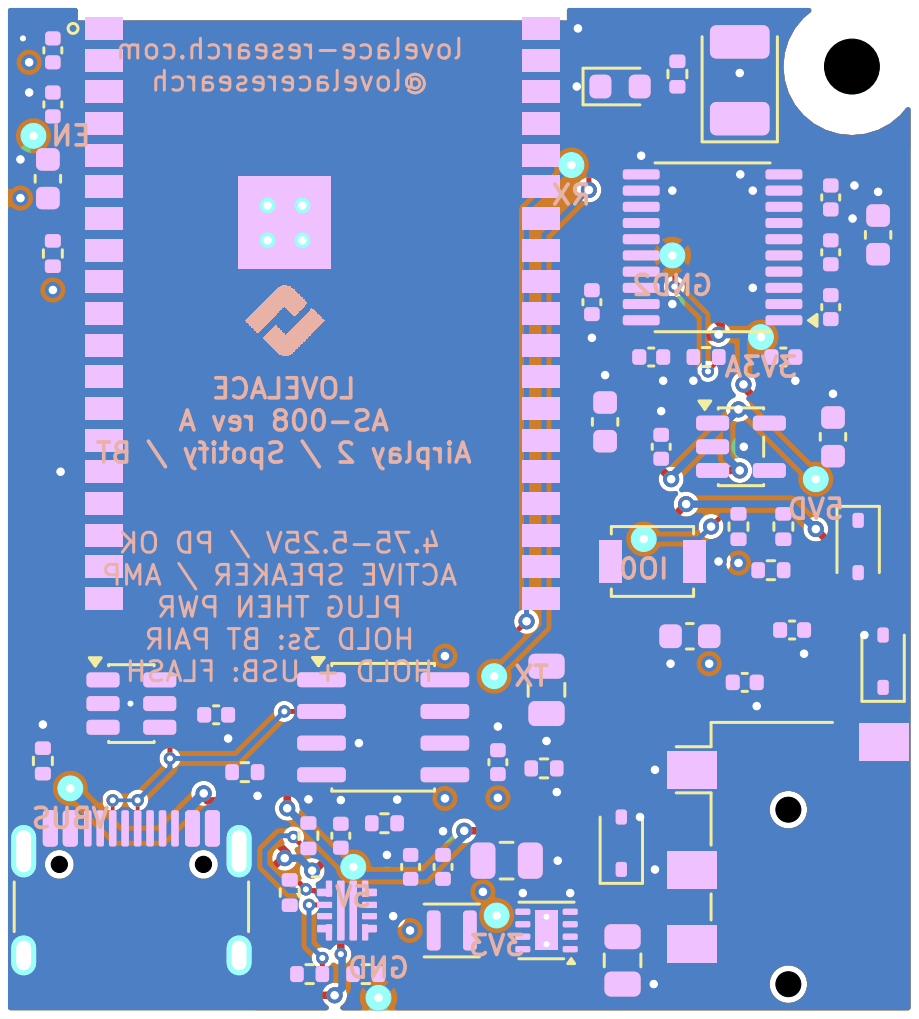
[picture p60: page 1]

A rev AS-008 BT / Spotify / 2 Airplay VBUS

OK PD / 4.75-5.25V AMP / SPEAKER ACTIVE PWR THEN PLUG PAIR BT 3s: HOLD FLASH USB: + HOLD
