chanulee/audiostream-esp32/hardware/lovelace-as-008/renders/extra/schematic.pdf

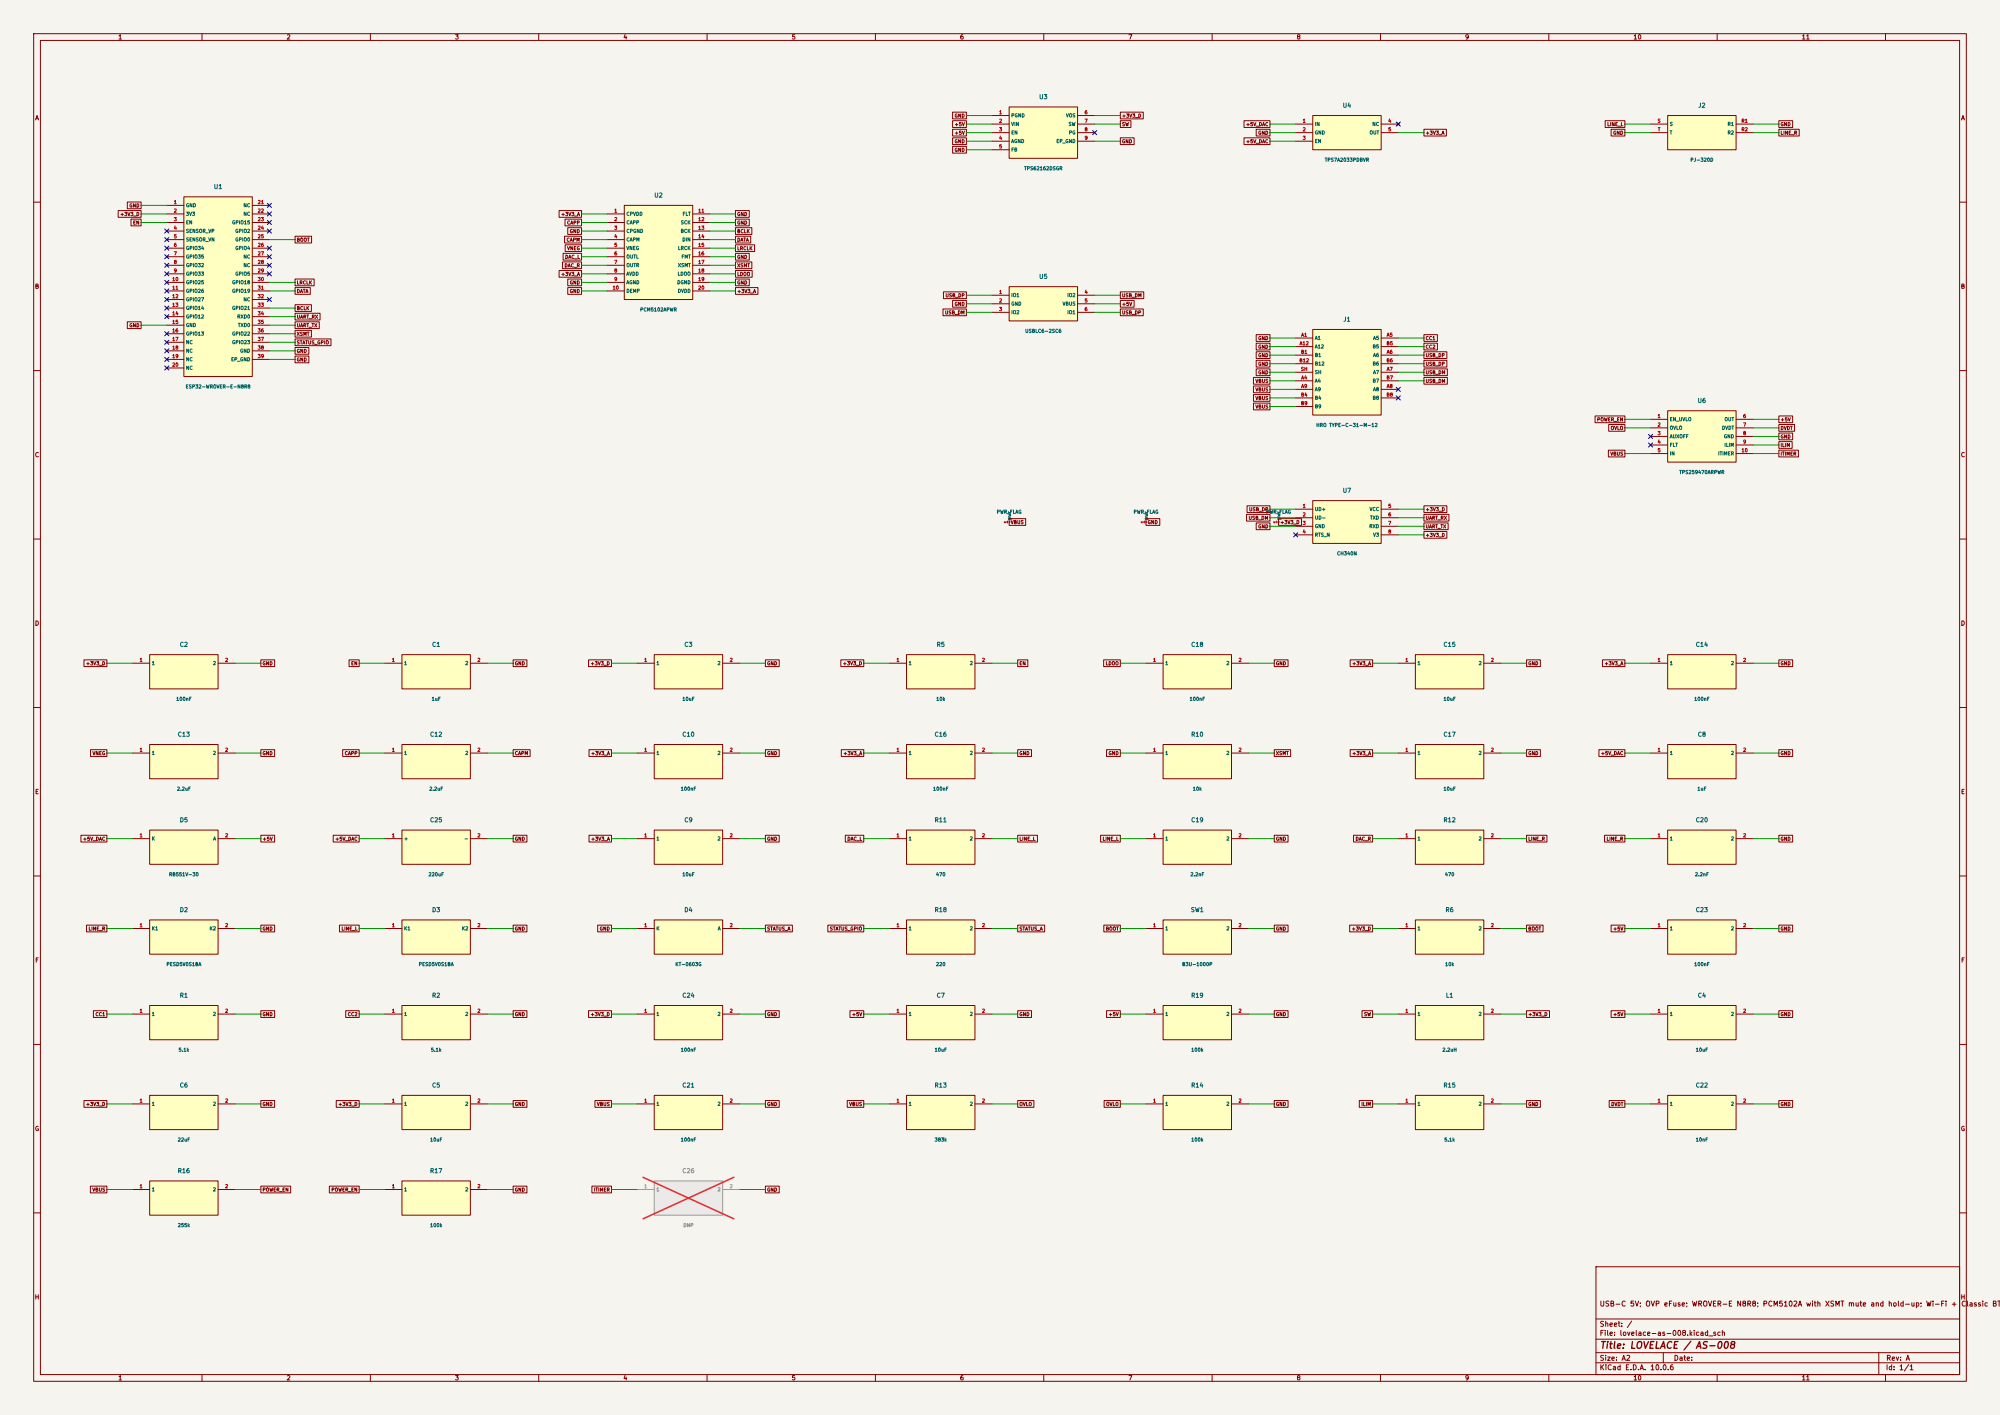
[picture p61: page 1]

Size: A2 | Rev: A
KiCad E.D.A. 10.0.6 | Id: 1/1
