chanulee/audiostream-esp32/hardware/lovelace-as-008/renders/latest/assembly-top.pdf

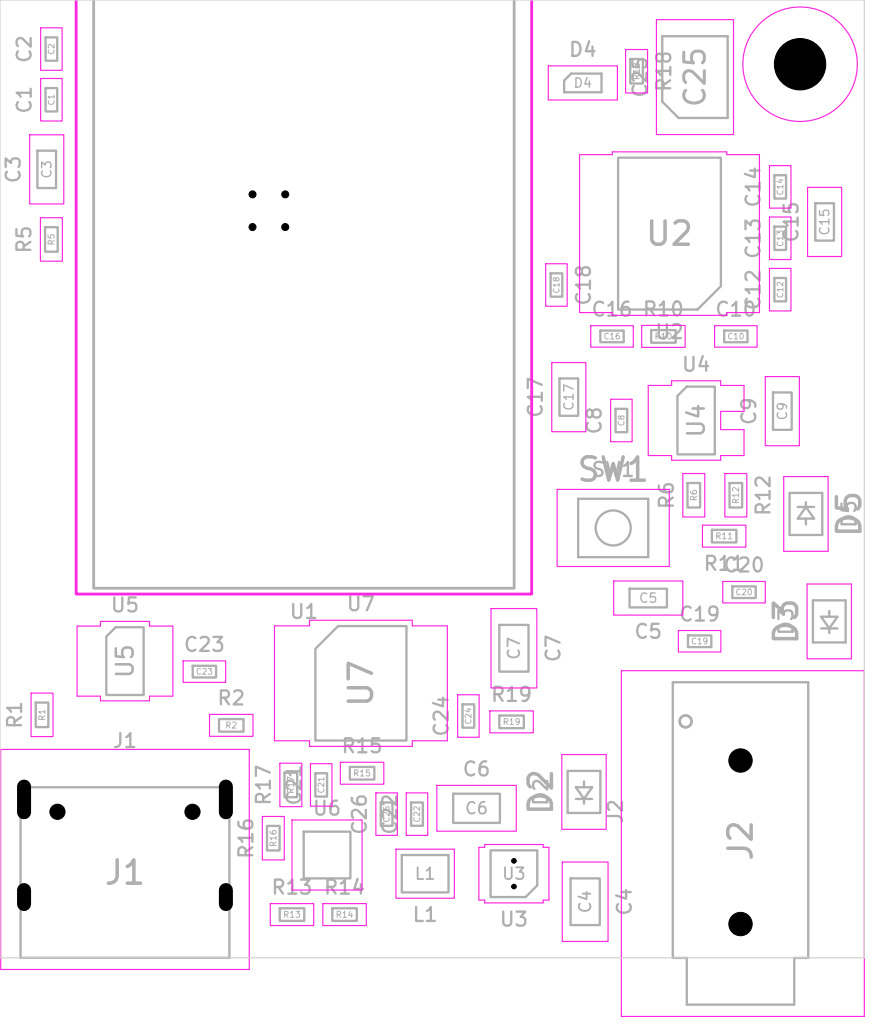
[picture p62: page 1]
