chanulee/audiostream-esp32/hardware/lovelace-as-006/renders/extra/schematic.pdf

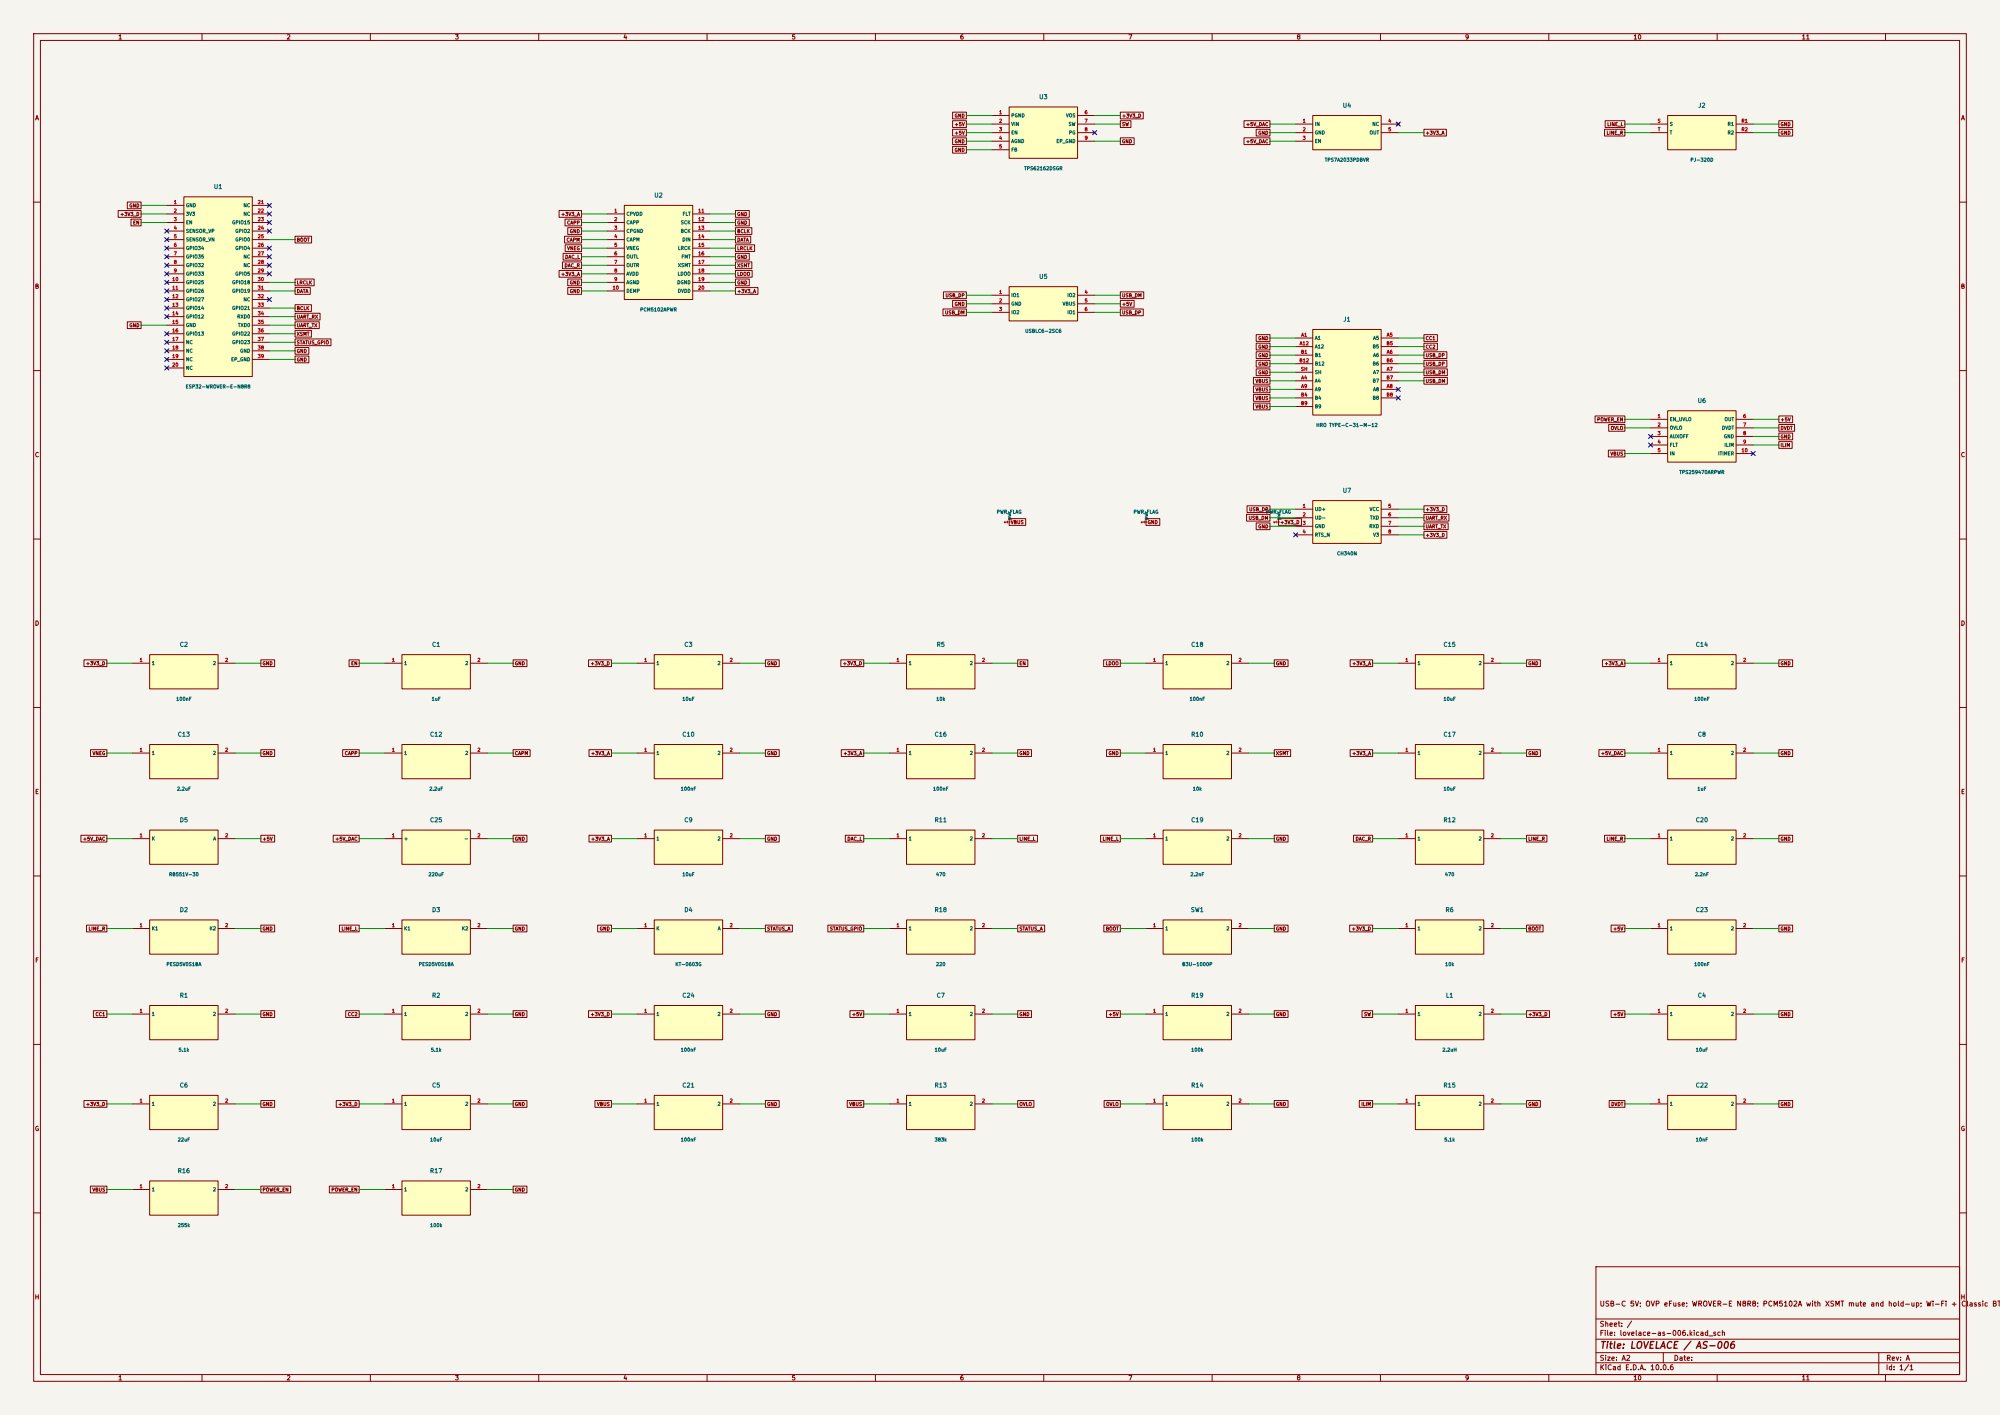
[picture p64: page 1]

Size: A2 | Rev: A
KiCad E.D.A. 10.0.6 | Id: 1/1
