chanulee/audiostream-esp32/hardware/archive/07-lovelace-as-005-revA/renders/extra/schematic.pdf

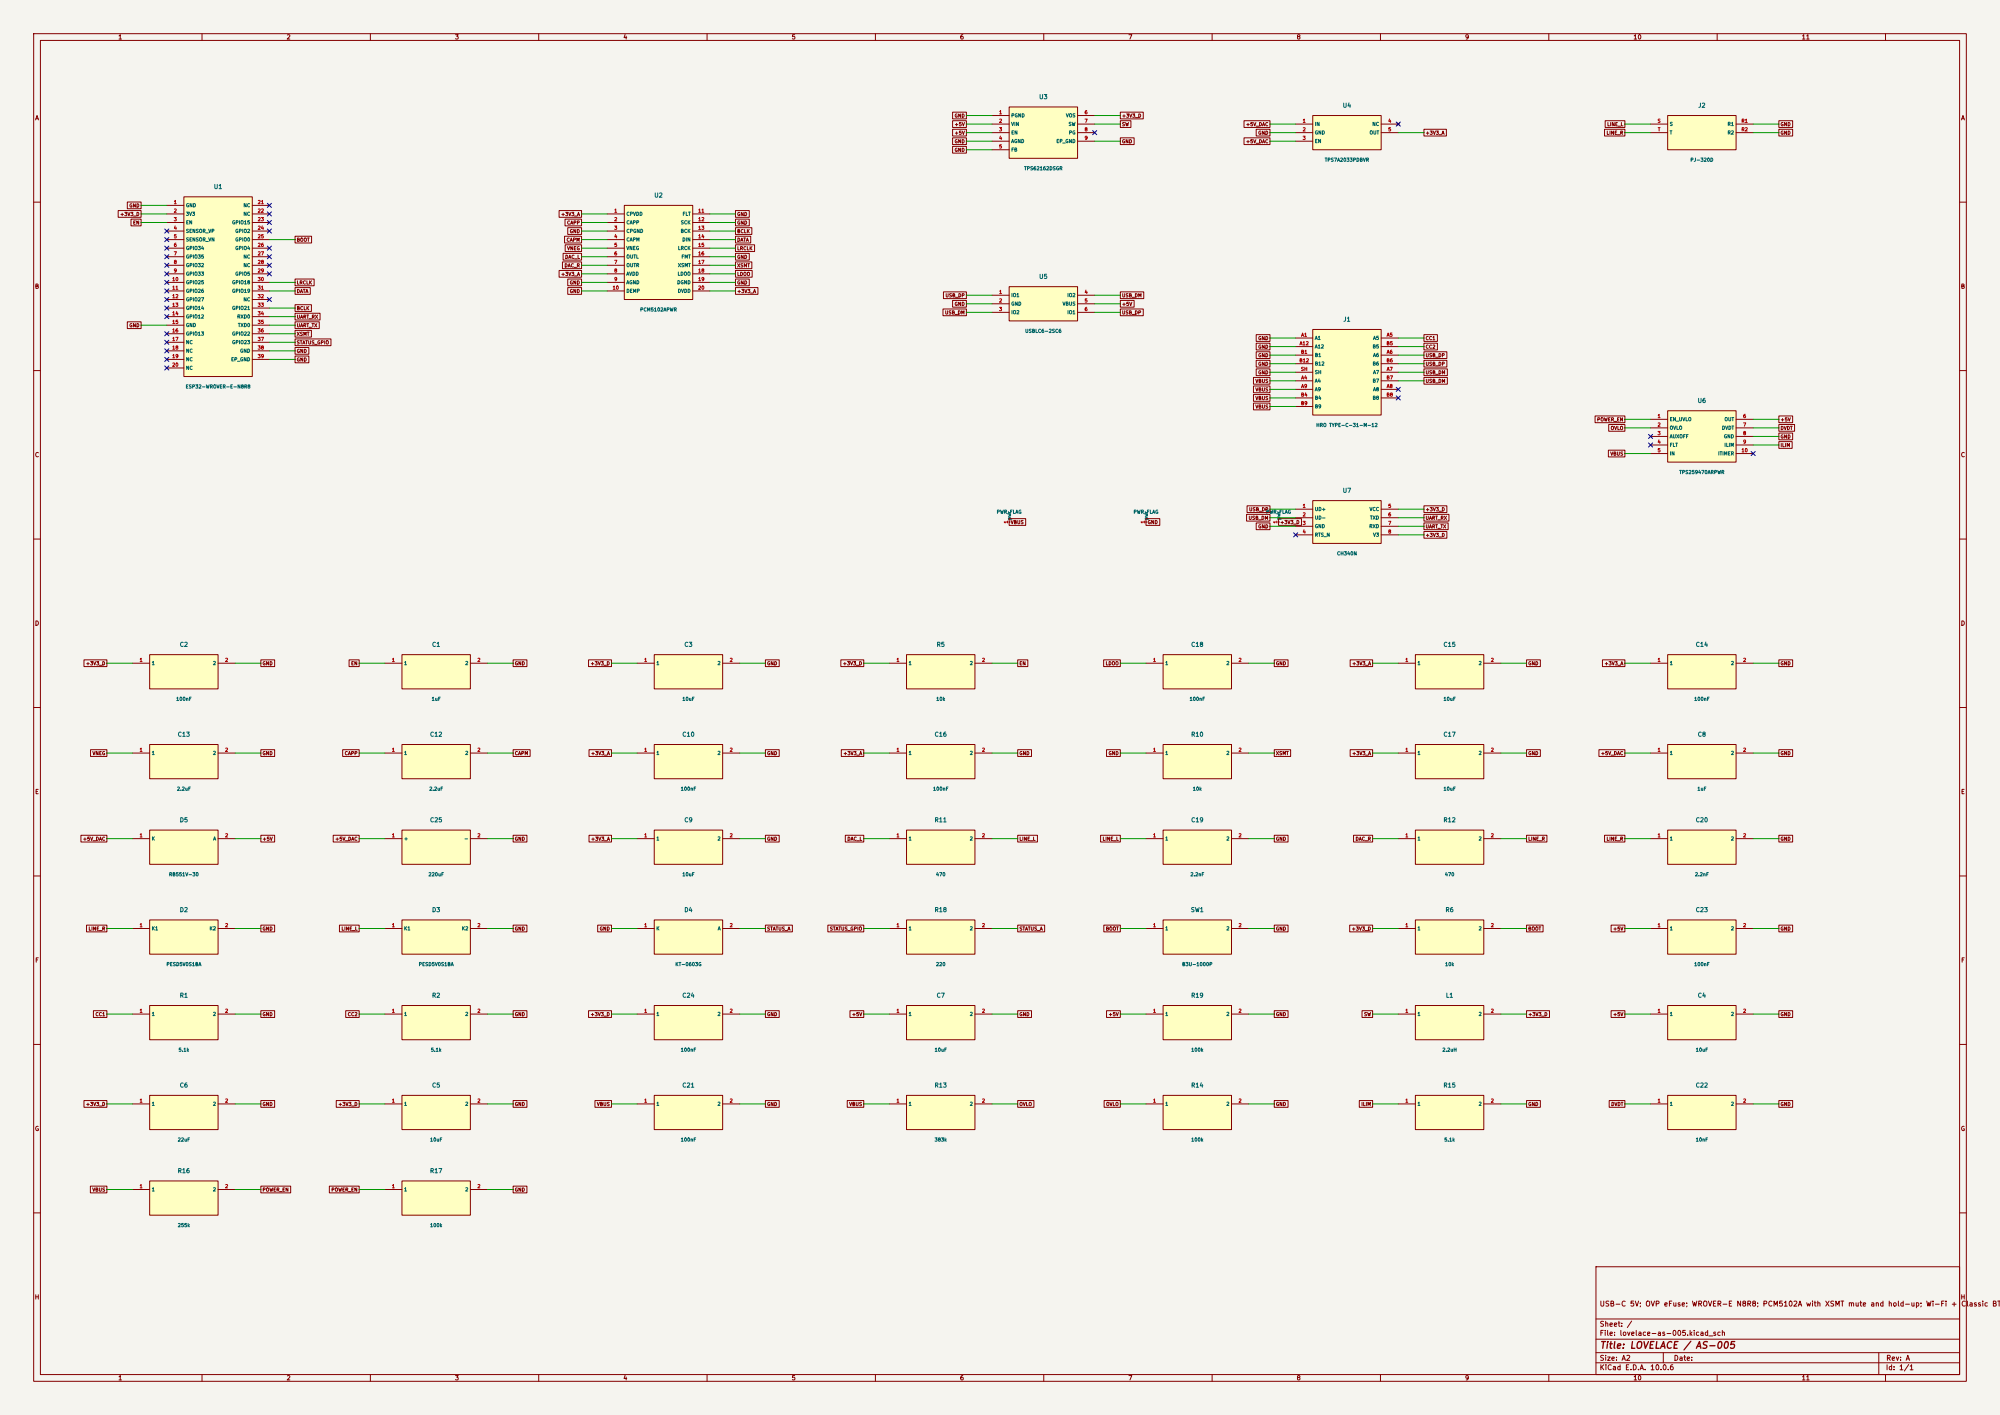
[picture p66: page 1]

Size: A2 | Rev: A
KiCad E.D.A. 10.0.6 | Id: 1/1
