chanulee/audiostream-esp32/hardware/archive/01-audiostream-s3-revA/copper-layers.pdf

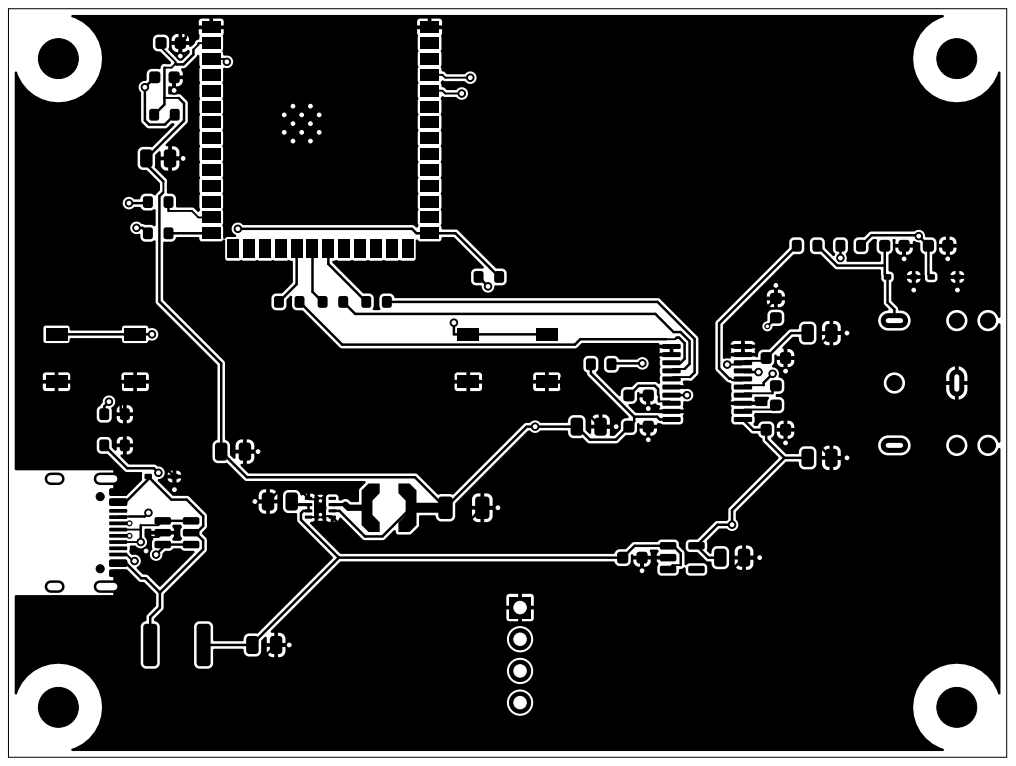
[picture p67: page 1]

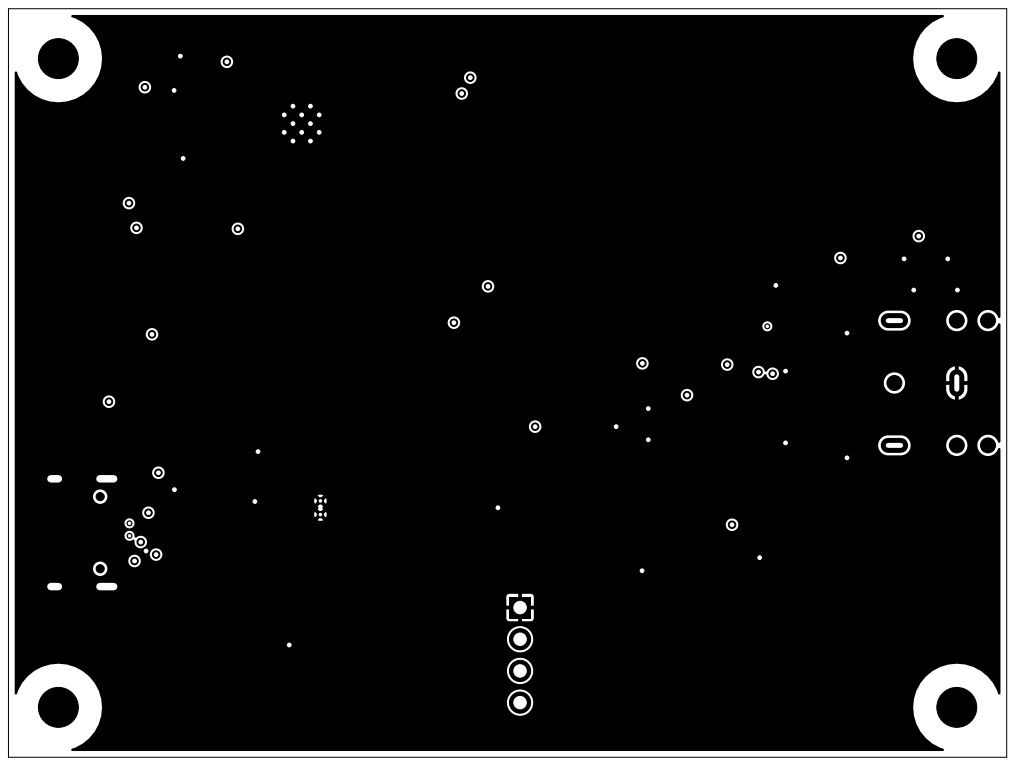
[picture p68: page 2]

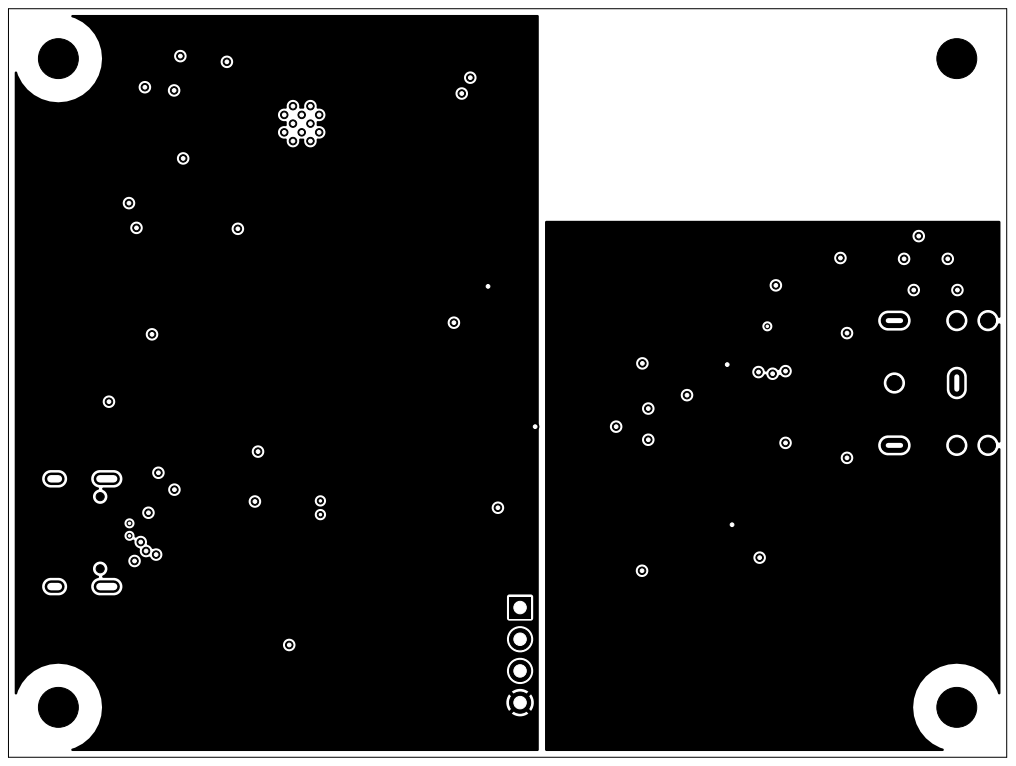
[picture p69: page 3]

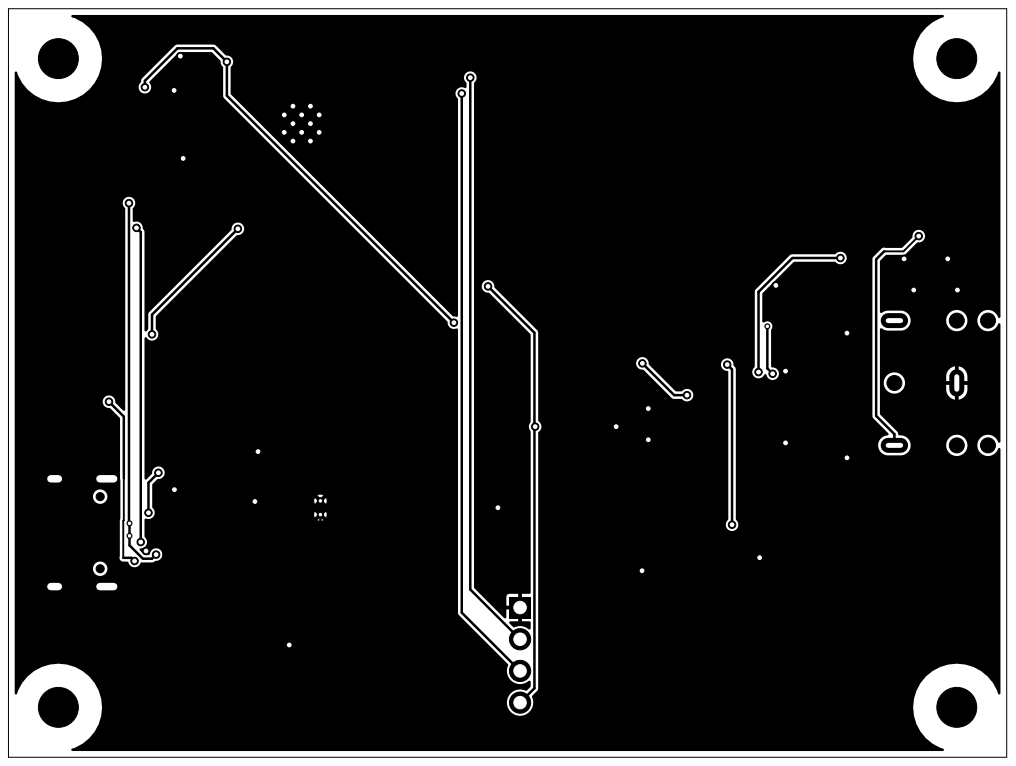
[picture p70: page 4]
