chanulee/audiostream-esp32/hardware/lovelace-as-007/renders/latest/assembly-top.pdf

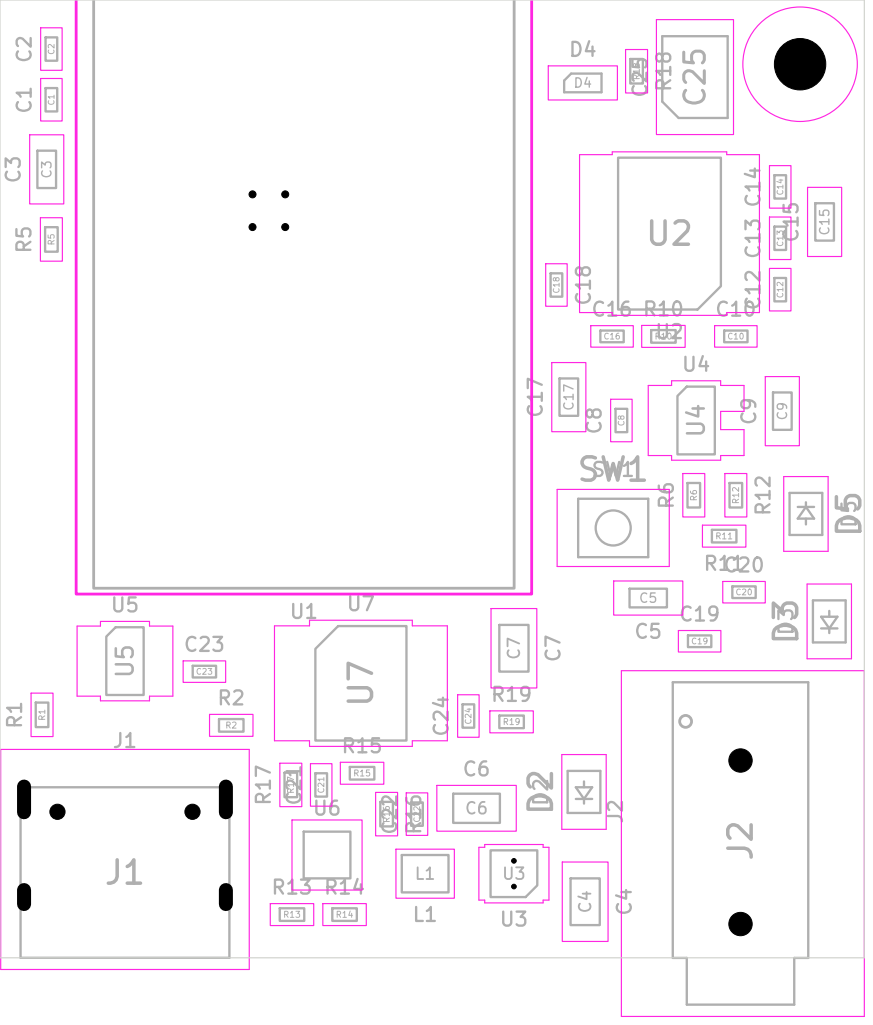
[picture p71: page 1]
