chanulee/audiostream-esp32/hardware/archive/08-lovelace-as-006-revA/renders/assembly-top.pdf

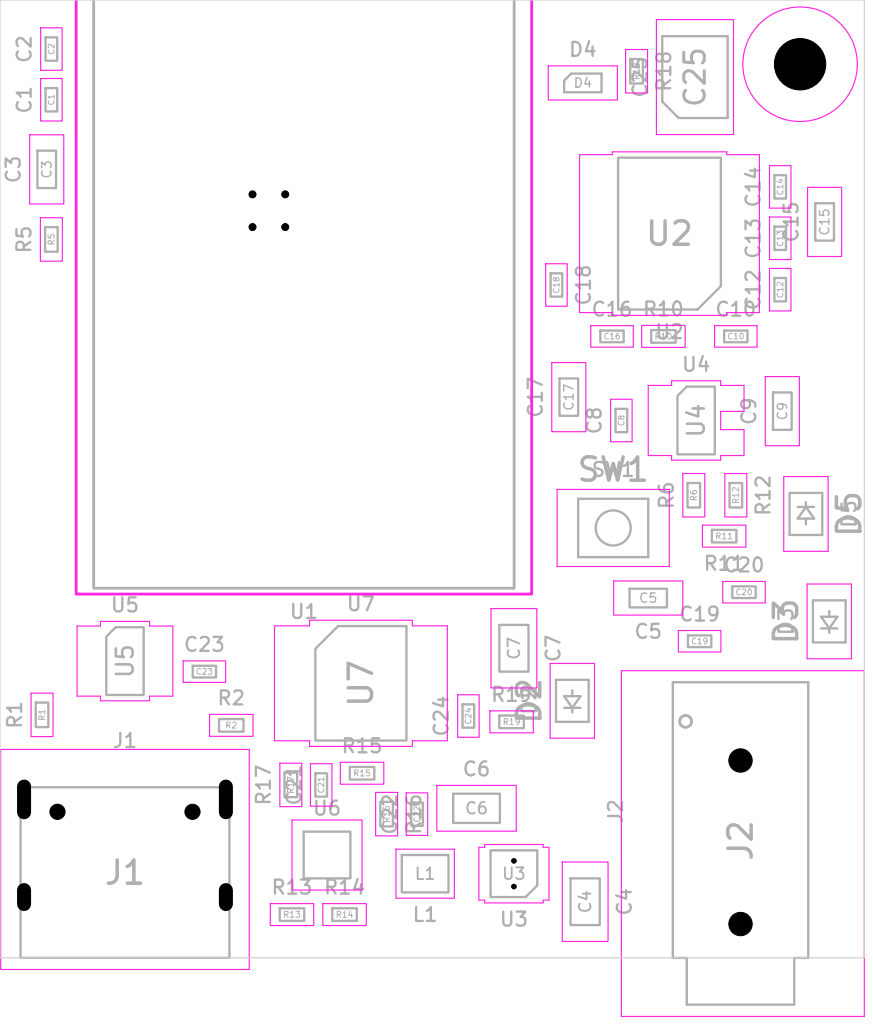
[picture p72: page 1]
