chanulee/audiostream-esp32/hardware/lovelace-as-005/renders/latest/assembly-top.pdf

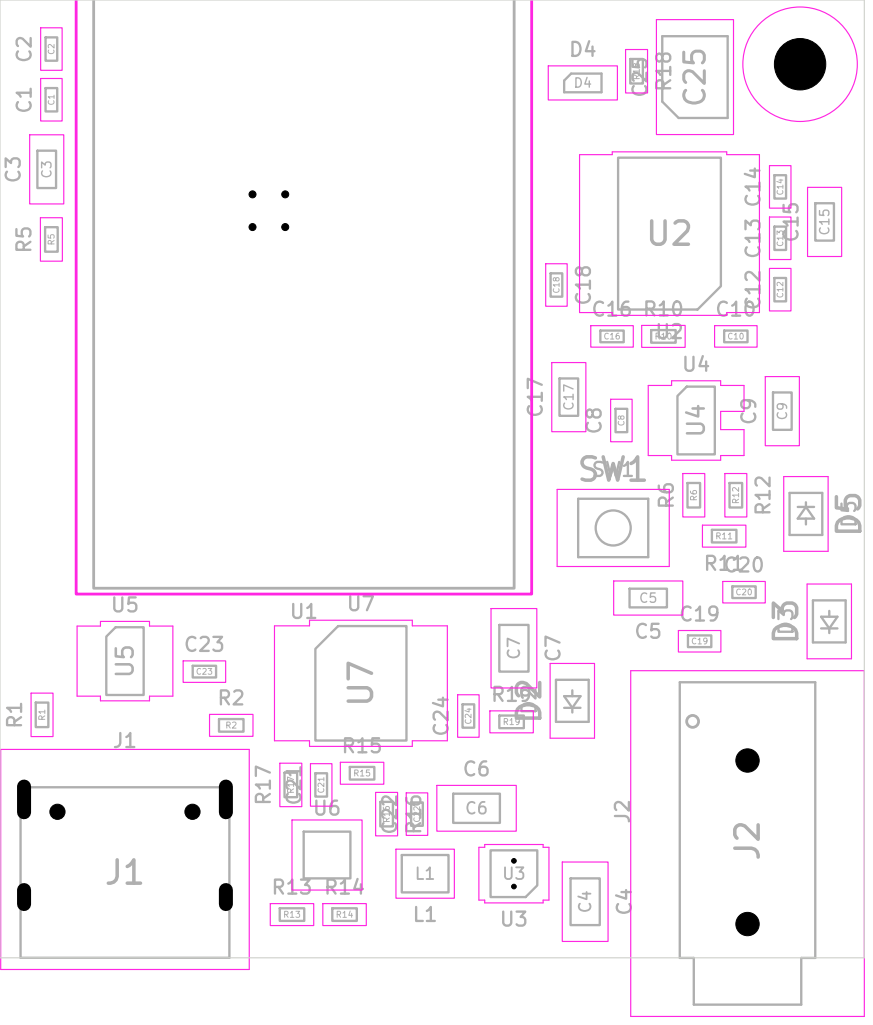
[picture p73: page 1]
