chanulee/audiostream-esp32/hardware/lovelace-as-003/renders/latest/assembly-top.pdf

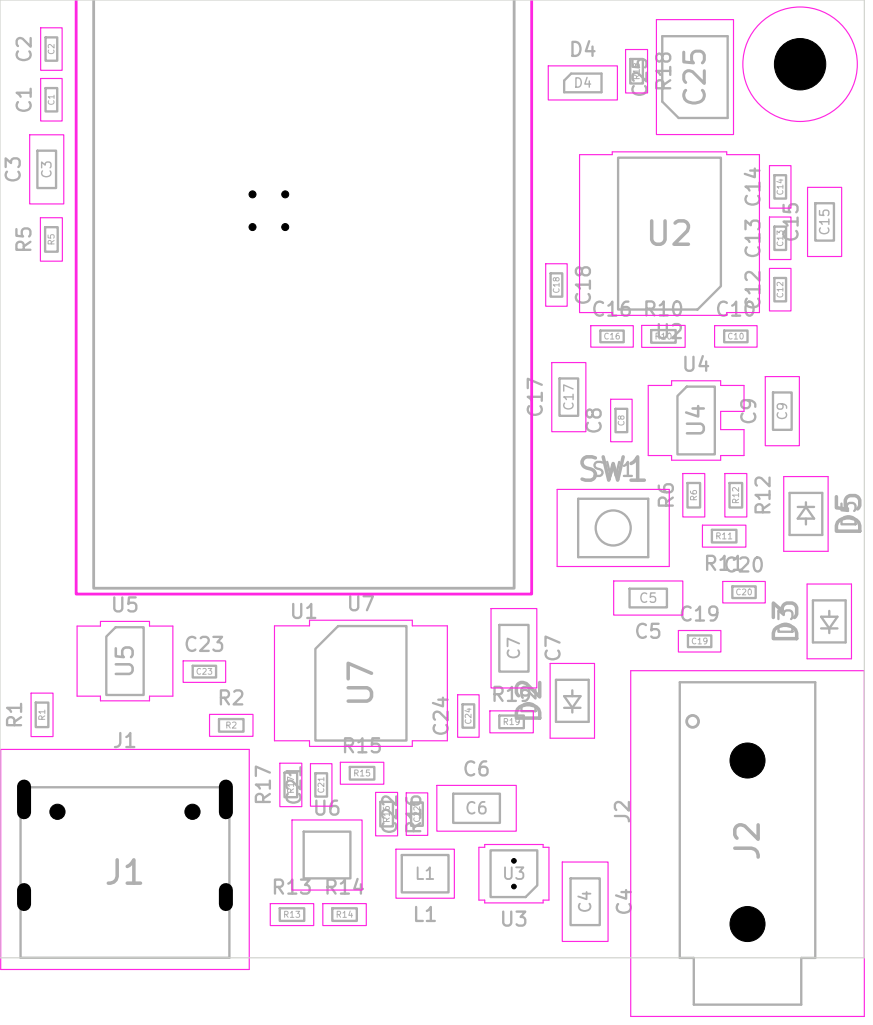
[picture p74: page 1]
