chanulee/audiostream-esp32/(list of files, drawings)

Other design files:
hardware/archive/01-audiostream-s3-revA/audiostream-s3.dsn
hardware/archive/08-lovelace-as-006-revA/renders/svg/pcb-model-check.json
hardware/lovelace-as-005/lovelace-as-005.dsn
hardware/lovelace-as-006/lovelace-as-006.dsn
hardware/lovelace-as-007/lovelace-as-007.dsn
hardware/lovelace-as-008/lovelace-as-008.dsn
