chanulee/audiostream-esp32/hardware/lovelace-as-008/lovelace-as-008.kicad_pcb

## KiCad design hardware/lovelace-as-008/lovelace-as-008.kicad_pcb (2026-10-18)

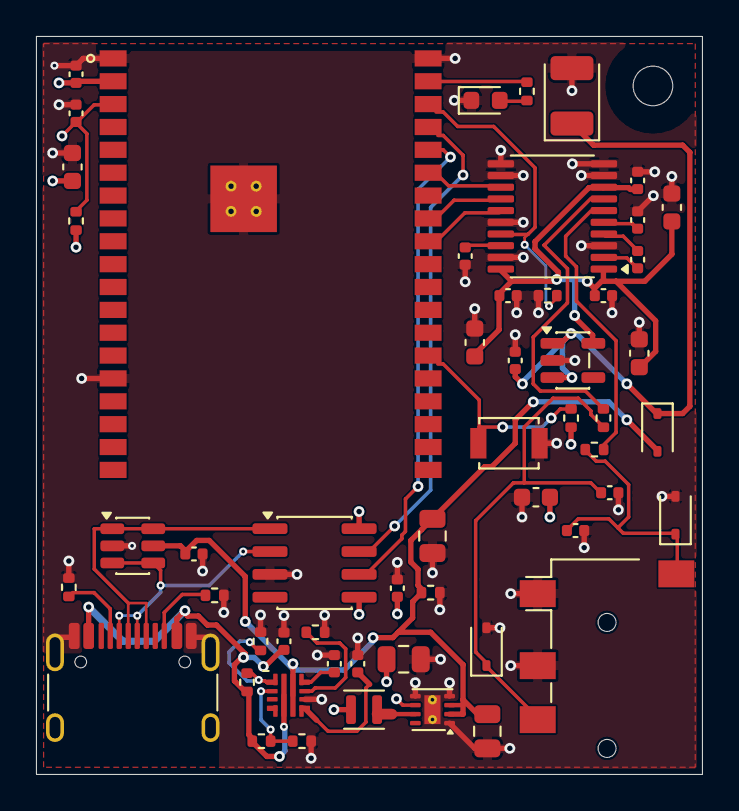
[picture p75: board lovelace-as-008.kicad_pcb from above]

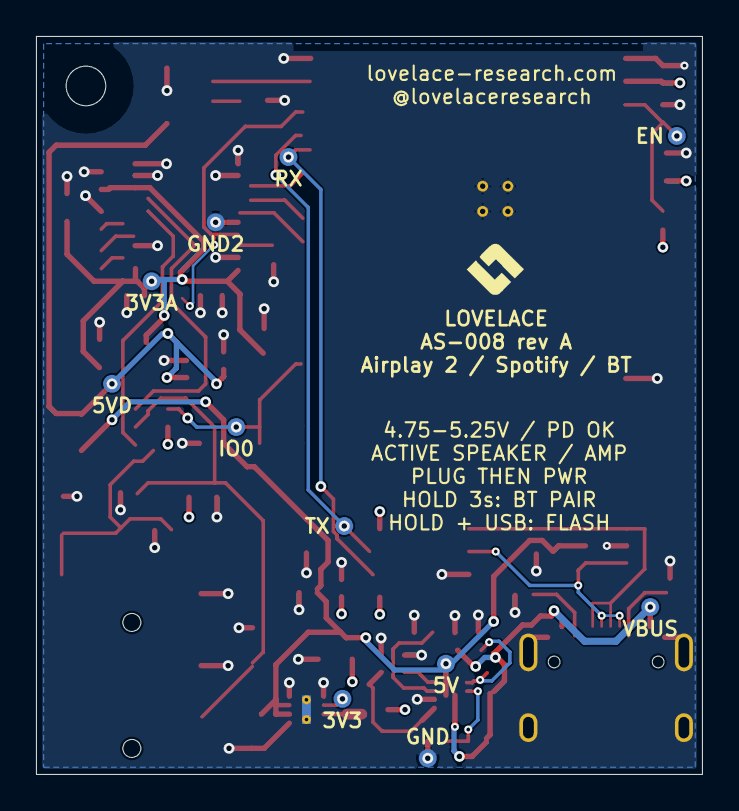
[picture p76: board lovelace-as-008.kicad_pcb from below]

Board: 4 copper layers, 37.0 x 41.0 mm, 66 parts (11 on the bottom side), 34 nets.

Parts:
3V3: +3V3_D; TestPoint_Pad_D1.0mm
3V3A: +3V3_A; TestPoint_Pad_D1.0mm
5V: +5V; TestPoint_Pad_D1.0mm
5VD: +5V_DAC; TestPoint_Pad_D1.0mm
C1, C8: 1uF; C_0402_1005Metric
C2, C10, C14, C16, C18, C21, C23, C24: 100nF; C_0402_1005Metric
C3, C5, C9, C15, C17: 10uF; C_0603_1608Metric
C4, C7: 10uF; C_0805_2012Metric
C6: 22uF; C_0805_2012Metric
C12, C13: 2.2uF; C_0402_1005Metric
C19, C20: 2.2nF; C_0402_1005Metric
C22: 10nF; C_0402_1005Metric
C25: 220uF; CP_EIA-3528-21_Kemet-B
C26: DNP; C_0402_1005Metric
D2, D3: PESD5V0S1BA; D_SOD-323
D4: KT-0603G; LED_0603_1608Metric
D5: RB551V-30; D_SOD-323
EN: EN; TestPoint_Pad_D1.0mm
GND, GND2: GND; TestPoint_Pad_D1.0mm
H1: M2; MountingHole_2.2mm_M2
IO0: BOOT; TestPoint_Pad_D1.0mm
J1: HRO TYPE-C-31-M-12; USB_C_Receptacle_HRO_TYPE-C-31-M-12
J2: PJ-320D; Jack_3.5mm_PJ320D_Horizontal_ShouHan
L1: 2.2uH; L_Murata_DFE201610P
R1, R2, R15: 5.1k; R_0402_1005Metric
R5, R6, R10: 10k; R_0402_1005Metric
R11, R12: 470; R_0402_1005Metric
R13: 383k; R_0402_1005Metric
R14, R17, R19: 100k; R_0402_1005Metric
R16: 255k; R_0402_1005Metric
R18: 220; R_0402_1005Metric
RX: UART_RX; TestPoint_Pad_D1.0mm
SW1: B3U-1000P; SW_SPST_B3U-1000P
TX: UART_TX; TestPoint_Pad_D1.0mm
U1: ESP32-WROVER-E-N8R8; ESP32-WROVER-E
U2: PCM5102APWR; TSSOP-20_4.4x6.5mm_P0.65mm
U3: TPS62162DSGR; Texas_DSG0008A_WSON-8-1EP_2x2mm_P0.5mm_EP0.9x1.6mm_ThermalV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
U4: TPS7A2033PDBVR; SOT-23-5
U5: USBLC6-2SC6; SOT-23-6
U6: TPS259470ARPWR; TPS25947_RPW0010A
U7: CH340N; SOIC-8_3.9x4.9mm_P1.27mm
VBUS: VBUS; TestPoint_Pad_D1.0mm

Connections:
+3V3_A: 3V3A.1, C9.1, C10.1, C14.1, C15.1, C16.1, C17.1, U2.1, U2.8, U2.20, U4.5
+3V3_D: 3V3.1, C2.1, C3.1, C5.1, C6.1, C24.1, L1.2, R5.1, R6.1, U1.2, U3.6, U7.5, U7.8
+5V: 5V.1, C4.1, C7.1, C23.1, D5.2, R19.1, U3.2, U3.3, U5.5, U6.6
+5V_DAC: 5VD.1, C8.1, C25.1, D5.1, U4.1, U4.3
BCLK: U1.33, U2.13
BOOT: IO0.1, R6.2, SW1.1, U1.25
CAPM: C12.2, U2.4
CAPP: C12.1, U2.2
CC1: J1.A5, R1.1
CC2: J1.B5, R2.1
DAC_L: R11.1, U2.6
DAC_R: R12.1, U2.7
DATA: U1.31, U2.14
DVDT: C22.1, U6.7
EN: C1.1, EN.1, R5.2, U1.3
GND: C1.2, C2.2, C3.2, C4.2, C5.2, C6.2, C7.2, C8.2, C9.2, C10.2, C13.2, C14.2, C15.2, C16.2, C17.2, C18.2, C19.2, C20.2, C21.2, C22.2, C23.2, C24.2, C25.2, C26.2, D2.2, D3.2, D4.1, GND.1, GND2.1, J1.A1, J1.A12, J1.B1, J1.B12, J1.SH, J2.R1, J2.T, R1.2, R2.2, R10.1, R14.2, R15.2, R17.2, R19.2, SW1.2, U1.1, U1.15, U1.38, U1.39, U2.3, U2.9, U2.10, U2.11, U2.12, U2.16, U2.19, U3.1, U3.4, U3.5, U3.9, U4.2, U5.2, U6.8, U7.3
ILIM: R15.1, U6.9
ITIMER: C26.1, U6.10
LDOO: C18.1, U2.18
LINE_L: C19.1, D3.1, J2.S, R11.2
LINE_R: C20.1, D2.1, J2.R2, R12.2
LRCLK: U1.30, U2.15
OVLO: R13.2, R14.1, U6.2
POWER_EN: R16.2, R17.1, U6.1
STATUS_A: D4.2, R18.2
STATUS_GPIO: R18.1, U1.37
SW: L1.1, U3.7
UART_RX: RX.1, U1.34, U7.6
UART_TX: TX.1, U1.35, U7.7
USB_DM: J1.A7, J1.B7, U5.3, U5.4, U7.2
USB_DP: J1.A6, J1.B6, U5.1, U5.6, U7.1
VBUS: C21.1, J1.A4, J1.A9, J1.B4, J1.B9, R13.1, R16.1, U6.5, VBUS.1
VNEG: C13.1, U2.5
XSMT: R10.2, U1.36, U2.17
