chanulee/audiostream-esp32/firmware/components/boards/esp32-generic/iot_board.h

#pragma once

#include "board_common.h"
#include "sdkconfig.h"

#define BOARD_NAME        "LOVELACE AS-004"
#define BOARD_DESCRIPTION "ESP32-WROVER-E-N8R8 + PCM5102A line out"

#define BOARD_I2S_BCK_GPIO CONFIG_I2S_BCK_IO
#define BOARD_I2S_WS_GPIO  CONFIG_I2S_WS_IO
#define BOARD_I2S_DO_GPIO  CONFIG_I2S_DO_IO

#define BOARD_LED_STATUS_GPIO CONFIG_LED_STATUS_GPIO
#define BOARD_LED_ERROR_GPIO  CONFIG_LED_ERROR_GPIO
#define BOARD_LED_RGB_GPIO    CONFIG_LED_RGB_GPIO

#define BOARD_MUTE_GPIO       CONFIG_MUTE_GPIO
#define BOARD_MUTE_GPIO_LEVEL CONFIG_MUTE_GPIO_LEVEL
