chanulee/audiostream-esp32/firmware/components/spotify/cspot/src/LoginBlob.cpp

#include "LoginBlob.h"

#include <stdexcept>
#ifdef ESP_PLATFORM
#include "esp_mac.h"
#endif
#include <stdio.h>           // for sprintf
#include <initializer_list>  // for initializer_list

#include "BellLogger.h"                  // for AbstractLogger
#include "ConstantParameters.h"          // for brandName, cspot, protoc...
#include "Logger.h"                      // for CSPOT_LOG
#include "protobuf/authentication.pb.h"  // for AuthenticationType_AUTHE...
#ifdef BELL_ONLY_CJSON
#include "cJSON.h"
#else
#include "nlohmann/detail/json_pointer.hpp"  // for json_pointer<>::string_t
#include "nlohmann/json.hpp"      // for basic_json<>::object_t, basic_json
#include "nlohmann/json_fwd.hpp"  // for json
#endif

using namespace cspot;

LoginBlob::LoginBlob(std::string name) {
#ifdef ESP_PLATFORM
  uint8_t mac[6];
  if (esp_read_mac(mac, ESP_MAC_WIFI_STA) != ESP_OK)
    throw std::runtime_error("device identity unavailable");
  char id[41];
  snprintf(id, sizeof(id), "0000000000000000000000000000%02x%02x%02x%02x%02x%02x",
           mac[0], mac[1], mac[2], mac[3], mac[4], mac[5]);
  this->deviceId = id;
#else
  char hash[32];
  snprintf(hash, sizeof(hash), "%016zu", std::hash<std::string>{}(name));
  this->deviceId = std::string("142137fd329622137a149016") + hash;
#endif
  this->crypto = std::make_unique<Crypto>();
  this->name = name;

  this->crypto->dhInit();
}

std::vector<uint8_t> LoginBlob::decodeBlob(
    const std::vector<uint8_t>& blob, const std::vector<uint8_t>& sharedKey) {
  if (blob.size() <= 36) throw std::invalid_argument("short login blob");
  // 0:16 - iv; 17:-20 - blob; -20:0 - checksum
  auto iv = std::vector<uint8_t>(blob.begin(), blob.begin() + 16);
  auto encrypted = std::vector<uint8_t>(blob.begin() + 16, blob.end() - 20);
  auto checksum = std::vector<uint8_t>(blob.end() - 20, blob.end());

  // baseKey = sha1(sharedKey) 0:16
  crypto->sha1Init();

  crypto->sha1Update(sharedKey);
  auto baseKey = crypto->sha1FinalBytes();
  baseKey = std::vector<uint8_t>(baseKey.begin(), baseKey.begin() + 16);

  auto checksumMessage = std::string("checksum");
  auto checksumKey = crypto->sha1HMAC(
      baseKey,
      std::vector<uint8_t>(checksumMessage.begin(), checksumMessage.end()));

  auto encryptionMessage = std::string("encryption");
  auto encryptionKey = crypto->sha1HMAC(
      baseKey,
      std::vector<uint8_t>(encryptionMessage.begin(), encryptionMessage.end()));

  auto mac = crypto->sha1HMAC(checksumKey, encrypted);

  // Check checksum
  if (mac != checksum) {
    throw std::invalid_argument("login blob MAC mismatch");
  }

  encryptionKey =
      std::vector<uint8_t>(encryptionKey.begin(), encryptionKey.begin() + 16);
  crypto->aesCTRXcrypt(encryptionKey, iv, encrypted.data(), encrypted.size());

  return encrypted;
}

uint32_t LoginBlob::readBlobInt(const std::vector<uint8_t>& data) {
  if (blobSkipPosition >= data.size()) throw std::invalid_argument("truncated login blob");
  auto lo = data[blobSkipPosition];
  if ((int)(lo & 0x80) == 0) {
    this->blobSkipPosition += 1;
    return lo;
  }

  if (blobSkipPosition + 1 >= data.size()) throw std::invalid_argument("truncated login blob");
  auto hi = data[blobSkipPosition + 1];
  this->blobSkipPosition += 2;

  return (uint32_t)((lo & 0x7f) | (hi << 7));
}

std::vector<uint8_t> LoginBlob::decodeBlobSecondary(
    const std::vector<uint8_t>& blob, const std::string& username,
    const std::string& deviceId) {
  auto encryptedString = std::string(blob.begin(), blob.end());
  auto blobData = crypto->base64Decode(encryptedString);

  crypto->sha1Init();
  crypto->sha1Update(std::vector<uint8_t>(deviceId.begin(), deviceId.end()));
  auto secret = crypto->sha1FinalBytes();
  auto pkBaseKey = crypto->pbkdf2HmacSha1(
      secret, std::vector<uint8_t>(username.begin(), username.end()), 256, 20);

  crypto->sha1Init();
  crypto->sha1Update(pkBaseKey);
  auto key = std::vector<uint8_t>({0x00, 0x00, 0x00, 0x14});  // len of base key
  auto baseKeyHashed = crypto->sha1FinalBytes();
  key.insert(key.begin(), baseKeyHashed.begin(), baseKeyHashed.end());

  if (blobData.size() < 16 || blobData.size() % 16)
    throw std::invalid_argument("invalid AES login blob");
  crypto->aesECBdecrypt(key, blobData);

  auto l = blobData.size();

  for (int i = 0; i < l - 16; i++) {
    blobData[l - i - 1] ^= blobData[l - i - 17];
  }

  return blobData;
}

void LoginBlob::loadZeroconf(const std::vector<uint8_t>& blob,
                             const std::vector<uint8_t>& sharedKey,
                             const std::string& deviceId,
                             const std::string& username) {

  auto partDecoded = this->decodeBlob(blob, sharedKey);
  auto loginData = this->decodeBlobSecondary(partDecoded, username, deviceId);

  // Parse blob
  blobSkipPosition = 1;
  blobSkipPosition += readBlobInt(loginData);
  blobSkipPosition += 1;
  this->authType = readBlobInt(loginData);
  blobSkipPosition += 1;
  auto authSize = readBlobInt(loginData);
  if (!authSize || authSize > 512 || blobSkipPosition > loginData.size() || authSize > loginData.size() - blobSkipPosition)
    throw std::invalid_argument("invalid credentials length");
  this->username = username;
  this->authData =
      std::vector<uint8_t>(loginData.begin() + blobSkipPosition,
                           loginData.begin() + blobSkipPosition + authSize);
}

void LoginBlob::loadUserPass(const std::string& username,
                             const std::string& password) {
  this->username = username;
  this->authData = std::vector<uint8_t>(password.begin(), password.end());
  this->authType =
      static_cast<uint32_t>(AuthenticationType_AUTHENTICATION_USER_PASS);
}

void LoginBlob::loadJson(const std::string& json) {
#ifdef BELL_ONLY_CJSON
  cJSON* root = cJSON_ParseWithLength(json.c_str(), json.size());
  auto type = cJSON_GetObjectItemCaseSensitive(root, "authType");
  auto user = cJSON_GetObjectItemCaseSensitive(root, "username");
  auto data = cJSON_GetObjectItemCaseSensitive(root, "authData");
  if (!cJSON_IsNumber(type) || !cJSON_IsString(user) || !cJSON_IsString(data)) {
    cJSON_Delete(root);
    throw std::invalid_argument("invalid stored login");
  }
  this->authType = type->valueint;
  this->username = user->valuestring;
  std::string authDataObject = data->valuestring;
  cJSON_Delete(root);
  this->authData = crypto->base64Decode(authDataObject);
#else
  auto root = nlohmann::json::parse(json);
  this->authType = root["authType"];
  this->username = root["username"];
  std::string authDataObject = root["authData"];

  this->authData = crypto->base64Decode(authDataObject);
#endif
}

std::string LoginBlob::toJson() {
#ifdef BELL_ONLY_CJSON
  cJSON* json_obj = cJSON_CreateObject();
  cJSON_AddStringToObject(json_obj, "authData",
                          crypto->base64Encode(authData).c_str());
  cJSON_AddNumberToObject(json_obj, "authType", this->authType);
  cJSON_AddStringToObject(json_obj, "username", this->username.c_str());

  char* str = cJSON_PrintUnformatted(json_obj);
  cJSON_Delete(json_obj);
  std::string json_objStr(str);
  free(str);

  return json_objStr;
#else
  nlohmann::json obj;
  obj["authData"] = crypto->base64Encode(authData);
  obj["authType"] = this->authType;
  obj["username"] = this->username;

  return obj.dump();
#endif
}

void LoginBlob::loadZeroconfQuery(
    std::map<std::string, std::string>& queryParams) {
  // Get all urlencoded params
  auto username = queryParams["userName"];
  auto blobString = queryParams["blob"];
  auto clientKeyString = queryParams["clientKey"];
  auto deviceName = queryParams["deviceName"];

  // client key and bytes are urlencoded
  auto clientKeyBytes = crypto->base64Decode(clientKeyString);
  auto blobBytes = crypto->base64Decode(blobString);

  if (clientKeyBytes.empty() || clientKeyBytes.size() > 96)
    throw std::invalid_argument("invalid client key");
  // Generated secret based on earlier generated DH
  auto secretKey = crypto->dhCalculateShared(clientKeyBytes);

  this->loadZeroconf(blobBytes, secretKey, deviceId, username);
}

std::string LoginBlob::buildZeroconfInfo() {
  // Encode publicKey into base64

  auto encodedKey = crypto->base64Encode(crypto->publicKey);
#ifdef BELL_ONLY_CJSON
  cJSON* json_obj = cJSON_CreateObject();
  cJSON_AddNumberToObject(json_obj, "status", 101);
  cJSON_AddStringToObject(json_obj, "statusString", "OK");
  cJSON_AddStringToObject(json_obj, "version", cspot::protocolVersion);
  cJSON_AddStringToObject(json_obj, "libraryVersion", cspot::swVersion);
  cJSON_AddStringToObject(json_obj, "accountReq", "PREMIUM");
  cJSON_AddStringToObject(json_obj, "brandDisplayName", cspot::brandName);
  cJSON_AddStringToObject(json_obj, "modelDisplayName", name.c_str());
  cJSON_AddStringToObject(json_obj, "voiceSupport", "NO");
  cJSON_AddStringToObject(json_obj, "availability", "");
  cJSON_AddNumberToObject(json_obj, "productID", 0);
  cJSON_AddStringToObject(json_obj, "tokenType", "default");
  cJSON_AddStringToObject(json_obj, "groupStatus", "NONE");
  cJSON_AddStringToObject(json_obj, "resolverVersion", "0");
  cJSON_AddStringToObject(json_obj, "scope",
                          "streaming,client-authorization-universal");
  cJSON_AddStringToObject(json_obj, "activeUser", this->username.c_str());
  cJSON_AddStringToObject(json_obj, "deviceID", deviceId.c_str());
  cJSON_AddStringToObject(json_obj, "remoteName", name.c_str());
  cJSON_AddStringToObject(json_obj, "publicKey", encodedKey.c_str());
  cJSON_AddStringToObject(json_obj, "deviceType", "SPEAKER");

  char* str = cJSON_PrintUnformatted(json_obj);
  cJSON_Delete(json_obj);
  std::string json_objStr(str);
  free(str);

  return json_objStr;
#else
  nlohmann::json obj;
  obj["status"] = 101;
  obj["statusString"] = "OK";
  obj["version"] = cspot::protocolVersion;
  obj["spotifyError"] = 0;
  obj["libraryVersion"] = cspot::swVersion;
  obj["accountReq"] = "PREMIUM";
  obj["brandDisplayName"] = cspot::brandName;
  obj["modelDisplayName"] = name;
  obj["voiceSupport"] = "NO";
  obj["availability"] = this->username;
  obj["productID"] = 0;
  obj["tokenType"] = "default";
  obj["groupStatus"] = "NONE";
  obj["resolverVersion"] = "0";
  obj["scope"] = "streaming,client-authorization-universal";
  obj["activeUser"] = "";
  obj["deviceID"] = deviceId;
  obj["remoteName"] = name;
  obj["publicKey"] = encodedKey;
  obj["deviceType"] = "SPEAKER";

  return obj.dump();
#endif
}

std::string LoginBlob::getDeviceId() {
  return this->deviceId;
}
std::string LoginBlob::getDeviceName() {
  return this->name;
}
std::string LoginBlob::getUserName() {
  return this->username;
}
