chanulee/audiostream-esp32/firmware/components/boards/esp32-generic/board.c

/**
 * @file board.c
 * @brief LOVELACE AS-003 to AS-008 board implementation (same pins)
 *
 * PCM5102A is configured by strap pins (I2S, internal PLL); its XSMT soft
 * mute is the mute GPIO. It starts muted: audio_output.c unmutes once the I2S
 * clocks run, so boot, reset and clock changes do not pop.
 */

#include "iot_board.h"

#include "driver/gpio.h"
#include "esp_check.h"
#include "esp_log.h"

static const char TAG[] = "LOVELACE";

static bool s_board_initialized = false;

#if defined(CONFIG_MUTE_GPIO) && CONFIG_MUTE_GPIO >= 0
static esp_err_t init_mute_gpio(void) {
  if (CONFIG_MUTE_GPIO < 0) {
    return ESP_OK;
  }

  gpio_config_t io_conf = {
      .pin_bit_mask = (1ULL << CONFIG_MUTE_GPIO),
      .mode = GPIO_MODE_OUTPUT,
      .pull_up_en = GPIO_PULLUP_DISABLE,
      .pull_down_en = GPIO_PULLDOWN_DISABLE,
      .intr_type = GPIO_INTR_DISABLE,
  };
  esp_err_t err = gpio_config(&io_conf);
  ESP_RETURN_ON_ERROR(err, TAG, "Failed to configure mute GPIO");

  // Start muted; audio_output.c releases the mute once I2S is clocking.
  gpio_set_level(CONFIG_MUTE_GPIO, CONFIG_MUTE_GPIO_LEVEL);

  ESP_LOGI(TAG, "Mute GPIO %d initialized (active %s, muted)",
           CONFIG_MUTE_GPIO, CONFIG_MUTE_GPIO_LEVEL ? "high" : "low");
  return ESP_OK;
}
#endif

const char *iot_board_get_info(void) {
  return BOARD_NAME;
}

bool iot_board_is_init(void) {
  return s_board_initialized;
}

board_res_handle_t iot_board_get_handle(int id) {
  (void)id;
  return NULL;
}

esp_err_t iot_board_init(void) {
  if (s_board_initialized) {
    ESP_LOGW(TAG, "Board already initialized");
    return ESP_OK;
  }

#if defined(CONFIG_MUTE_GPIO) && CONFIG_MUTE_GPIO >= 0
  esp_err_t err = init_mute_gpio();
  if (err != ESP_OK) {
    return err;
  }
#endif

  s_board_initialized = true;
  ESP_LOGI(TAG, "Board initialized");
  return ESP_OK;
}

esp_err_t iot_board_deinit(void) {
  s_board_initialized = false;
  return ESP_OK;
}
