chanulee/audiostream-esp32/firmware/components/spotify/cspot/src/ApResolve.cpp

#include "ApResolve.h"

#include <stdexcept>
#include <initializer_list>  // for initializer_list
#include <map>               // for operator!=, operator==
#include <memory>            // for allocator, unique_ptr
#include <string_view>       // for string_view
#include <vector>            // for vector

#include "HTTPClient.h"  // for HTTPClient, HTTPClient::Response
#ifdef BELL_ONLY_CJSON
#include "cJSON.h"
#else
#include "nlohmann/json.hpp"      // for basic_json<>::object_t, basic_json
#include "nlohmann/json_fwd.hpp"  // for json
#endif

using namespace cspot;

ApResolve::ApResolve(std::string apOverride) {
  this->apOverride = apOverride;
}

std::string ApResolve::fetchFirstApAddress() {
  if (apOverride != "") {
    return apOverride;
  }

  auto request = bell::HTTPClient::get("https://apresolve.spotify.com/");
  std::string_view responseStr = request->body();

  // parse json with nlohmann
#ifdef BELL_ONLY_CJSON
  cJSON* json = cJSON_ParseWithLength(responseStr.data(), responseStr.size());
  auto first = cJSON_GetArrayItem(cJSON_GetObjectItemCaseSensitive(json, "ap_list"), 0);
  if (!cJSON_IsString(first) || !first->valuestring[0]) {
    cJSON_Delete(json);
    throw std::runtime_error("Invalid Spotify access point response");
  }
  std::string ap_string(first->valuestring);
  cJSON_Delete(json);
  return ap_string;
#else
  auto json = nlohmann::json::parse(responseStr);
  return json["ap_list"][0];
#endif
}
