chanulee/audiostream-esp32/(commit log)

2026-10-13 Integrate AirPlay and Spotify Connect with PCM capture on ESP32-S3
2026-10-15 Move LOVELACE to ESP32-WROVER (AS-002 rev C) and prepare the first board
    Firmware drops the S3/other-board support for one ESP32-WROVER-E-N8R8
    target with AirPlay, Spotify Connect and Bluetooth A2DP sharing a single
    I2S writer. The DAC's XSMT soft mute moves to GPIO22 (pulled down):
    audio_output.c unmutes once I2S runs and mutes around every clock change
    and restart.
    Hardware adds the scripted AS-002 rev C board (37 x 41 mm, 4 layers):
    - AUX jack nets follow the real PJ-320D contacts (tip on the rear pad).
    - DAC rail held up by RB551V + 220 uF so unplugging USB does not pop.
    - jlc_check.py writes the CPL in JLC's rotation/origin and checks every
    part against JLC's footprint data, stock an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
2026-10-15 Raise the board to AS-003 rev A and archive every earlier version
    The AS-002 rev C netlist changed (AUX jack nets, XSMT mute, DAC hold-up),
    so the current design becomes AS-003 rev A in hardware/lovelace-as-003.
    Its ID and revision live only in plan_pcb.py and feed the silkscreen,
    title blocks, renders, release zip name and the silkscreen editor.
    Earlier boards move to numbered folders in hardware/archive (01 S3 rev A,
    02 AS-001, 03 AS-002 rev B, 04 AS-002 rev C), each rendered the same way.
    hardware/versions.json drives a version history on the render page and
    in hardware/archive/index.html. The silkscreen editor and its tests find
    the current board through versions.json.
    Firmware goes to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
2026-10-16 Review AS-003 before ordering and keep vias off top SMD pads
    - pinout_check.py: netlist against a pin table written from the vendor
    datasheets (138 checks), run by make_board.sh after placement
    - sim/power_path.py: ngspice behavioural model of the power path (eFuse
    start-up, ESP32 pulsed load, C25 hold-up on unplug)
    - Router passes that place vias use --same-net-pad-clearance 0.1; OVLO and
    ILIM at the eFuse QFN are drawn in build_pcb.py; test-pad vias stay off
    top pads; audio copper is locked after its pass so later passes cannot
    move DAC_L/R onto B.Cu
    - audit_pcb.py fails on any via touching a top SMD pad (was 10, now 0)
    - REVIEW_NETLIST.md, REVIEW_LAYOUT.md, BRINGUP.md: findings,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
2026-10-16 Raise the board to AS-004 rev A after the routing-only via fix
    AS-003 rev A had shipped two Gerber sets under one name (before and after
    the via-in-pad fix). The fixed layout becomes AS-004 rev A: same netlist,
    parts and placement as AS-003, identical copper to the fixed AS-003
    release; only the board number on the silkscreen differs.
    - hardware/lovelace-as-003 -> hardware/lovelace-as-004 (BOARD_ID AS-004),
    regenerated: DRC/ERC/parity 0, vias touching top SMD pads 0
    - AS-003 rev A archived as hardware/archive/05-lovelace-as-003-revA
    (board, schematic, release zip, review docs, renders)
    - Silkscreen text AS-004 rev A; audit_pcb.py now fails when the silk does
    not show the board's own I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
2026-10-16 Add AS-004 rev A 3D views, schematic and layer exports
2026-10-16 Raise the board to AS-005 rev A for the PJ-320D land; fix the DAC mute wait
    Independent review of AS-004 rev A (archived with it):
    - J2 land now follows the Shou Han PJ-320D drawing: locating NPTH 1.5 ->
    1.0 mm, pad width 1.2 -> 1.5 mm, as LOVELACE:Jack_3.5mm_PJ320D_Horizontal_
    ShouHan (silk trimmed clear of the wider pads). Netlist, placement,
    routing (424 tracks/vias) and CPL unchanged. DRC/ERC/parity 0, Gerber
    netcheck clean.
    - AS-004 rev A archived as hardware/archive/06-lovelace-as-004-revA;
    hardware/lovelace-as-004 -> lovelace-as-005, silk AS-005 rev A,
    versions.json and docs updated. Firmware env keeps its name.
    - audio_output.c: the 5 ms soft-mute wait was 0 ticks at 100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
2026-10-16 Add render_extra.sh and the AS-005 rev A 3D views, schematic and layer exports
2026-10-16 Raise the board to AS-006 rev A: J2 pads where the PJ-320D drawing puts them
    - J2 land: pads 3.85 mm off the plug axis as in the Shou Han drawing,
    2.0 mm long (drawing 1.6 mm + 0.2 mm each end), covering 2.85-4.85 mm
    instead of KiCad's 2.0-4.5 mm (partly under the body, tip not covered).
    - J2 moves 0.3 mm left (x 31.7) so the tip pad keeps 0.45 mm to the edge;
    board stays 37 x 41 mm, rerouted (96 vias, audio still F.Cu only).
    - jlc_check.py places J2 on its locating pegs, not the pad average (AS-005
    had the pegs 0.125 mm off, the whole play); peg error now 0.000 mm.
    - AS-005 rev A archived as hardware/archive/07-lovelace-as-005-revA.
    Placement 0/0, DRC/ERC/parity 0, release audit 0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
2026-10-16 Add LCSC/EasyEDA STEP models for J1, J2 and U1
    KiCad ships no 3D model for the HRO TYPE-C-31-M-12, the PJ-320D or the
    WROVER-E, so the PCBA renders showed bare pads. The EasyEDA STEP models
    (C165948, C431535, C2973667) now live in lib/3d: J2 and U1 reference them
    from the LOVELACE footprints, J1 gets its model in build_pcb.py because the
    library footprint is copied from KiCad on every build. Offsets come from the
    EasyEDA model origin and were checked in the renders (terminals and shell
    legs on their pads). Copper unchanged; DRC/ERC 0, netcheck clean.
2026-10-16 Place the PJ-320D model on its locating pegs
    The J2 STEP offset had been set by eye from the terminals and sat 0.94 mm
    inside the board: the bottom render showed the pegs short of the NPTH
    holes and the body face inside the edge. Offset -6.025 -> -6.965 mm puts the
    pegs on the hole centres and the body face 0.25 mm past the edge, as the
    Shou Han drawing gives. Fabrication geometry unchanged (aperture numbering
    only); placement 0/0, DRC/ERC 0, netcheck clean, JLC peg error 0.000 mm.
2026-10-16 Rebuild the AS-006 rev A board, release and renders
    Regenerated with make_board.sh and render_extra.sh from the committed
    sources. Fabrication geometry unchanged (timestamps and aperture numbering);
    placement 0/0, DRC/ERC/parity 0, JLC 53/53, release audit 0/0, netcheck clean.
2026-10-16 Sit the PJ-320D model on the board surface
    The EasyEDA z offset (-0.55 mm) left the jack body 3 mm below the top
    surface in the side views. z = +2.51 mm puts the body on the board and
    the pegs 0.6 mm into their holes; the body is 5.1 mm tall in the front
    view (drawing 5.0 mm). Renders only; fabrication geometry unchanged.
2026-10-16 Re-render the AS-006 views with the J2 model on the board surface
2026-10-16 Add requested AS-004 Rev A board renders
    Add assembly, PCB, copper-layer, and routing render images with pixel-difference previews for the archived board revision.
2026-10-16 Raise the board to AS-007 rev A: J2 wired as LCSC's engineer gives it
    LCSC's engineer (2026-10-16) gives the PJ-320D terminals as A = tip,
    D = ring 1, C = ring 2, B = sleeve, matching the drawing's contact
    schematic. AS-003 to AS-006 assumed the terminals sit where their contacts
    touch the plug and had D = GND, B = LINE_R: the right channel would have
    been grounded at the plug and driven into the far end's ground.
    - J2: D (KiCad R2) = LINE_R, C (R1) = GND, B (T) = GND, A (S) = LINE_L.
    - D2 (LINE_R ESD) moves beside the new LINE_R pad (25.0, 33.9); rerouted,
    audio still F.Cu only with no vias (LINE_R 24.4 -> 29.2 mm).
    - audit_pcb.py checks the new face-to-rear order; pinout_check.py gains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
2026-10-16 Add interactive PCB SVG renders
    Document the rendering tools under `rendering/`, add vector top, isometric, and back-silkscreen views with an interactive viewer, and correct USB-C and audio-jack STEP model offsets.
2026-10-16 Rebuild AS-007 with the merged J1/J2 model offsets; note C25 derating
    The USB-C model now sits on the board with its shell front on the
    footprint outline and its legs in the slots; the old offset was a model
    error, the J1 copper is unchanged. Renders and extra views regenerated.
    REVIEW.md gains the C25 derating check (T520: 90 % of rating for <= 10 V).
2026-10-16 Add interactive PCB rendering tools
    Add a local WebGL viewer and STEP-to-SVG pipeline with board discovery, model auditing, back-silkscreen rendering, and regression tests. Include KiCad model caching and color/material rendering support.
2026-10-16 Run the AS-007 renders from rendering/
    3cef11e added rendering/ with path-adjusted copies of render_board.py,
    render_extra.sh and render_placement.py; the old copies at the board root
    are removed and make_board.sh calls rendering/render_board.py. Renders
    regenerated from the new location.
2026-10-16 Export the X-ray view's translucent faces to SVG; pick Python 3.10-3.13 in run.sh
    - render_svg.xray_faces(): the viewer's triangles with its alpha,
    opacity x (0.2 + 0.8 (1 - |n.v|)^2), in 24 steps; connected same-step
    triangles facing the same way merge into one region (outline + holes),
    regions stay separate so overlaps stack. Edges at 0.38 opacity, no back
    silk, as on screen. The export sends the face-opacity slider value.
    At -65/38 the covered area matches the canvas (1091 vs 1090 mm2); total
    light is about 82 % of the additive canvas. plus-lighter blending was
    tried and dropped: Chrome rasterised the image blank.
    - run.sh picks python3.13 -> 3.10 -> python3 and rebuilds a .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
2026-10-18 Raise the board to AS-008 rev A: 0.45 mm USB vias and a DNP ITIMER land
    From the kicad-happy review of AS-007 (REVIEW_KICAD_HAPPY.md):
    - The 4 USB_DM vias go from 0.4 / 0.2 to 0.45 / 0.2 mm (JLC multilayer
    standard minimum); the USB net class and board minimum follow, so no
    via is under 0.45 mm and the smallest annular ring is 0.125 mm.
    - U6 ITIMER (pin 10) gets C26, a not-fitted 0402 land to GND on 2 mm of
    F.Cu. TPS259470A keeps ITIMER open for the fastest response; 1-10 nF
    here would let transients between ILIM and 2 x ILIM pass for about
    0.8 ms/nF (SLVSFC9C eq. 8) if Wi-Fi peaks hit the limit on first boards.
    C26 is DNP in schematic and board, has no BOM/CPL line, and its pads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
2026-10-18 Describe the ITIMER land as current-limit blanking, not a trip; re-render AS-008
    TPS259470A is the active-current-limit variant: above ILIM it holds the
    output at ILIM (thermal shutdown and 110 ms retry only if that lasts). C26
    only lets transients between ILIM and 2 x ILIM through for about 0.8 ms/nF.
    README, BRINGUP, REVIEW_KICAD_HAPPY, REVIEW_NETLIST, plan_pcb.py comment,
    versions.json and the archive/09 README now say so. Renders regenerated.
2026-10-20 Strengthen AS-008 validation and OTA recovery
    Expand PCB checks for component values, nets, and population; validate simulation completion and JLC stock before release; and add regression tests and bring-up documentation. Restart the AirPlay RTSP server after OTA failures.
2026-10-22 Add Figma PCB silkscreen workflow
    Add a Figma plugin and local KiCad bridge for importing, checking, and saving board silkscreen, with release generation that preserves placement and copper. Expand the web editor with project variants, module and hole editing, zoom, and undo/redo, and add tests and usage documentation.
2026-10-29 Add PCB playbook: lessons from AS-001 to AS-008
